abarriuso/bay2rack/README.md

# Bay2Rack — old PC case → 6" homelab rack

*[Leer en español](README.es.md)* · 

Towers used to come with 5.25" bays for CD drives. New cases don't, but ATX hasn't changed: that old case still
takes a modern motherboard. **Bay2Rack** is a parametric OpenSCAD adapter that screws into those bays and turns them
into a **6" mini rack**, so an old tower becomes the heart of a cheap homelab: a router with VLANs, switches,
KVM over IP, Raspberry Pi blades and a patch panel, right in the front of the case.

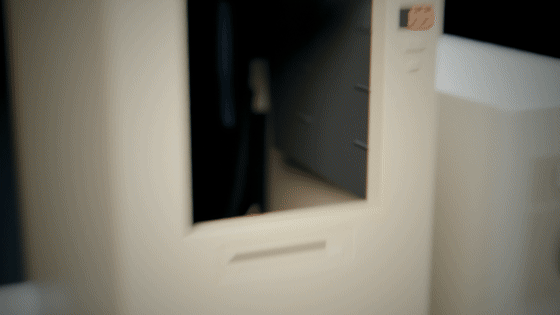
[picture p1: docs/video/assemble.gif]
A beige 90s sleeper unfolds: a modern server inside, its 5.25" bays become a rack


> **[Open the web generator](https://bay2rack.pages.dev/)** ([mirror](https://abarriuso.github.io/bay2rack/) if that
> address does not load): say what you want in the bays (a fan or buttons, sockets, or a rack for devices), choose
> what goes in every rack unit and every patch panel port, see it mounted in a real PC case (or a 90s sleeper), and
> download a **kit (.zip)** with every STL, the bill of materials and the print settings. It all runs in your browser.
>
> **Just want to print?** Pre-built variants are in [`stl/`](stl/README.md), with the screws and inserts they need.
> Print the [test pieces](stl/README.md#tests) first and [tune the print fits](#printing).
>
> **Building one?** The [build guide](docs/BUILD.md) covers what to buy, the print order, the inserts, the
> assembly and the cables and power.

> **Work in progress.** Found a defect, a part that doesn't fit your case or a print problem? [Open an issue](https://github.com/abarriuso/bay2rack/issues)
> with photos and your case model. Measurements of other cases and rack gear, new modules and fixes are welcome as
> pull requests. Cases reported so far: [compatibility list](docs/CASES.md) · changes: [CHANGELOG](CHANGELOG.md).

Evolution of the original
[6" mini rack switch + patch panel in a 5.25" bay](https://www.reddit.com/r/minilab/comments/1vr8vc1/6_mini_rack_switch_patch_panel_in_525_bay/).

---

## What you can build

| | |
|---|---|
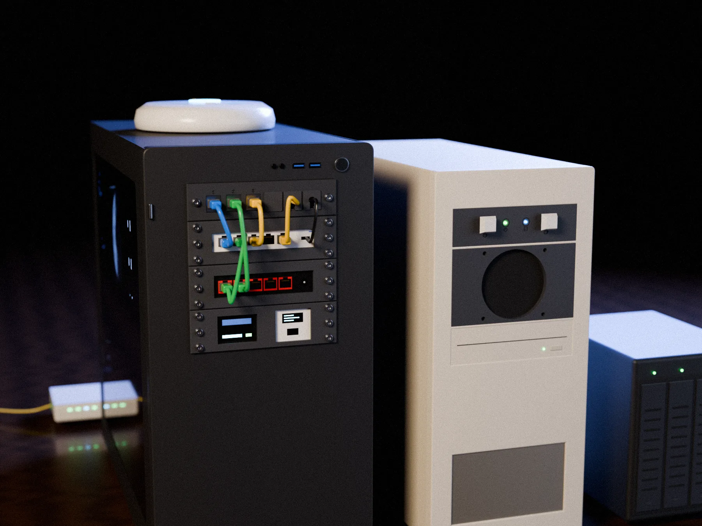
[picture p2: docs/gallery/router.webp]
Router with VLANs
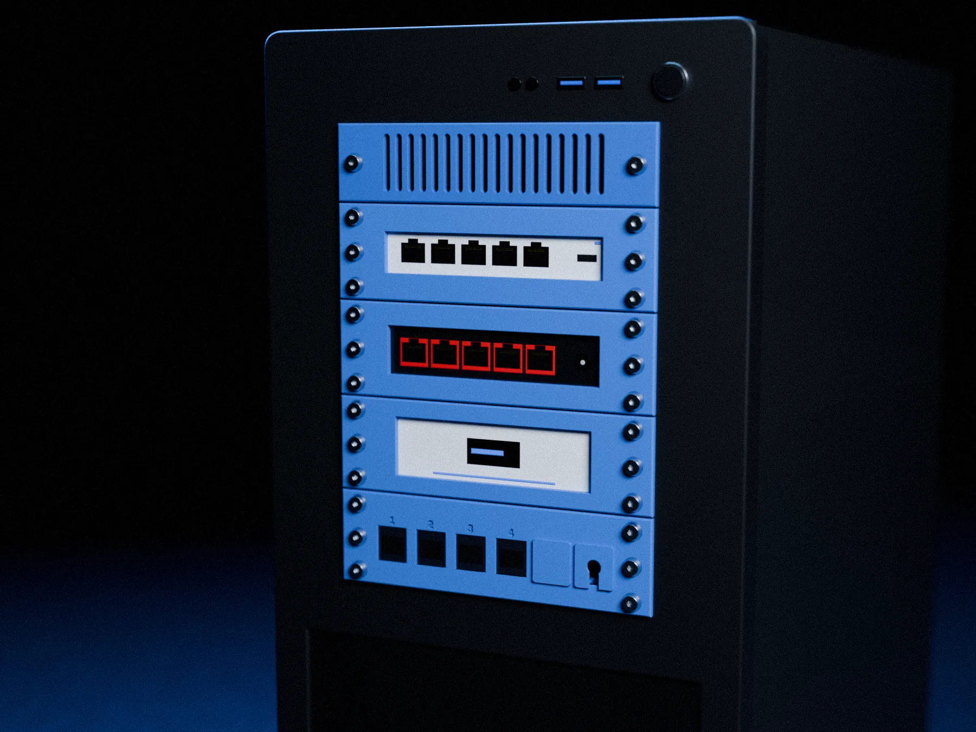
[picture p3: docs/gallery/network.webp]
Network rack
|  **Router with VLANs**: the PC runs OPNsense / pfSense with a 4-port network card; a managed UniFi switch carries the VLANs, a second switch the servers, JetKVM + NanoKVM, patch panel |  **Network rack**: 5 bays, two switches, a UniFi Express and a full patch panel |
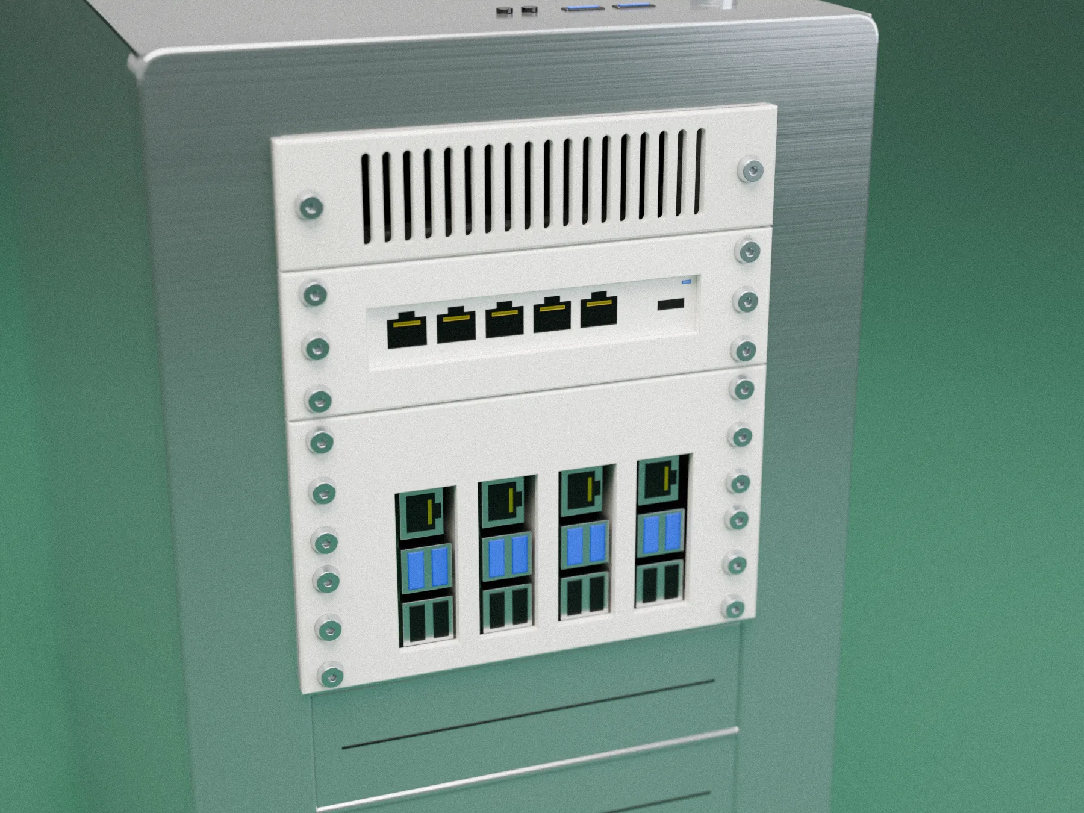
[picture p4: docs/gallery/pi.webp]
Raspberry Pi cluster
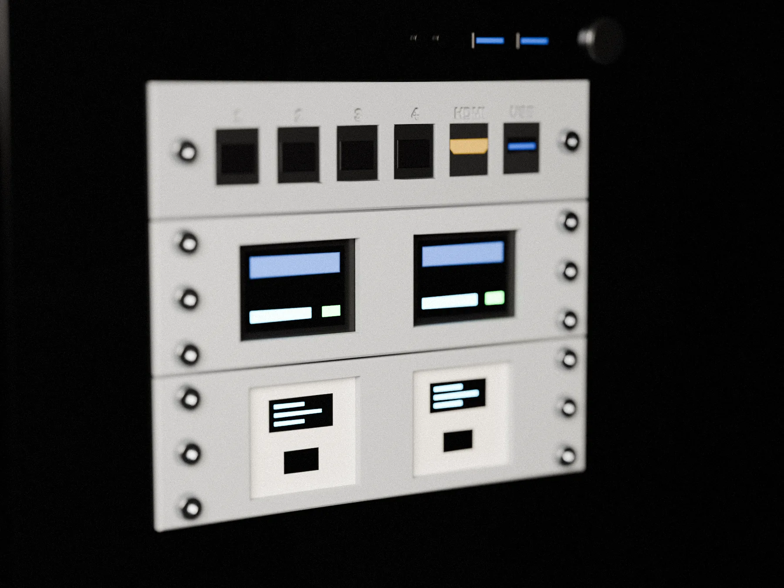
[picture p5: docs/gallery/kvm.webp]
KVM over IP
|  **Raspberry Pi cluster**: a UniFi switch and four Raspberry Pi 5 standing as 2U blades |  **KVM over IP**: two trays, two JetKVM and two NanoKVM, HDMI and USB keystones |
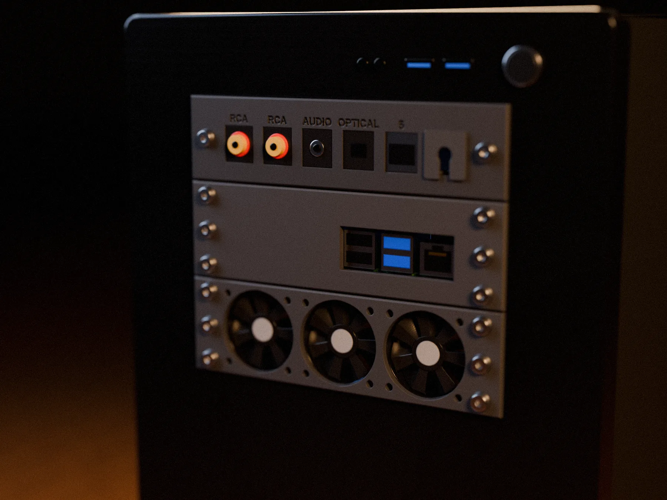
[picture p6: docs/gallery/audio.webp]
Audio
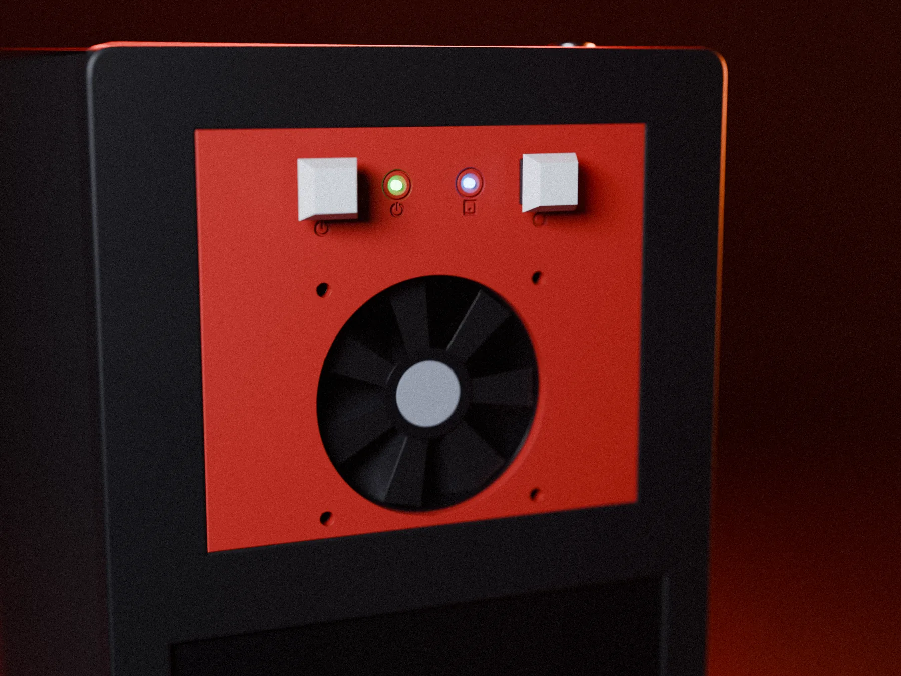
[picture p7: docs/gallery/client.webp]
Proxmox / TrueNAS box
|  **Audio**: a Raspberry Pi 4 streamer, three 40 mm fans, RCA, 3.5 mm jack and Toslink keystones |  **Proxmox / TrueNAS box**: no rack, just a front panel with an 80 mm fan and a power / reset button panel |
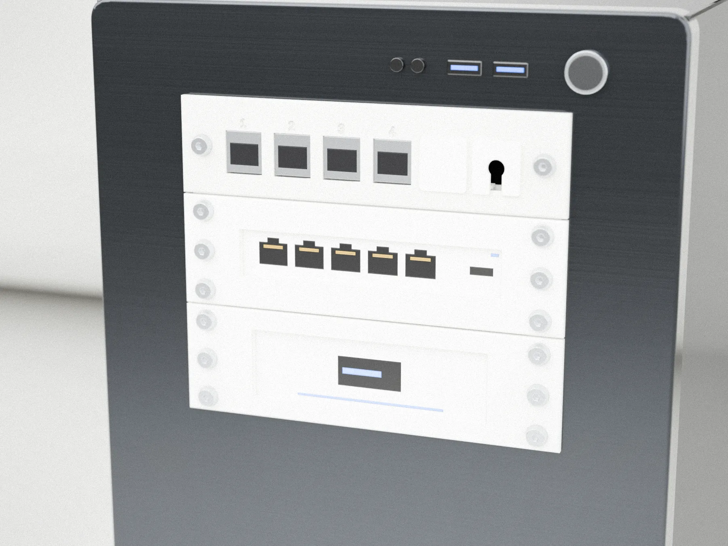
[picture p8: docs/gallery/unifi.webp]
UniFi
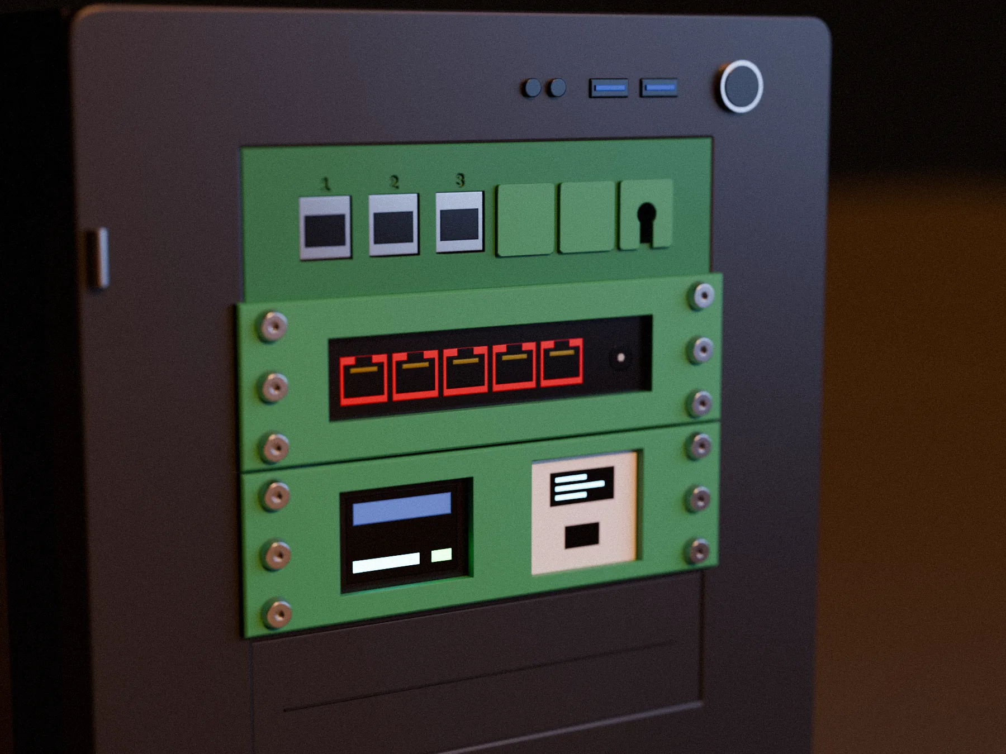
[picture p9: docs/gallery/bezel.webp]
CD-drive front
|  **UniFi**: Flex Mini switch and UniFi Express |  **CD-drive front**: an exact 5.25" bezel, flush with the case front |

## A homelab from old PCs

The router keeps its rack in the bays: the switches, the KVMs over IP and the patch panel. The network cables of the
other machines (a Proxmox node, a TrueNAS box and an access point) come in through **printed brackets in two PCI
slots** at the back and end in the keystones behind the patch panel; short patch cords on the front connect them to
the switches. Cable colours are VLANs: clients, servers, the trunk to the access point and the WAN from the
router's network card to the fibre box.

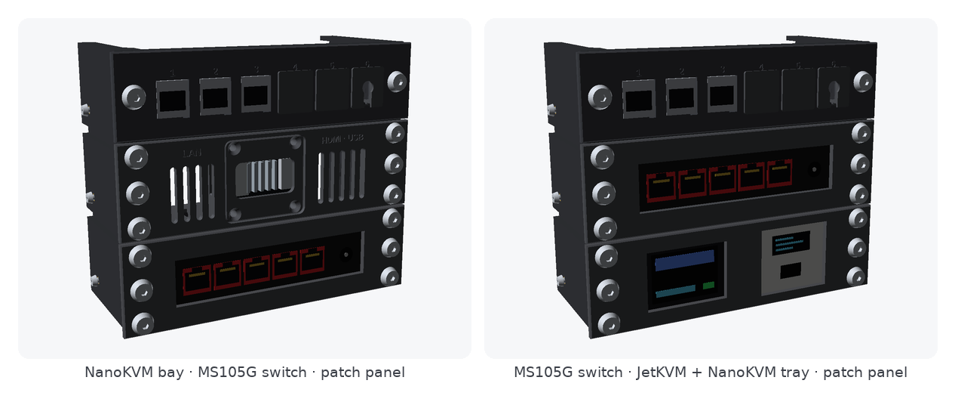
[picture p10: docs/img/homelab.png]
The rack with the NanoKVM bay, the switch and the patch panel


## The height problem

A 5.25" bay is 41.53 mm tall and stacked bays repeat every ~43.18 mm. A rack unit is 44.45 mm.
So **N bays never hold N U inside the stack**. The deficit grows by 1.27 mm per bay:

| Bays | Stack height | Flush (inside the stack) | Spare zone | Overhang (N U) | Panels stick out |
|-----:|---:|---:|---:|---:|---:|
| 1 | 41.1 mm | 0U | 41.1 mm | 1U | +3.3 mm |
| 2 | 84.3 mm | 1U | 39.9 mm | 2U | +4.6 mm |
| 3 | 127.5 mm | 2U | 38.6 mm | 3U | +5.9 mm |
| 4 | 170.7 mm | 3U | 37.3 mm | 4U | +7.1 mm |
| 5 | 213.9 mm | 4U | 36.1 mm | 5U | +8.4 mm |
| 6 | 257.0 mm | 5U | 34.8 mm | 6U | +9.7 mm |

The design handles this with **one parametric model** instead of one model per bay count.

## Variants

Two independent choices give four families. The pre-built files cover 1–3 bays (1–4 for `plate-flush`); the model goes up to 6:

| | **Flush**: N−1 U + spare zone, nothing sticks out | **Overhang**: N bays = N U |
|---|---|---|
| **Plate front**: flat frame behind the rack panels | `plate-flush`: the spare zone takes a **swappable filler** (6-port patch, vent, blank) | `plate-overhang`: the frame is a few mm taller than the stack |
| **Bezel front**: the exact outline of stacked 5.25" drive bezels | `bezel-flush`: flush with the case front like an original drive, patch panel cut into the bezel | `bezel-overhang`: the bezel stays flush, only the rack panels overlap the case front |

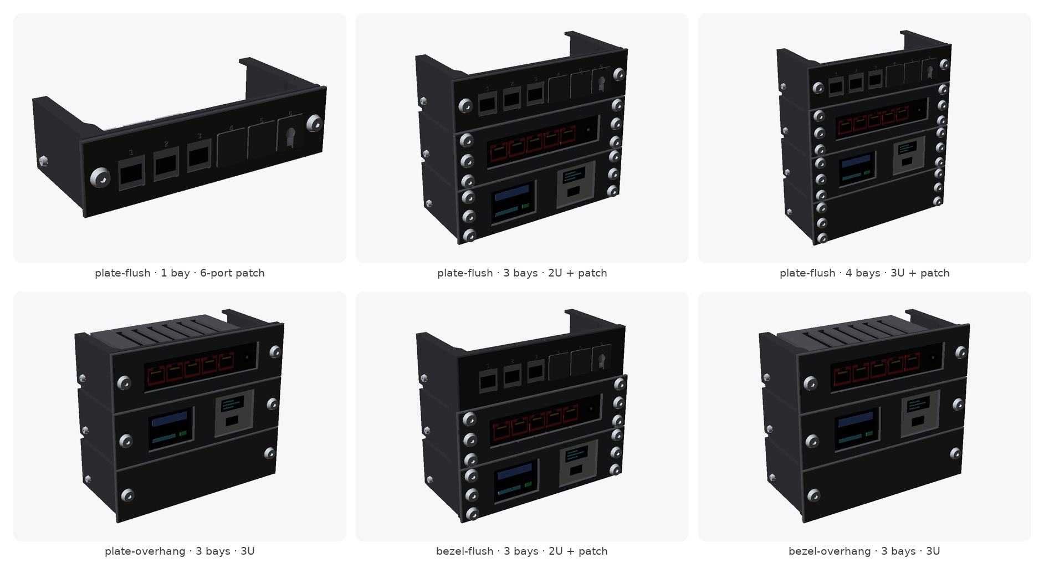
[picture p11: docs/img/variants.png]
The four families


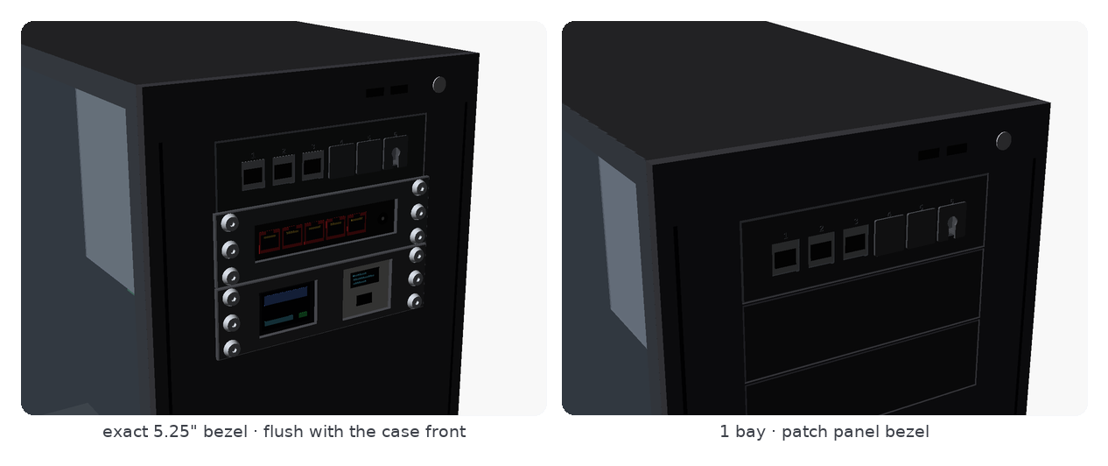
[picture p12: docs/img/mounted.png]
Mounted in a PC tower


Use the plate front when your case front is flat at the drive bays. If the case has a plastic front that
stands out from the metal, use the bezel front and set `bezel_depth` to how far that front stands out.

Other knobs: `units_override`, `overhang_align` (center/top/bottom), `spare_pos` (top/bottom/split),
and the spare-zone fill (`keystone`, `buttons`, `vent`, `cable`, `label`, `fan40`, `fan60`, `fan80`, `fan92`, `fan120`, `blank`).
The fill can be `separate` (a screw-on panel in the same plane as the rack accessories) or `integral` (cut into the frame).

## Rack modules

`rack_modules` lists what goes in every rack unit, top first. Every module is a separate print (1U; the blades and the 60 / 80 mm fans 2U,
the 92 / 120 mm fans 3U) that screws to the rack holes:

| Module | |
|---|---|
| `ms105g` | 5-port switch, **Mercusys MS105G** size (105 × 24.9 × 70 mm, W × H × D; set your switch's size): it slides into a tunnel from the back, the front window leaves the 5 ports and the power jack free, a zip tie behind it holds it |
| `uswflex`, `ux` | **UniFi USW-Flex-Mini** (managed, VLANs) and **UniFi Express** in the same kind of tunnel |
| `kvm:jet+nano` | **KVM over IP tray**: 1 to 3 boxes of your choice side by side (`jet` JetKVM, `nano` NanoKVM, `custom`), e.g. `kvm:nano+nano`; it warns when they don't fit |
| `pi:pi5` | **Raspberry Pi tray**: Pi 5 / 4 / 3 or Zero flat on M2.5 standoffs, USB and Ethernet through the front; two boards side by side with PoE HATs |
| `piblade:pi5+pi5+pi5+pi5` | **2U Raspberry Pi blades**: up to four boards on edge, each on its own fin, standoffs that print without supports |
| `nkvm:side` / `nkvm:ks` | **NanoKVM Lite bay** with a lid on M3 heat-set inserts, the heatsink in the open. `side`, **outside the case**: standing in a little mountain, its ports open at both sides so you plug in from outside; the cables run outside or into the case through slots at the ends; three pieces (plate, mountain, lid), `nkvm_split = false` prints the plate and the mountain in one. `ks`, **inside the case**: the Ethernet port comes out at keystone 1 (`nkvm_keystones = 2` adds a second one), the NanoKVM flat right behind it with a straight 10 cm patch cable (`nkvm_patch`); two pieces |
| `dev1`, `dev2` | A made-to-measure tray for any device: set its width, height and depth |
| `fan40`, `fan60`, `fan80`, `fan92`, `fan120` | **Fan panels**: up to three 40 mm fans in 1U, two 60 mm or one 80 mm in 2U, one 92 mm or 120 mm in 3U, behind round openings or a hex grille (`fan_guard`); `fan_count` caps how many go side by side |
| `patch` | 1U patch panel with the ports you choose: a bare `patch` takes `ks_ports_list` / `ks_names`, `patch:rj45m=NAS+hdmi+cover` has its own (port type, `=` its name, `_` for a space) |
| `buttons` | 1U button panel (see below) |
| `vent`, `blank`, `cable`, `label` | Vented (slots, louvres, honeycomb or holes), blank, cable pass-through and label panels (`label` says `label_text`, `label:MY_LAB` its own text) |

A module can take more than one unit (the blades and the bigger fans): the rack is filled from the top and a module that no
longer fits becomes a blank.

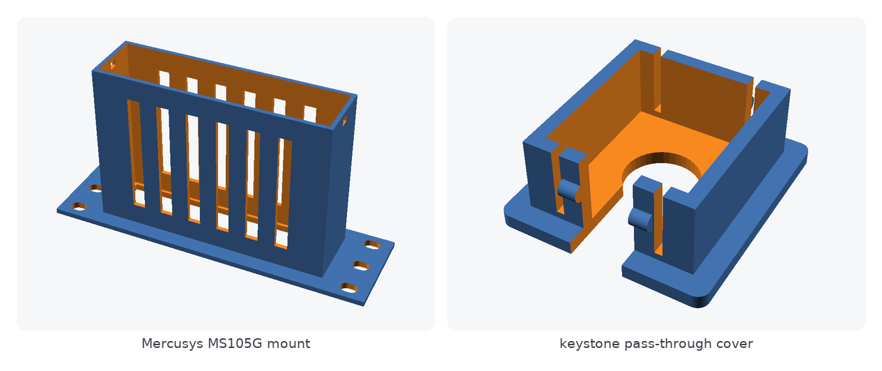
[picture p13: docs/img/modules.png]
Switch mount and keystone pass-through cover


## Keystones

The patch panel takes up to 6 ports in a 1U row and more rows when it is taller (12 in a 2U panel), with engraved
numbers or your own names (`ks_names`).
`ks_ports_list` sets **every port**: `rj45m` (metal / shielded RJ45), `rj45`, `hdmi`, `usb`, `rca`, `jack` (3.5 mm),
`toslink` (standard keystones),
`cover` (a plain printed cover for an unused port), `pass` (a split pass-through cover that clips around a cable, e.g.
the switch power cable) or `none`. Both covers are pushed in from the front and click behind the opening.

- **Metal holder cell** (default, `ks_style = metal`), replicated from the original bay adapter: a 15 × 16.5 mm front
  opening, a latch ramp, a 24.3 mm cavity and rear lips that catch the jack, which goes in from the back. It is 9.5 mm
  deep, with 2 mm walls and a 20 mm pitch; every dimension is a parameter (`ksm_*`).
- **Standard cut-out**: 14.9 × 16.4 mm in a 2 mm plate for plastic snap-in keystones (HDMI, USB and plastic RJ45 use it).

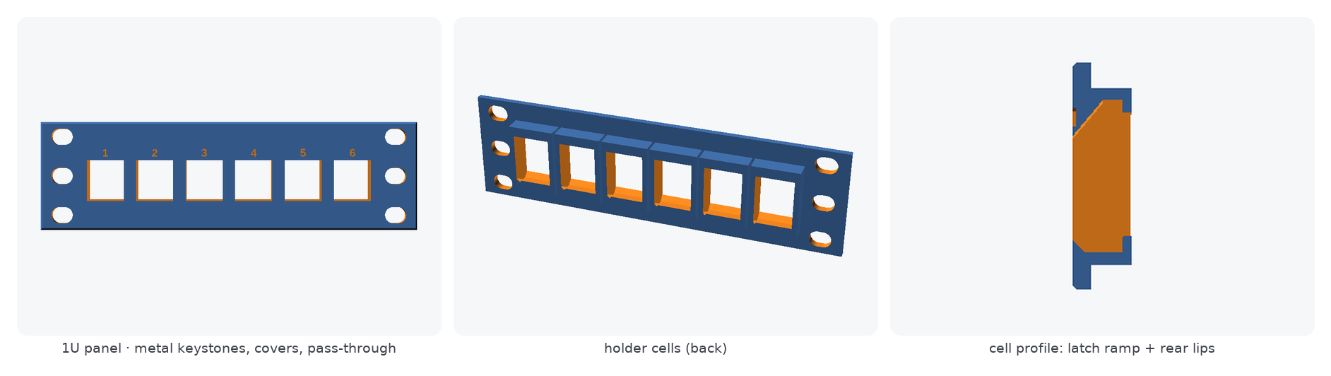
[picture p14: docs/img/keystone.png]
Metal keystone holder


## Button panel

A fill or a 1U module with **power and reset buttons** plus **power and disk-activity LEDs** (3 or 5 mm), wired to
the motherboard's front-panel header. Three kinds of button (`btn_type`):

- `mx`: normal keyboard switches (Cherry MX compatible: 14 mm cut-out in a 1.5 mm plate, any 1u keycap).
- `metal`: the metal push buttons sold for PC cases, 12–22 mm (`btn_metal_d`), with their LED ring.
- `retro`: printed caps on 12 × 12 mm tactile switches held by a printed carrier, a big POWER, RESET and an
  optional TURBO (`btn_turbo`) like the beige 90s PCs, with named LEDs and pinstripes.

Three LED designs, all printable front face down:

- `ring`: a countersunk hole with an engraved ring; the LED dome sticks out by `led_protrude`.
- `halo`: a thin ring of light around each key.
- `glow`: invisible when off; the LED shines through a 0.6 mm skin and the engraved icon lights up (print it in white or natural).

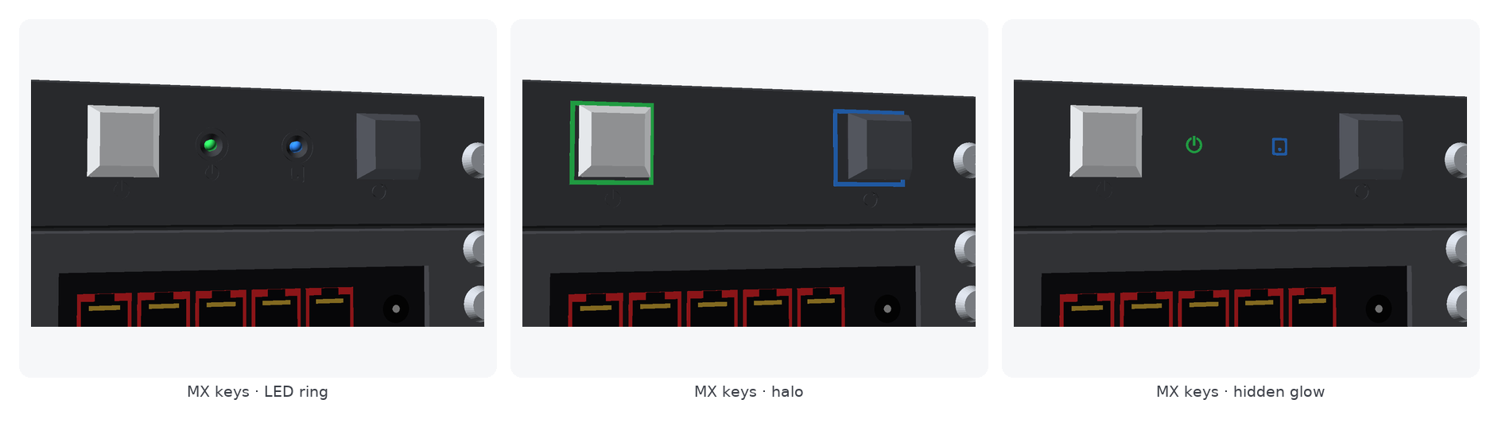
[picture p15: docs/img/buttons.png]
Button panel: ring, halo and hidden glow


## It goes in like a drive

| Adapter v2, from behind | From the front |
|---|---|
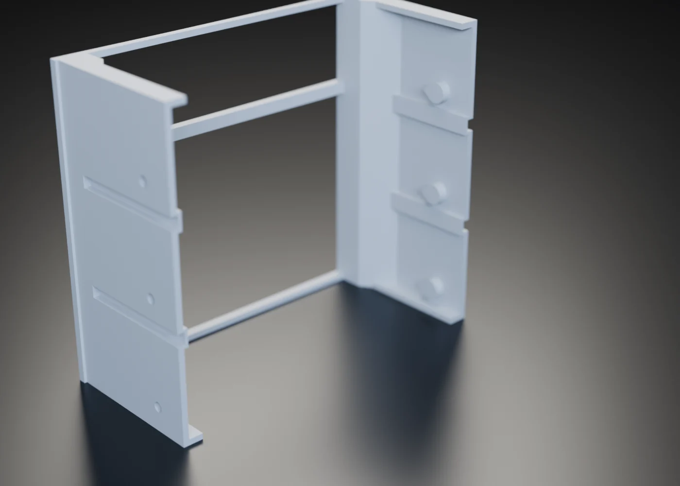
[picture p16: docs/img/adapter-v2-back.webp]
Adapter v2 from behind: tab grooves outside, ribs, lips and bay-screw inserts inside
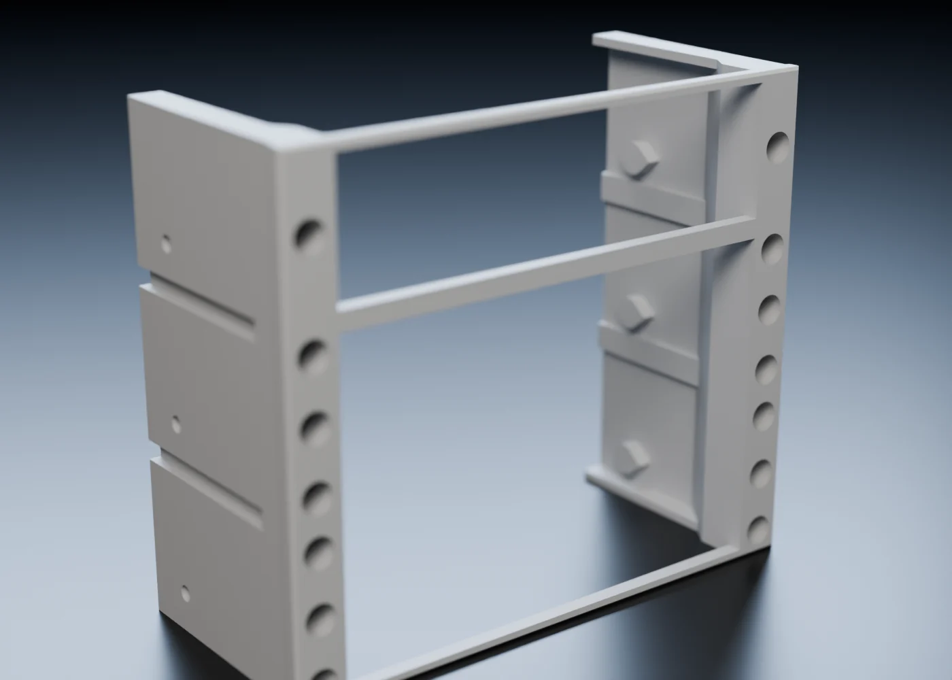
[picture p17: docs/img/adapter-v2-front.webp]
Adapter v2 from the front: frame and rack posts
|  |  |

- **Grooves for the metal tabs between the bays.** Many cages have lanced ledges in the gap between two bays that
  the drives rest on. The adapter has a groove for them along the whole sleeve (with a rib inside so the wall keeps
  its strength), so you don't have to bend them flat.
- **Stiff side walls**: an inner lip along their top and bottom edges and a fillet into each rack post, all outside
  the rack opening.
- Bay screws, heat-set inserts or nuts; the fan openings (40 to 120 mm) are round holes or a hex grille
  (`fan_guard`).

## Rack standard

There is no official 6" standard, so this project uses **the 10" mini rack rules on a 6" width**:

- 152.4 mm (6") panels
- **134.925 mm hole spacing**: the same 8.74 mm edge-to-hole inset as the 10" standard (254 mm panel, 236.525 mm spacing)
- EIA-310 vertical hole pattern (6.35 / 22.225 / 38.1 mm in each U), 1U = 44.45 mm
- M6, 10-32 or 12-24 screws, or M5 (the default: more plastic to the bay side, and it still goes through M6 holes)

If your gear differs, set `rack_std = custom`.

## Hardware

| | Options |
|---|---|
| Rack screw | M3, M4, M5, M6, 10-32, 12-24 |
| Head | button (ISO 7380), socket (ISO 4762), countersunk (ISO 10642, adds countersinks to panels), pan (ISO 7045) |
| Rack fixing | heat-set insert, self-tapping, hex nut trap, square nut side slot, sliding square-nut channel (screws at any height). Nuts need M5 or smaller (hex nut: M4): an M6 nut leaves no plastic between the post and the side of the bay, and the model warns |
| Bay screw | M3 or 6-32, with heat-set insert, self-tapping, hex nut or clearance + loose nut |
| Overrides | `rack_insert_d/l`, `bay_insert_d/l` for your inserts; `rack_screw_len`, `bay_screw_len` (0 = auto) |

The model **chooses the right standard screw length**, metric or imperial. It uses the accessory
ear thickness, the case sheet thickness and the fixing type, and warns when nothing fits.
Every render prints a bill of materials:

```
BOM | rack accessories: 12 x M5 x 10 button head  +  12 x M5 heat-set insert (hole 6.4 x 9.5 mm)
BOM | filler panels: 2 x M5 x 10 button head  +  2 x M5 heat-set insert (hole 6.4 x 9.5 mm)
BOM | drive bay: 6 x M3 x 5 pan head  +  6 x M3 heat-set insert (hole 4.2 x 5.7 mm)
```

The preview draws screws, inserts and nuts in place (`show_hardware`). `explode` pulls the parts apart,
and `section` cuts the model open so you can see each fixing inside the plastic.

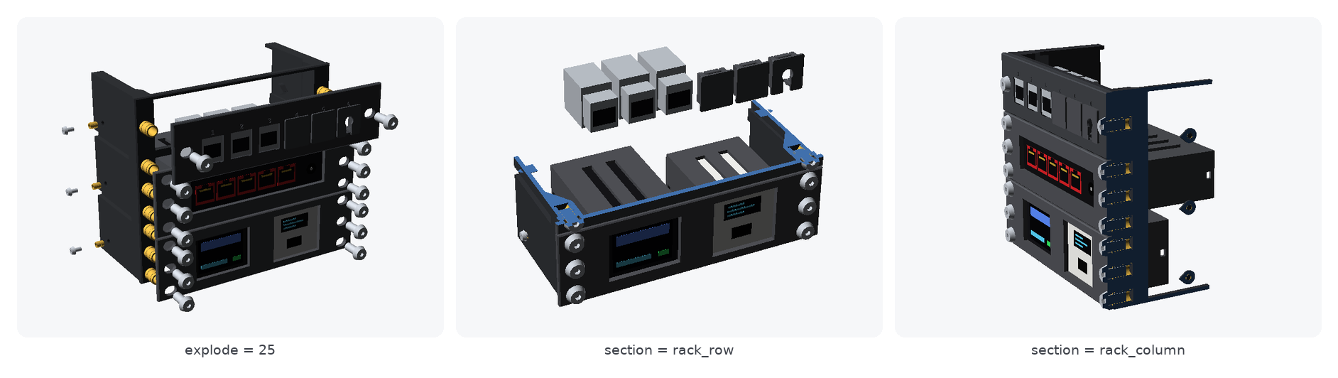
[picture p18: docs/img/hardware.png]
Hardware preview


## Bay standard

The defaults follow SFF-8551 / EIA-741 (5.25" devices): width 146.05 mm, height 41.53 mm,
bezel 148 × 42.3 mm, M3 side holes 10 mm above each bay's bottom and 47.4 mm from the front.
A rear hole at 126.65 mm and a second row at 21.84 mm are optional. **Cases vary, so verify these
numbers** with the `test_bay` piece. Use `bay_hole_offset` / `bay_hole_slot` to adjust, or set `bay_std = custom`.

## Printing

> [!IMPORTANT]
> **Print the test pieces first** (they come in every kit and in [`stl/tests`](stl/README.md#tests)). Every printer
> and filament prints a little tight or a little loose, so check each fit and move its tolerance before printing
> the big parts:
>
> | Test piece | What it checks | If it is tight | If it is loose / off |
> |---|---|---|---|
> | `test_keystone` | the keystone jack clips in | raise `ks_fit` (+0.1 to +0.2) | lower `ks_fit` (negative) |
> | `test_bay` | the sleeve slides into the bay, the side holes line up | raise `sleeve_clearance` | holes off: `bay_hole_y1`, `bay_hole_z1`, `bay_hole_offset` |
> | `test_rack` | rack hole spacing and the rack inserts; with its inserts in, it must still slide into a bay | holes don't line up: `rack_hole_slot` | insert spins: lower `rack_insert_d`; goes in crooked: raise it |
> | `test_button` | the MX key, metal push button or printed cap fits | MX: raise `mx_cut` | MX: lower `mx_cut` |
>
> In a kit they are `tests/test_*.stl`; in [`stl/tests`](stl/README.md#tests) they are `bay-plate` / `bay-bezel`,
> `rack-M5-heatset`, `keystone-metal` / `keystone-standard` and `button-mx` / `button-metal-16` / `button-retro`.
> The rest follow the same idea: `cover_clear` for the keystone covers, `mount_clear` for the devices in the rack
> modules, `nkvm_insert_d` and `bay_insert_d` for the small heat-set inserts. In the web generator they are in the
> **Adjust after the test prints** step.

- The STL files are already oriented **front face down**. Walls and posts rise vertically, and window
  roofs and screw bosses are 45° teardrops, so **no supports** are needed.
- PETG or ABS/ASA is recommended inside a warm case; PLA works for cool cases.
- 3–4 perimeters, 20–30 % infill.
- 3 bays print at 148 × 128 mm on the bed, about 66–70 mm tall.
- Inserts, assembly, cables and power: see the [build guide](docs/BUILD.md).

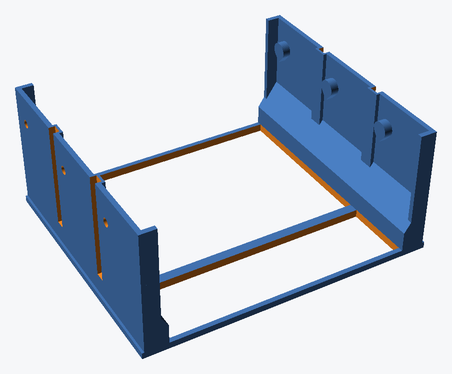
[picture p19: docs/img/print.png]
Print orientation


## Customizing

- **Web generator:** [bay2rack.pages.dev](https://bay2rack.pages.dev/) (mirror on
  [GitHub Pages](https://abarriuso.github.io/bay2rack/), built from the same `main`) runs OpenSCAD compiled to
  WebAssembly in the browser: a simple step-by-step mode with hover help, an "Every parameter" form for the rest,
  shareable links, the bill of materials, single-part STL / coloured 3MF downloads and a kit .zip with every STL.
  The source is in `web/` (Vite + pnpm); `corepack pnpm --dir web dev` runs it locally, and `pnpm --dir web test:e2e`
  tests the built site in a browser (Playwright). It installs as an app and works offline after the first visit.

- **OpenSCAD Customizer:** open `src/bay2rack.scad` and use *Window → Customizer*. Every variant is a preset
  in the dropdown. Press F5 to preview (the adapter is shown mounted in a PC tower, `case_view`) and F6 to render.
- **Command line:**
  ```bash
  openscad -o adapter.stl -D 'part="adapter"' -D bays=3 -D 'front_style="bezel"' src/bay2rack.scad
  ```
- **Rebuild everything:** `python scripts/build.py` regenerates the presets, every STL and `stl/README.md`.
  `python scripts/render_docs.py` regenerates the images.

Every render prints a summary line, the BOM and a `WARNING`/`NOTE` whenever the screws, inserts or fills don't fit.
`python scripts/test_models.py` renders the edge cases (1–6 bays, every front, fill, screw, fixing and module) and
every ready-made build of the configurator, and checks their warnings and bill of materials; it runs on every push.

### The film

Blender 5.2, Cycles (HIP), 1600×900, 60 fps (30 fps plus the in-between frames, `--between`), 17 s.
`scripts/blender/hero.py` builds the scene from GLB exports of the web viewer; `scripts/blender/encode.py` grades it
and writes MP4 (H.264), WebM (VP9) and the GIF.

| | | |
|---|---|---|
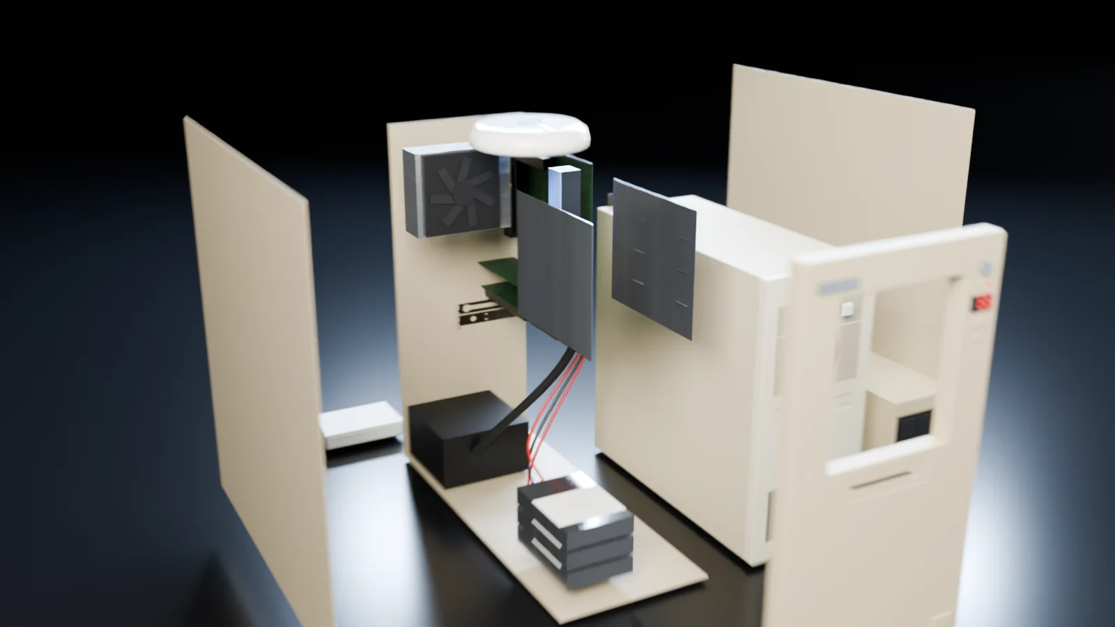
[picture p20: docs/img/film/unfold.webp]
The sleeper unfolds
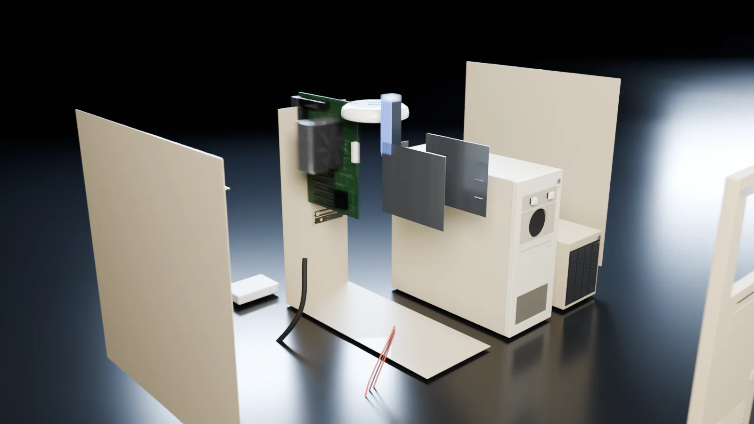
[picture p21: docs/img/film/server.webp]
A modern server inside
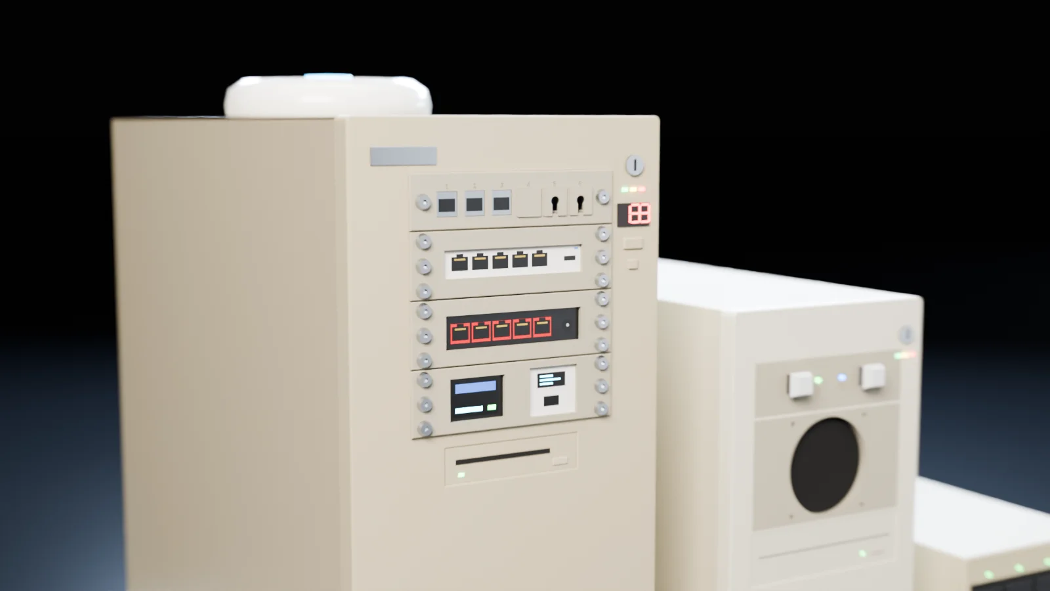
[picture p22: docs/img/film/front.webp]
The rack front
|  |  |  |
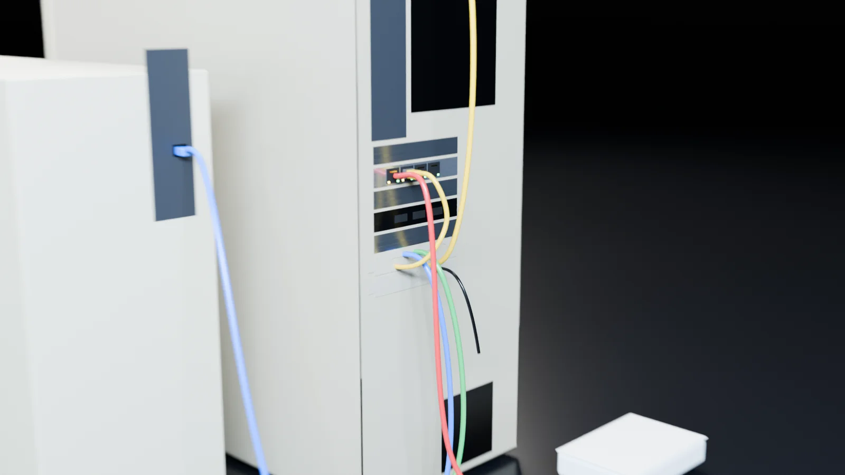
[picture p23: docs/img/film/cables.webp]
Cables through the PCI slots
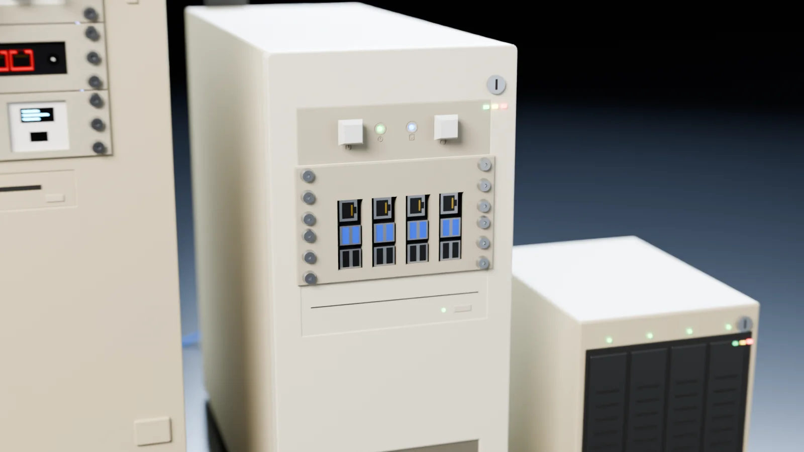
[picture p24: docs/img/film/pi-cluster.webp]
Raspberry Pi blades in the Proxmox node
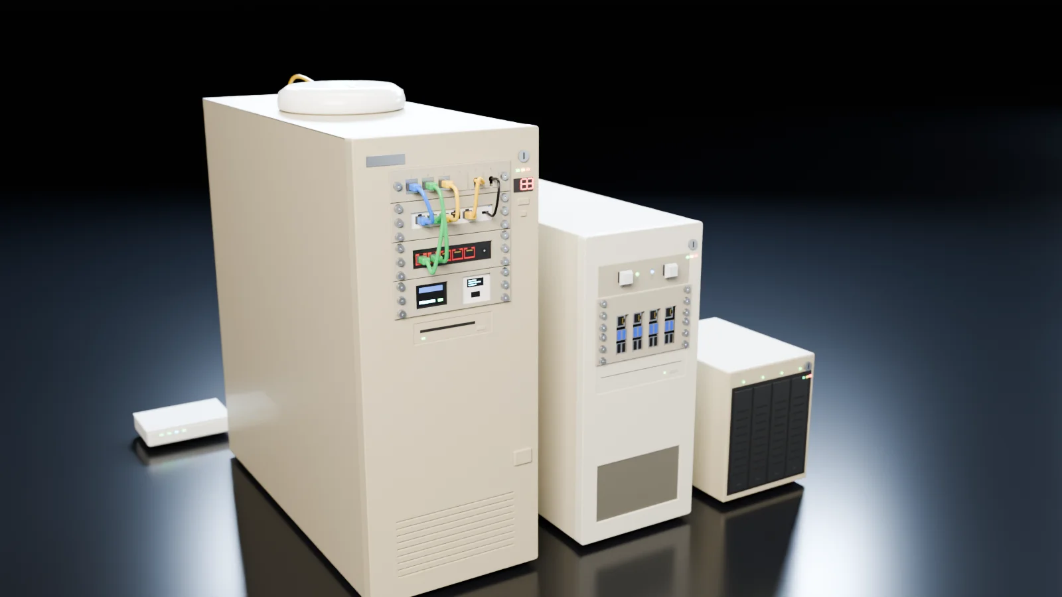
[picture p25: docs/img/film/hero.webp]
The homelab
|  |  |  |

## Repository layout

```
src/bay2rack.scad        all parameters (open this one)
src/bay2rack.json        Customizer presets (generated)
src/lib/
  standards.scad         screw / insert / nut tables, standard lengths
  config.scad            derived dimensions, checks, bill of materials
  util.scad              geometry helpers
  fills.scad             keystones (metal / standard), vents, cable, label, buttons, fans
  adapter.scad           rack fixings, bay sleeve, front frame
  panels.scad            fillers, rack panels, test pieces
  preview.scad           hardware models, sections, PC tower (preview only)
scripts/build.py         variant table -> presets + stl/ + stl/README.md
scripts/render_docs.py   README images
scripts/test_models.py   model tests (CI)
scripts/check_assemblies.py  every example and bays x fit x front assembly, no warnings (CI)
scripts/makerworld.py    MakerWorld upload kit (scripts/makerworld/: the descriptions)
scripts/blender/         the site's scroll film: scroll.py (the rack comes apart, a dark and a light version),
                         scroll_encode.py (its frames for the page, docs/scroll/); the README film: hero.py
                         (scene, materials, animation), encode.py (grade + MP4 / WebM / GIF);
                         product.py (the adapter shots in docs/img)
web/                     browser viewer + generator (Cloudflare Pages, Vite + pnpm)
stl/<family>/<variant>/  ready-to-print STLs, see stl/README.md
docs/BUILD.md            build guide: what to buy, print order, inserts, assembly, cables and power
docs/CASES.md            compatibility list and a case checklist
docs/img/, docs/gallery/ README and site images
```

## License

[CC BY-NC-SA 4.0](LICENSE): you may share and remix it with attribution, under the same
license, and **not for commercial use** without permission. For commercial licensing, contact the author.
