abarriuso/bay2rack/docs/gallery/audio-640.webp

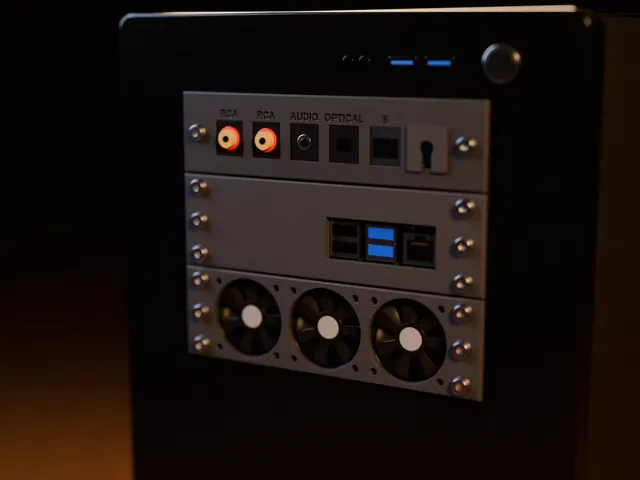
docs/gallery/audio-640.webp
