abarriuso/bay2rack/docs/gallery/audio-og.jpg

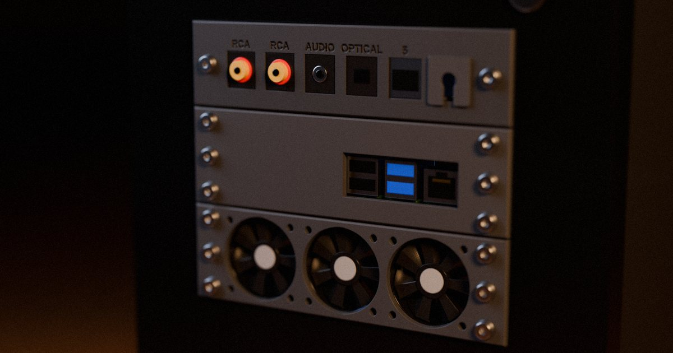
docs/gallery/audio-og.jpg
