abarriuso/bay2rack/docs/gallery/bezel-og.jpg

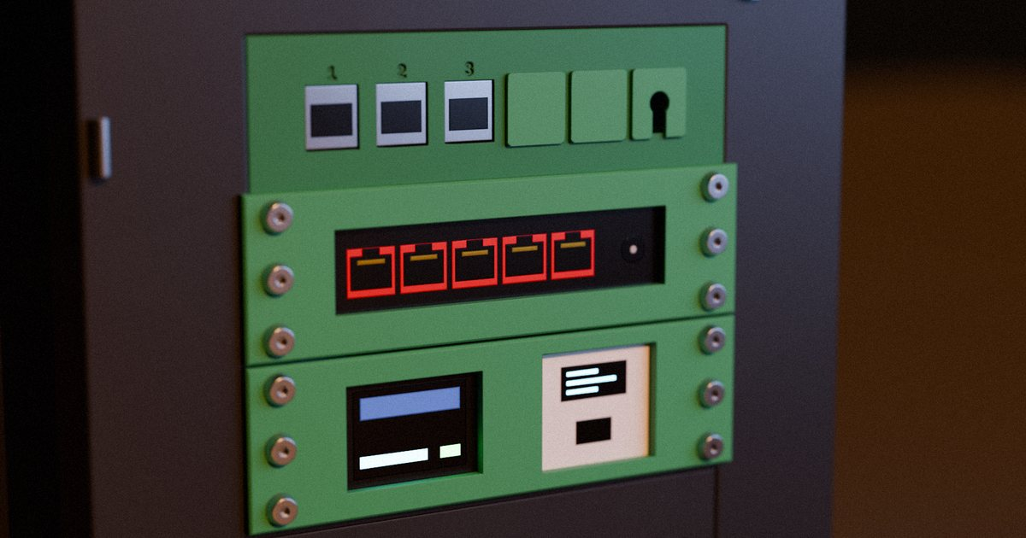
docs/gallery/bezel-og.jpg
