abarriuso/bay2rack/docs/gallery/client-og.jpg

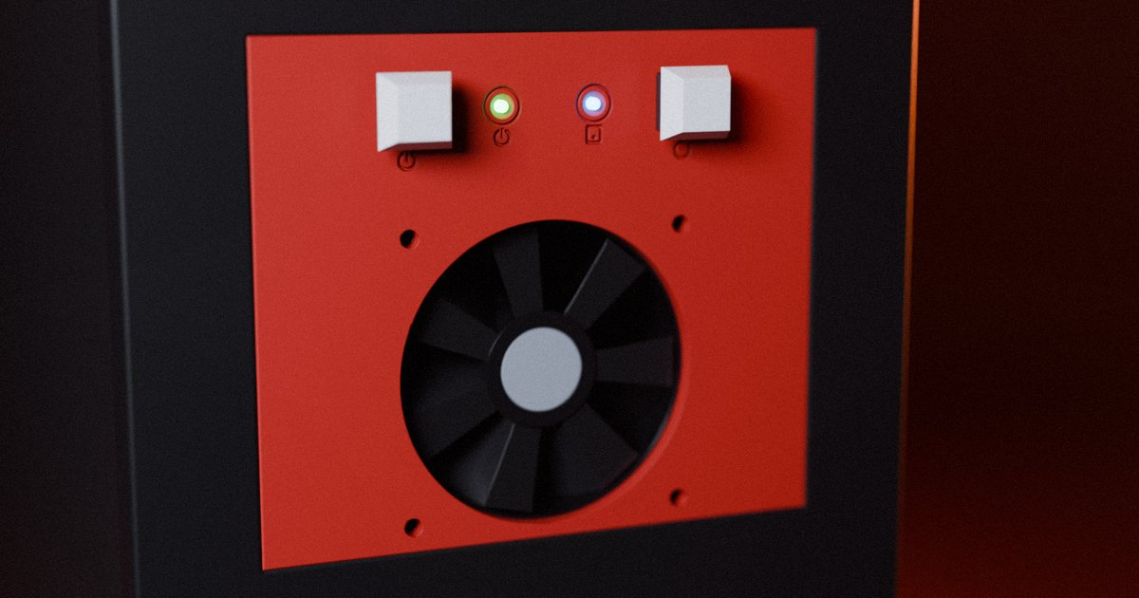
docs/gallery/client-og.jpg
