abarriuso/bay2rack/docs/gallery/kvm-og.jpg

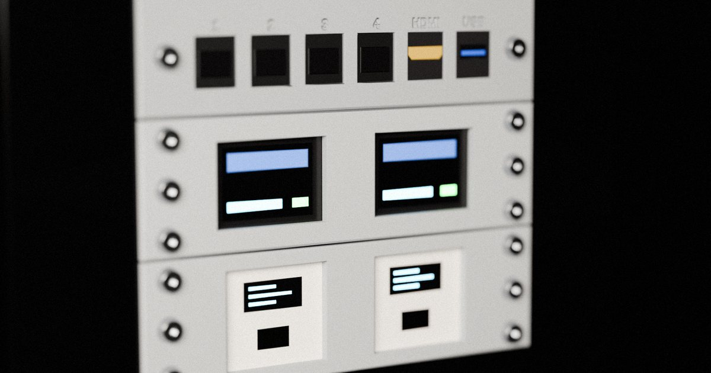
docs/gallery/kvm-og.jpg
