abarriuso/bay2rack/docs/gallery/network-og.jpg

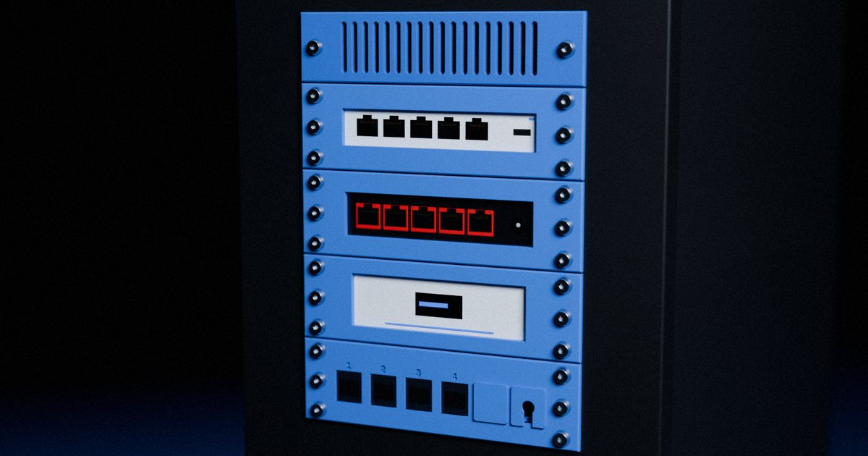
docs/gallery/network-og.jpg
