abarriuso/bay2rack/docs/gallery/pi-og.jpg

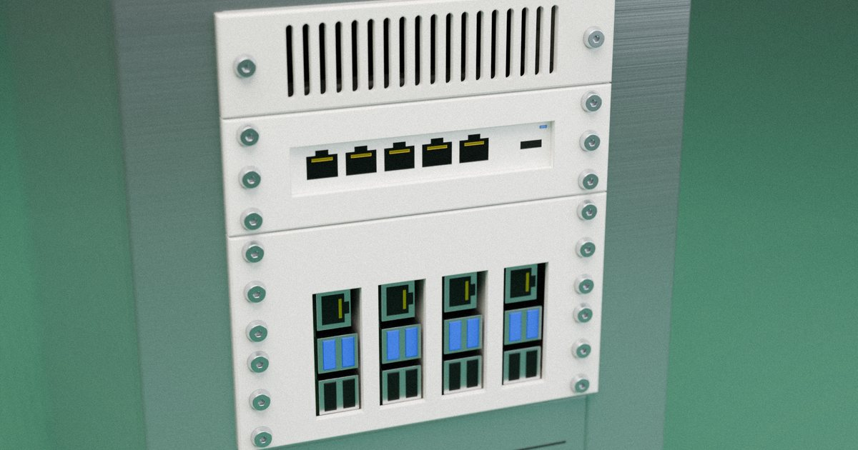
docs/gallery/pi-og.jpg
