abarriuso/bay2rack/docs/gallery/router-og.jpg

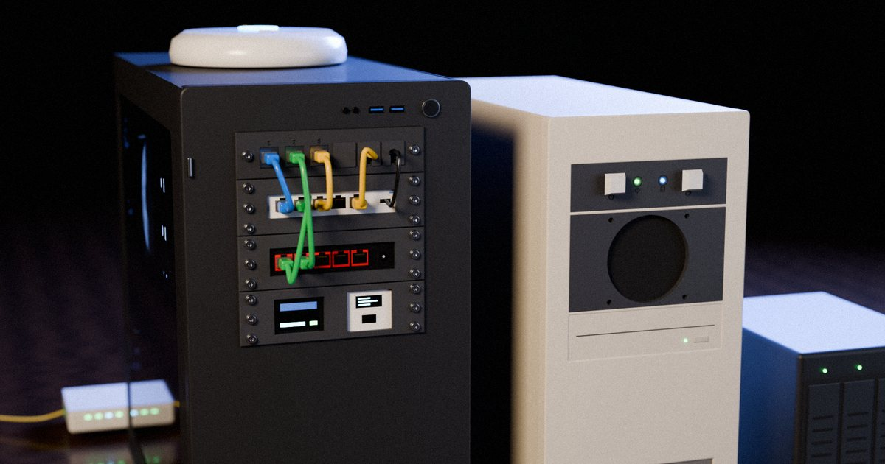
docs/gallery/router-og.jpg
