abarriuso/bay2rack/docs/gallery/unifi-og.jpg

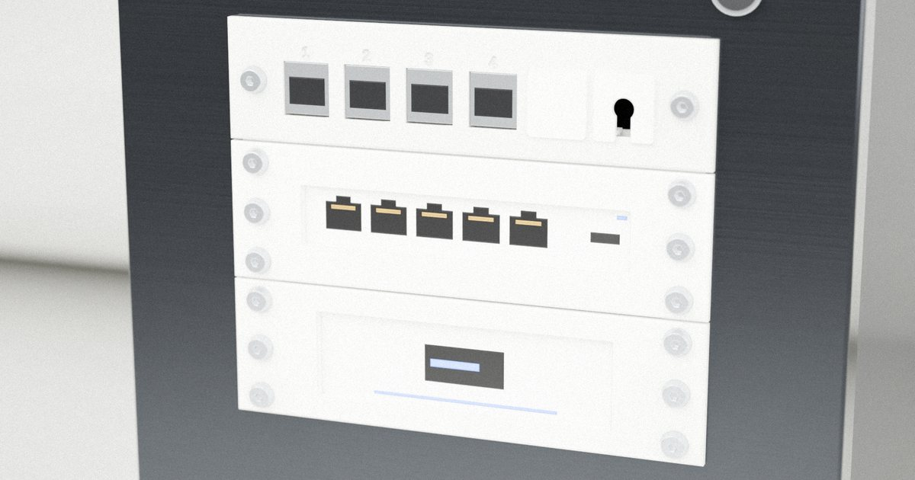
docs/gallery/unifi-og.jpg
