abarriuso/bay2rack/docs/img/og.jpg

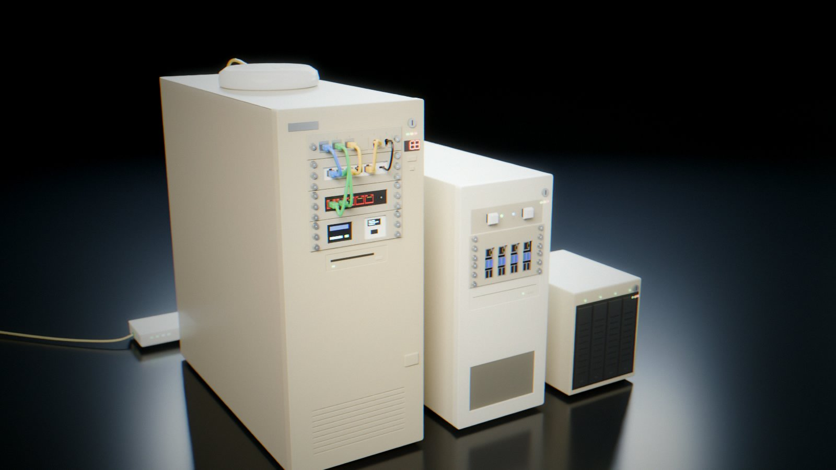
docs/img/og.jpg
