abarriuso/bay2rack/docs/scroll/dark/plate-1600.webp

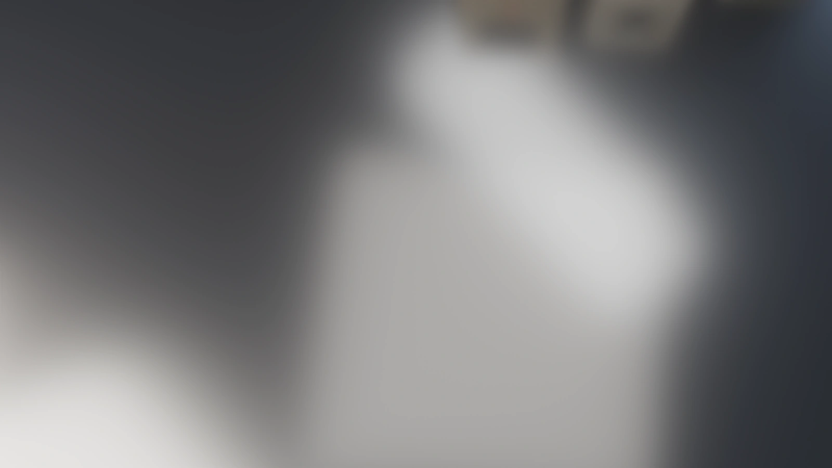
docs/scroll/dark/plate-1600.webp
