abarriuso/bay2rack/docs/scroll/light/plate-1600.webp

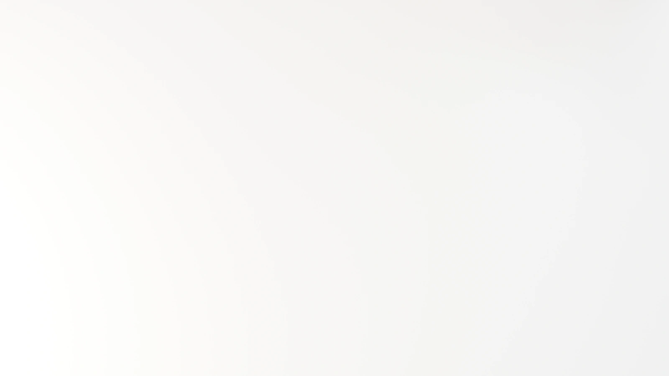
docs/scroll/light/plate-1600.webp
