abarriuso/bay2rack/docs/scroll/first.3mf

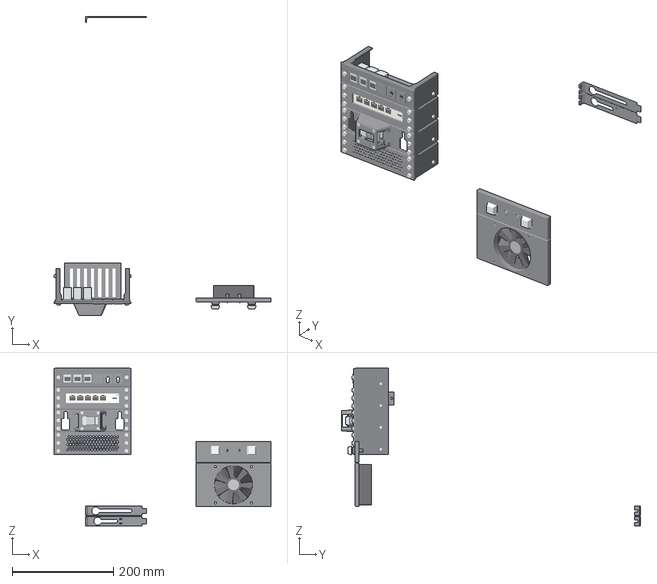
[picture p38: CAD file, 2026-11-13]
docs/scroll/first.3mf
428.6 x 591.2 x 311.7 mm
