abarriuso/bay2rack/stl/bezel-flush/1bay-patch6/adapter.stl

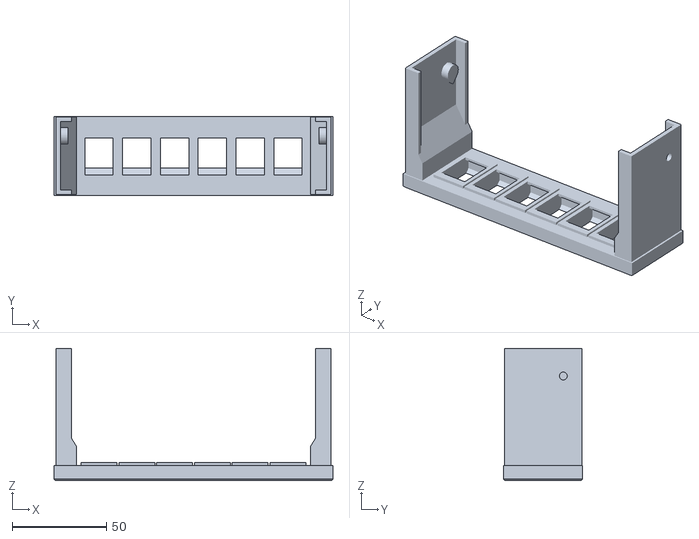
[picture p39: CAD file, 2026-10-22]
stl/bezel-flush/1bay-patch6/adapter.stl
147.7 x 42.0 x 70.0
