abarriuso/bay2rack/stl/bezel-flush/2bay-1U-patch6/adapter.stl

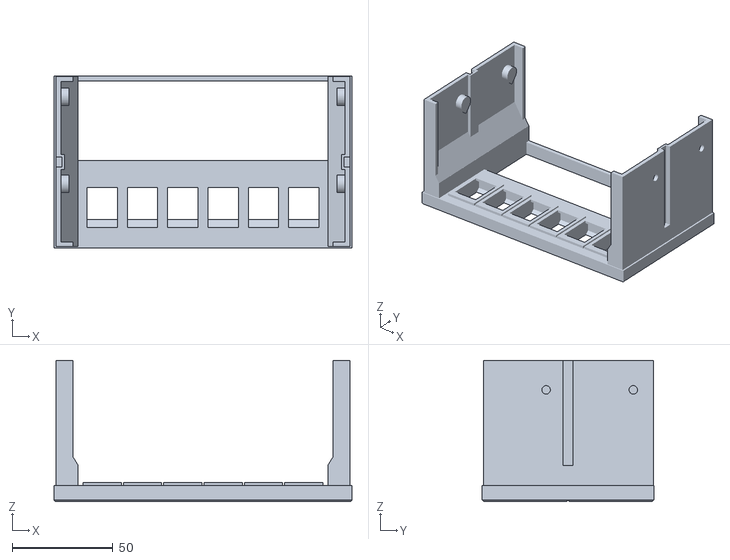
[picture p40: CAD file, 2026-10-22]
stl/bezel-flush/2bay-1U-patch6/adapter.stl
147.7 x 85.2 x 70.0
