abarriuso/bay2rack/stl/bezel-flush/3bay-2U-patch6/adapter.stl

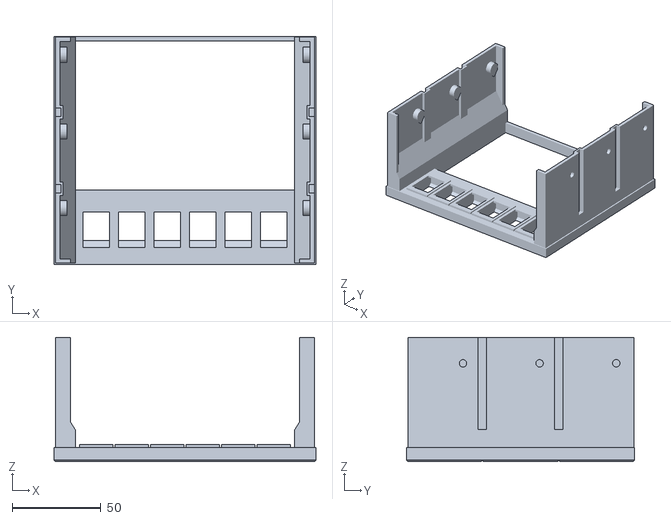
[picture p41: CAD file, 2026-10-22]
stl/bezel-flush/3bay-2U-patch6/adapter.stl
147.7 x 128.4 x 70.0
