abarriuso/bay2rack/stl/bezel-overhang/1bay-1U/adapter.stl

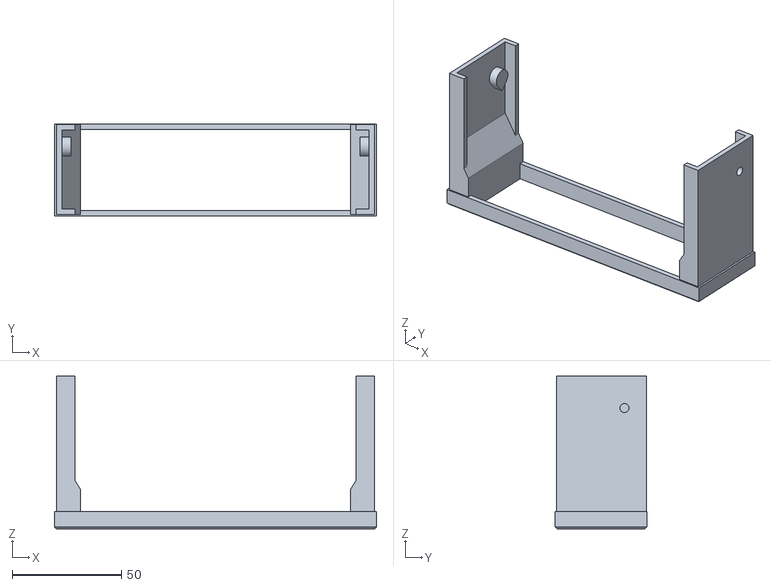
[picture p42: CAD file, 2026-10-22]
stl/bezel-overhang/1bay-1U/adapter.stl
147.7 x 42.0 x 70.0
