abarriuso/bay2rack/stl/bezel-overhang/2bay-2U/adapter.stl

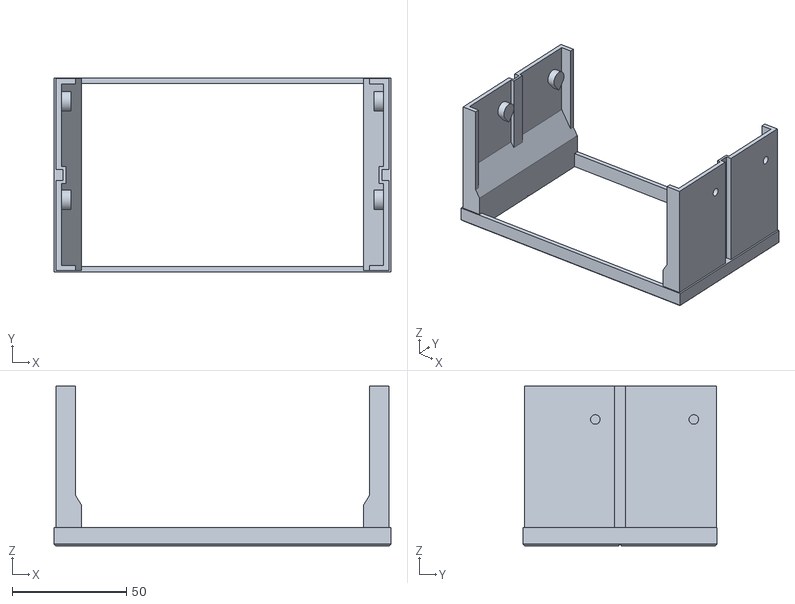
[picture p43: CAD file, 2026-10-22]
stl/bezel-overhang/2bay-2U/adapter.stl
147.7 x 85.2 x 70.0
