abarriuso/bay2rack/stl/bezel-overhang/3bay-3U/adapter.stl

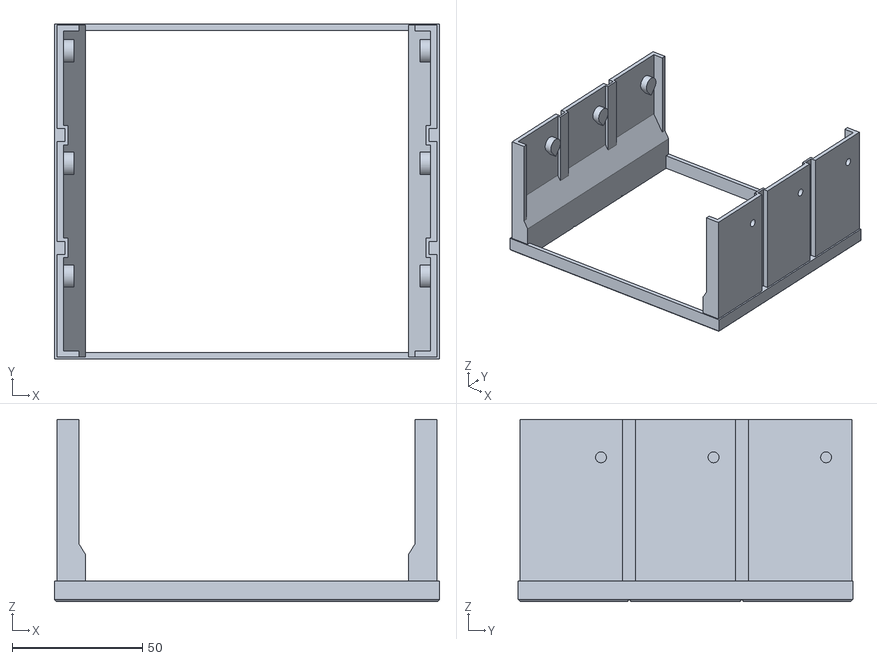
[picture p44: CAD file, 2026-10-22]
stl/bezel-overhang/3bay-3U/adapter.stl
147.7 x 128.4 x 70.0
