abarriuso/bay2rack/stl/bezels/1bay-vent/adapter.stl

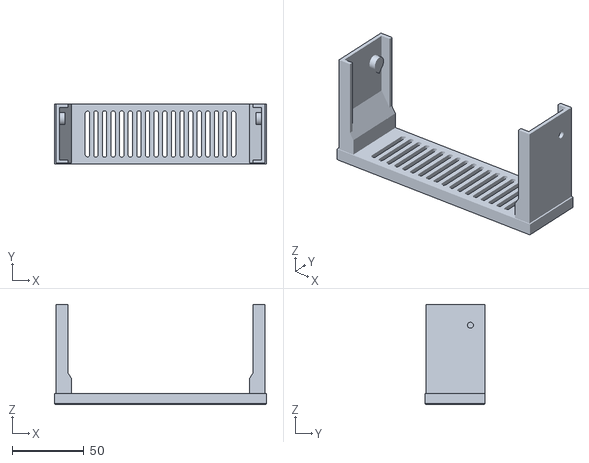
[picture p46: CAD file, 2026-10-22]
stl/bezels/1bay-vent/adapter.stl
147.7 x 42.0 x 70.0
