abarriuso/bay2rack/stl/bezels/2bay-fan80/adapter.stl

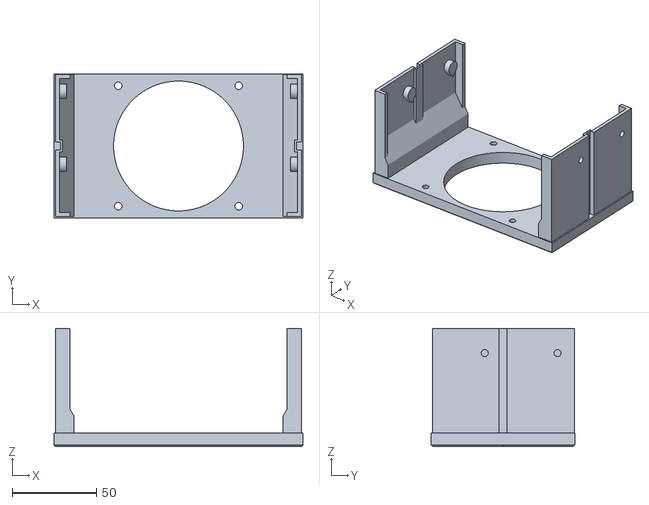
[picture p47: CAD file, 2026-10-22]
stl/bezels/2bay-fan80/adapter.stl
147.7 x 85.2 x 70.0
