abarriuso/bay2rack/stl/bezels/3bay-buttons-fan80/adapter.stl

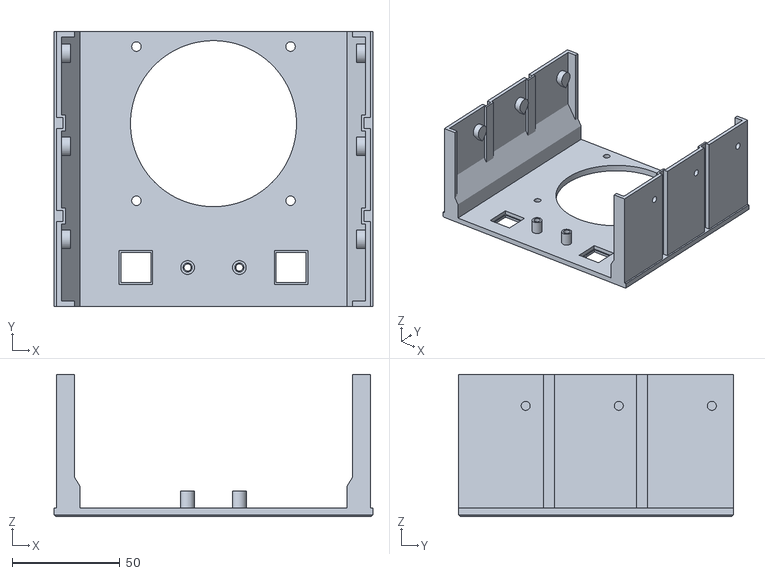
[picture p48: CAD file, 2026-10-22]
stl/bezels/3bay-buttons-fan80/adapter.stl
148.0 x 127.5 x 66.0
