abarriuso/bay2rack/stl/bezels/3bay-fan120/adapter.stl

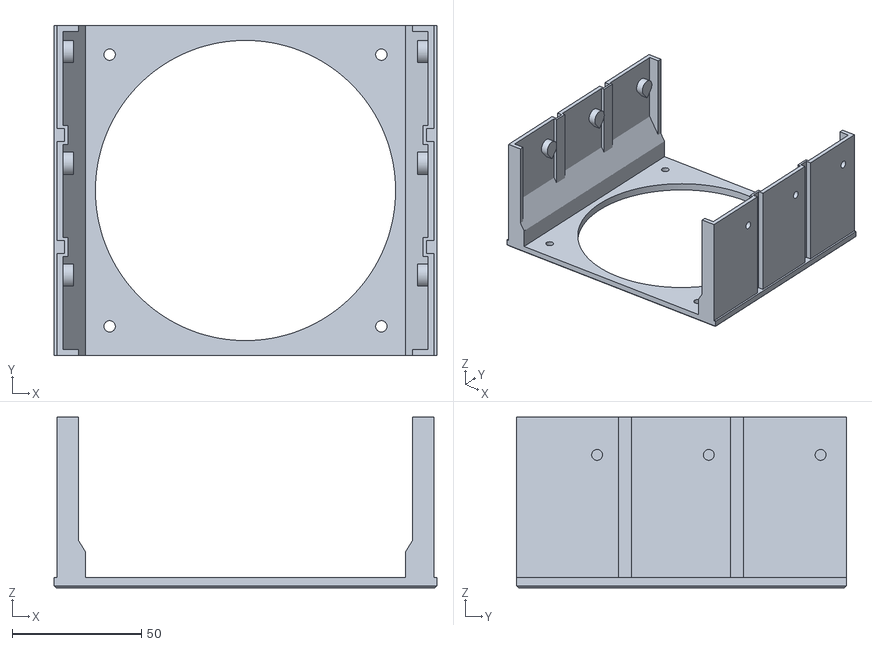
[picture p49: CAD file, 2026-11-11]
stl/bezels/3bay-fan120/adapter.stl
148.0 x 127.5 x 66.0
