abarriuso/bay2rack/stl/covers/keystone-blank.stl

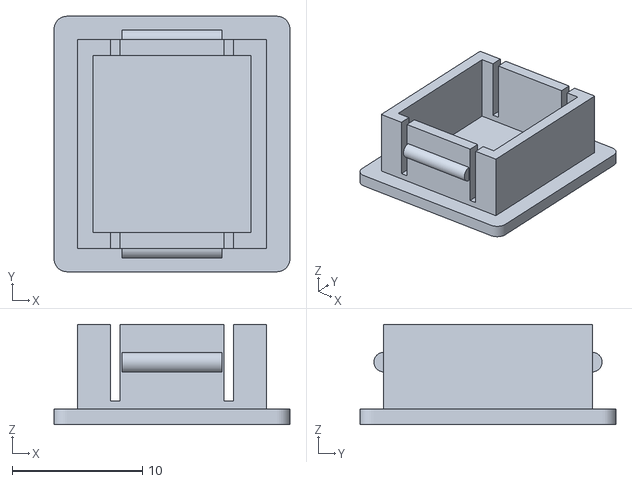
[picture p50: CAD file, 2026-10-13]
stl/covers/keystone-blank.stl
18.1 x 19.6 x 7.70
