abarriuso/bay2rack/stl/modules/fan80.stl

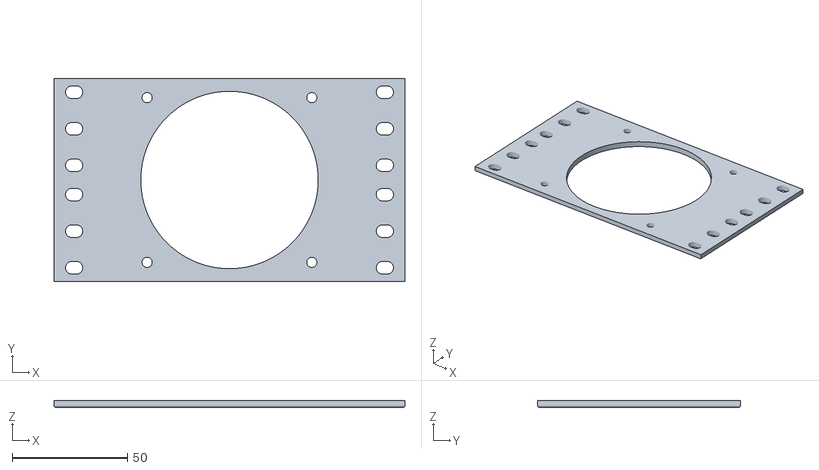
[picture p51: CAD file, 2026-11-11]
stl/modules/fan80.stl
152.4 x 88.1 x 3.00
