abarriuso/bay2rack/stl/panels/1U-vent.stl

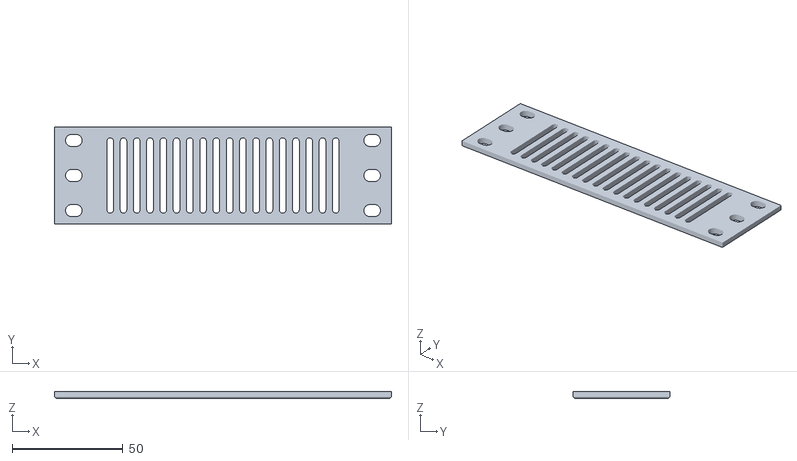
[picture p52: CAD file, 2026-10-22]
stl/panels/1U-vent.stl
152.4 x 43.7 x 3.00
