abarriuso/bay2rack/stl/plate-flush/1bay-0U/adapter.stl

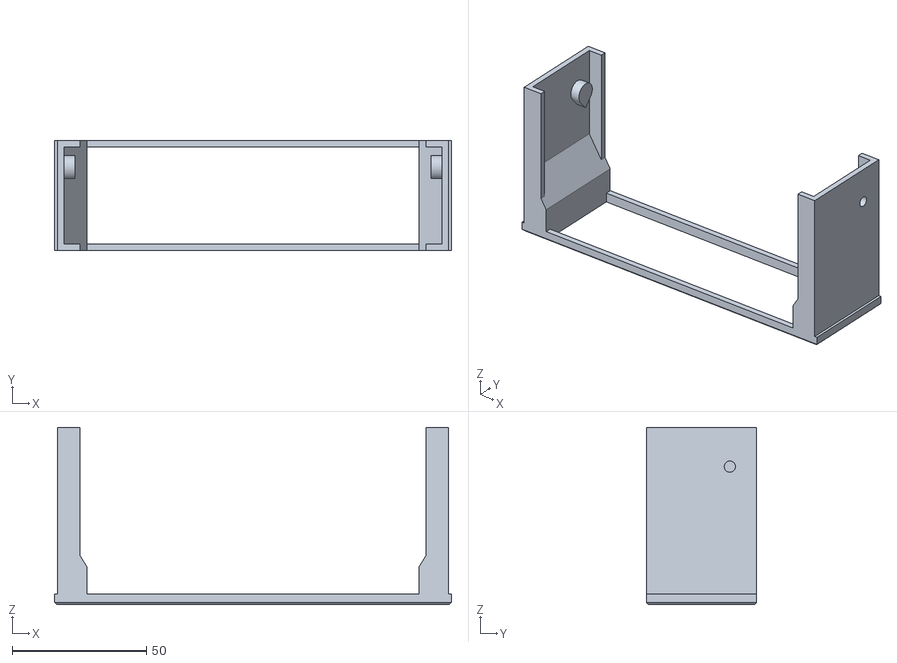
[picture p53: CAD file, 2026-10-22]
stl/plate-flush/1bay-0U/adapter.stl
148.0 x 41.1 x 66.0
