abarriuso/bay2rack/stl/plate-flush/2bay-1U/filler-blank.stl

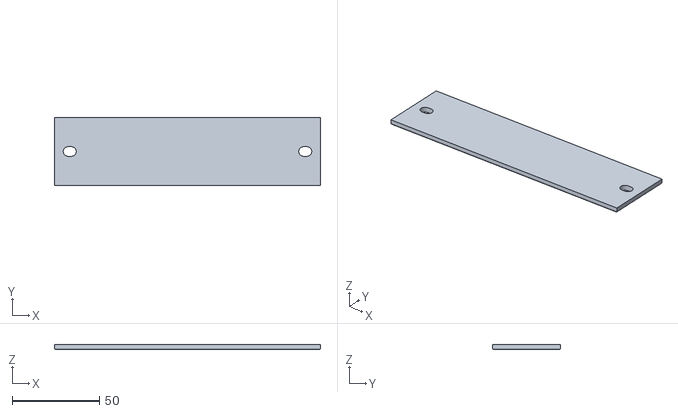
[picture p54: CAD file, 2026-10-22]
stl/plate-flush/2bay-1U/filler-blank.stl
152.4 x 39.1 x 3.00
