abarriuso/bay2rack/stl/plate-flush/3bay-2U/adapter.stl

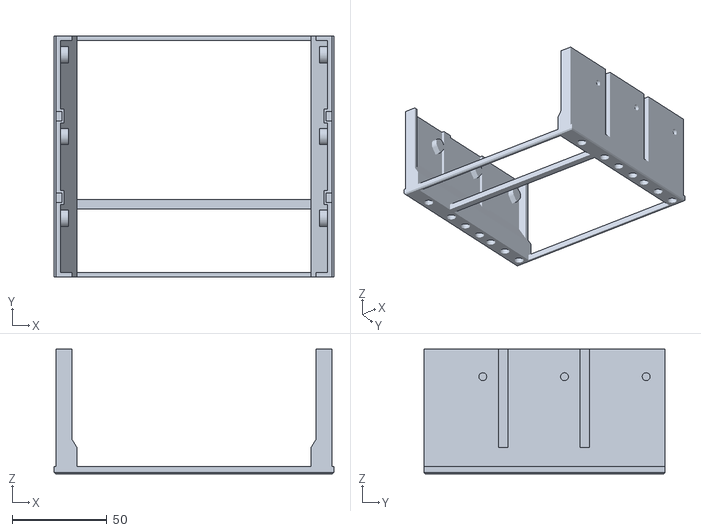
[picture p55: CAD file, 2026-10-22]
stl/plate-flush/3bay-2U/adapter.stl
148.0 x 127.5 x 66.0
