abarriuso/bay2rack/stl/plate-flush/4bay-3U/filler-vent.stl

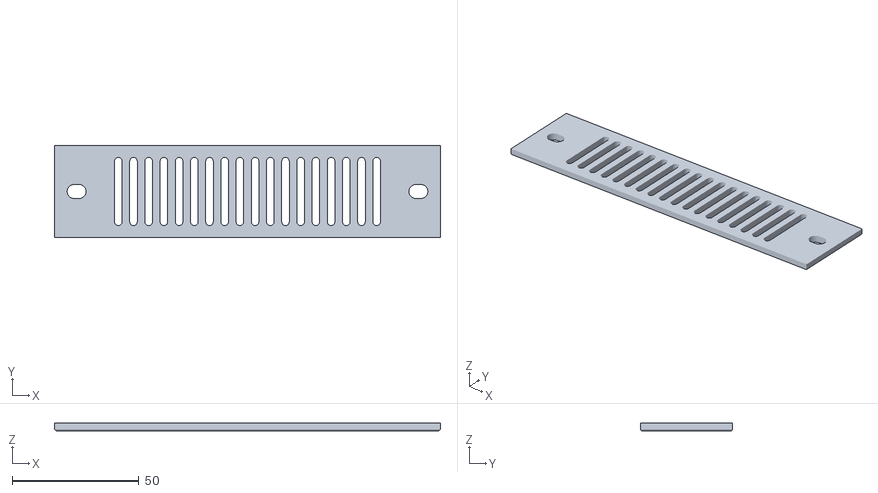
[picture p56: CAD file, 2026-10-22]
stl/plate-flush/4bay-3U/filler-vent.stl
152.4 x 36.5 x 3.00
