abarriuso/bay2rack/stl/plate-overhang/1bay-1U/adapter.stl

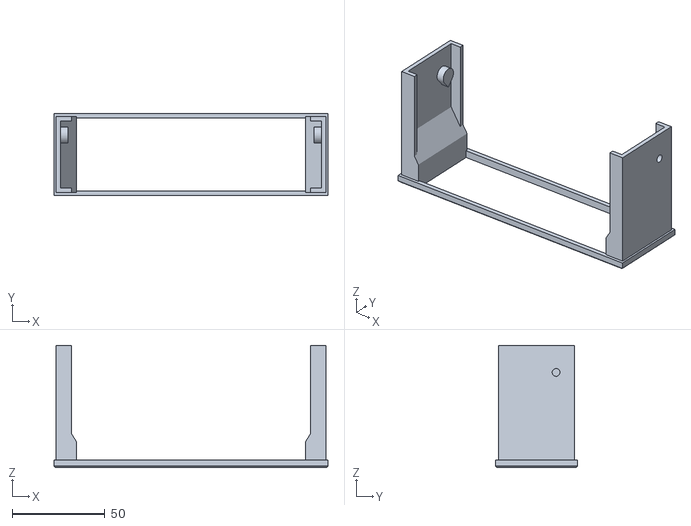
[picture p57: CAD file, 2026-10-22]
stl/plate-overhang/1bay-1U/adapter.stl
148.0 x 44.5 x 66.0
