abarriuso/bay2rack/stl/plate-overhang/2bay-2U/adapter.stl

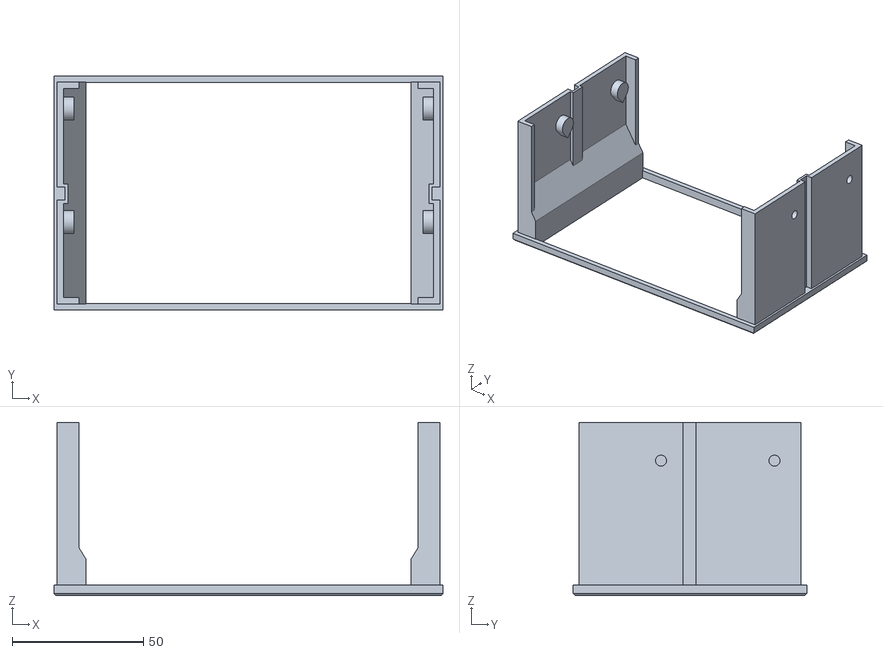
[picture p58: CAD file, 2026-10-22]
stl/plate-overhang/2bay-2U/adapter.stl
148.0 x 88.9 x 66.0
