abarriuso/bay2rack/stl/plate-overhang/3bay-3U/adapter.stl

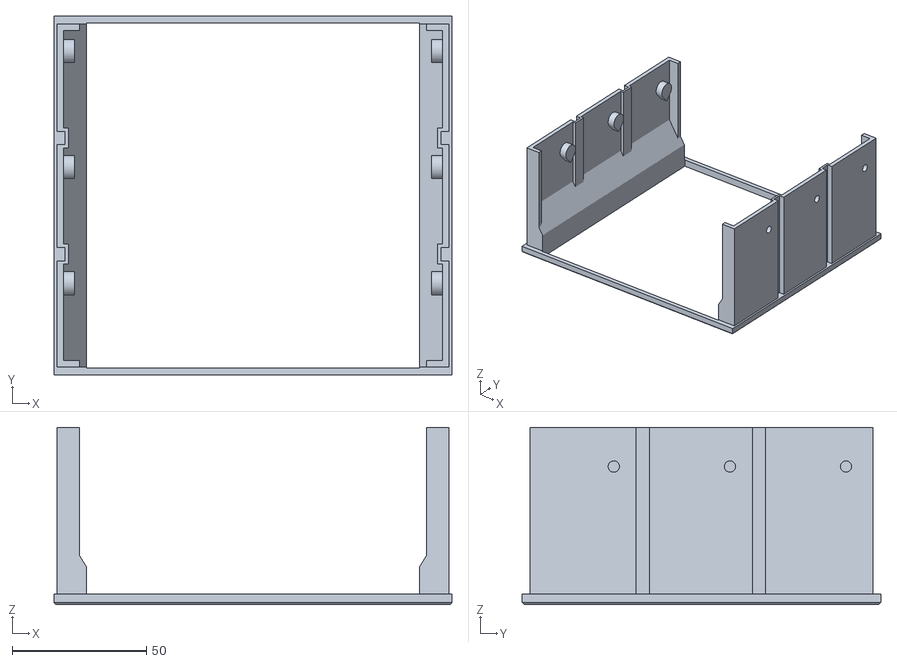
[picture p59: CAD file, 2026-10-22]
stl/plate-overhang/3bay-3U/adapter.stl
148.0 x 133.4 x 66.0
