abarriuso/bay2rack/stl/rear/pci-lan.stl

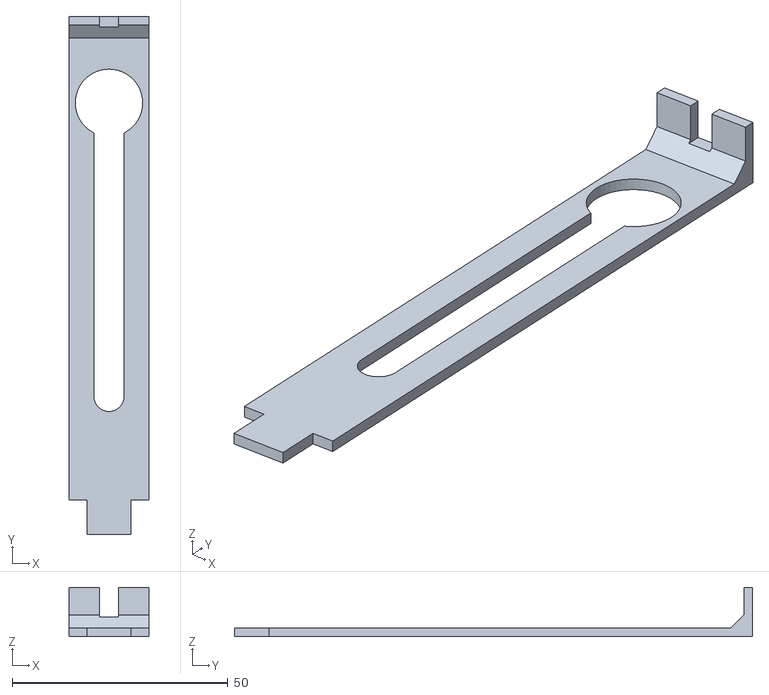
[picture p60: CAD file, 2026-10-21]
stl/rear/pci-lan.stl
18.4 x 120.0 x 11.4
