abarriuso/bay2rack/stl/tests/button-retro.stl

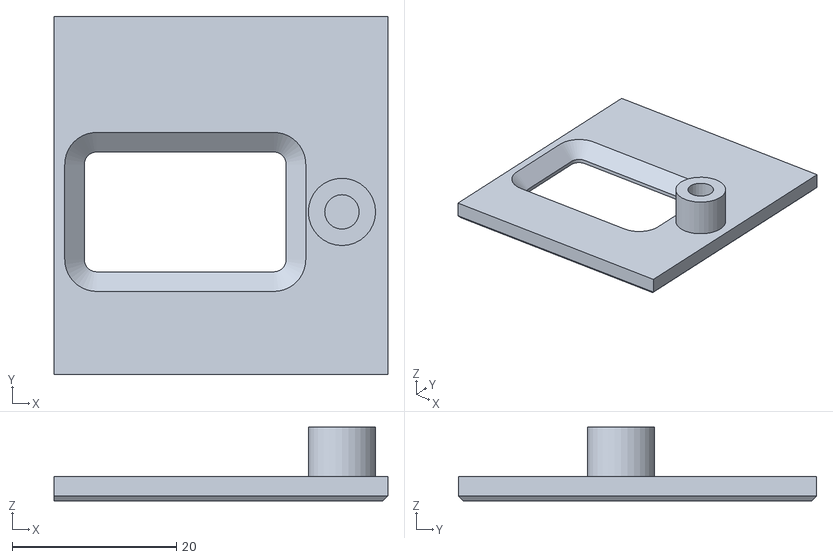
[picture p61: CAD file, 2026-10-22]
stl/tests/button-retro.stl
40.7 x 43.7 x 9.00
