abarriuso/bay2rack/stl/covers/keystone-pass.stl

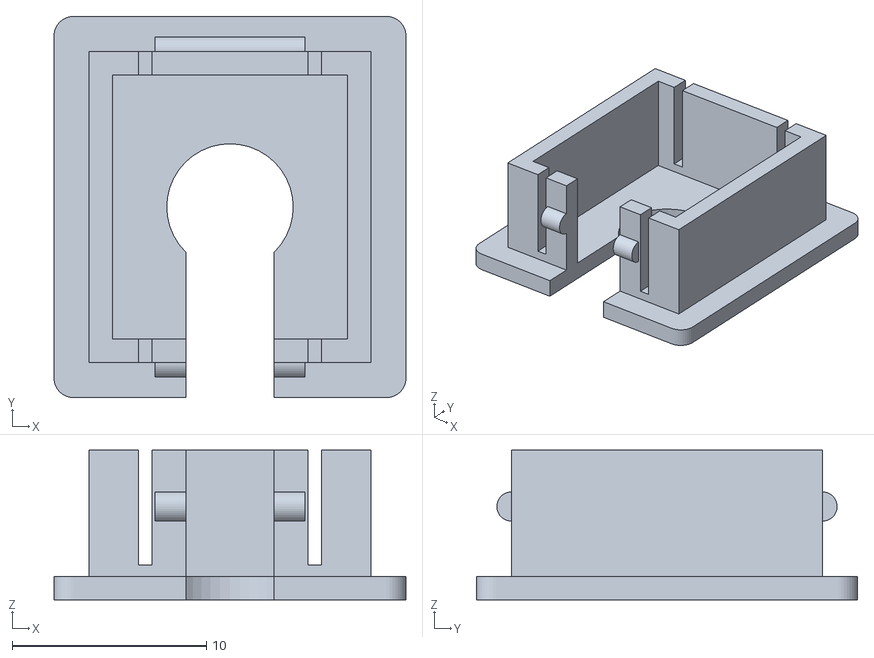
[picture p62: CAD file, 2026-10-13]
stl/covers/keystone-pass.stl
18.1 x 19.6 x 7.70
