abarriuso/bay2rack/stl/modules/fan120.stl

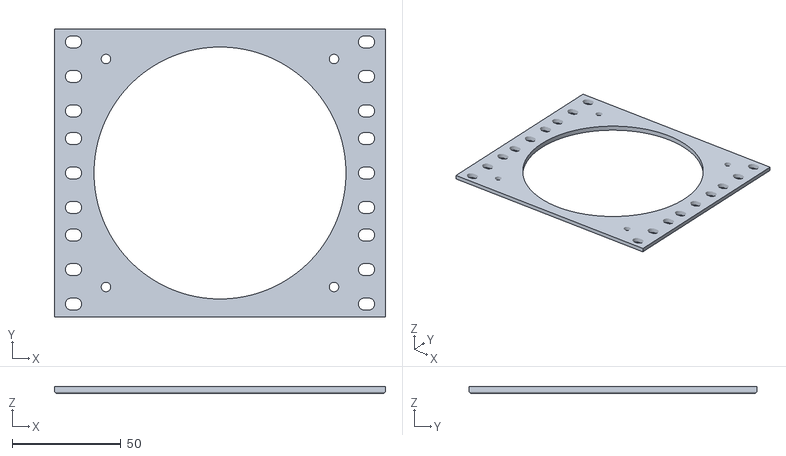
[picture p63: CAD file, 2026-11-11]
stl/modules/fan120.stl
152.4 x 132.6 x 3.00
