abarriuso/bay2rack/stl/panels/1U-patch6.stl

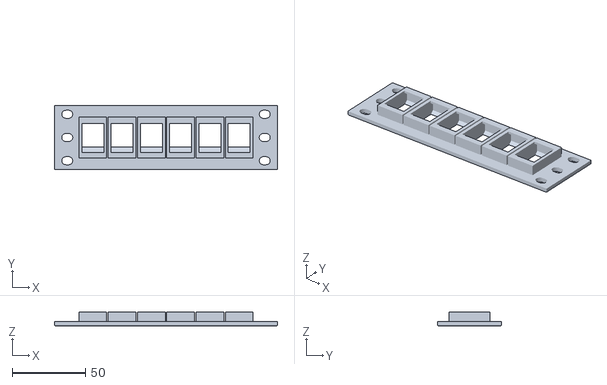
[picture p64: CAD file, 2026-10-22]
stl/panels/1U-patch6.stl
152.4 x 43.7 x 9.50
