abarriuso/bay2rack/stl/plate-flush/1bay-0U/filler-keystone6.stl

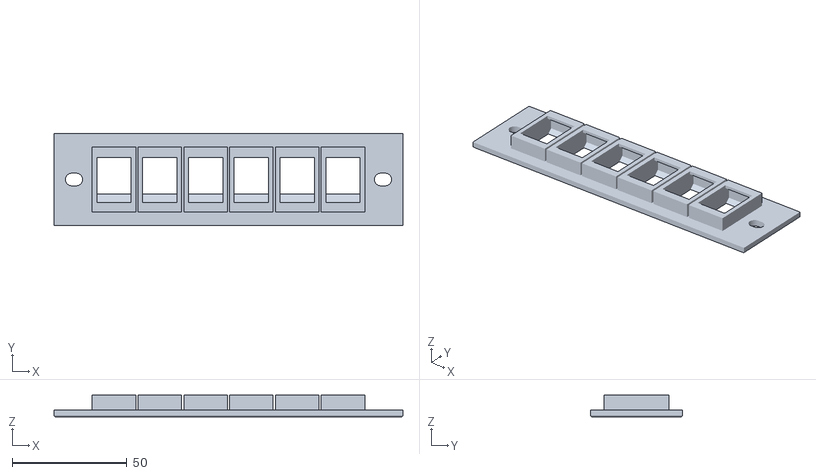
[picture p65: CAD file, 2026-10-22]
stl/plate-flush/1bay-0U/filler-keystone6.stl
152.4 x 40.3 x 9.50
