abarriuso/bay2rack/stl/plate-flush/2bay-1U/adapter.stl

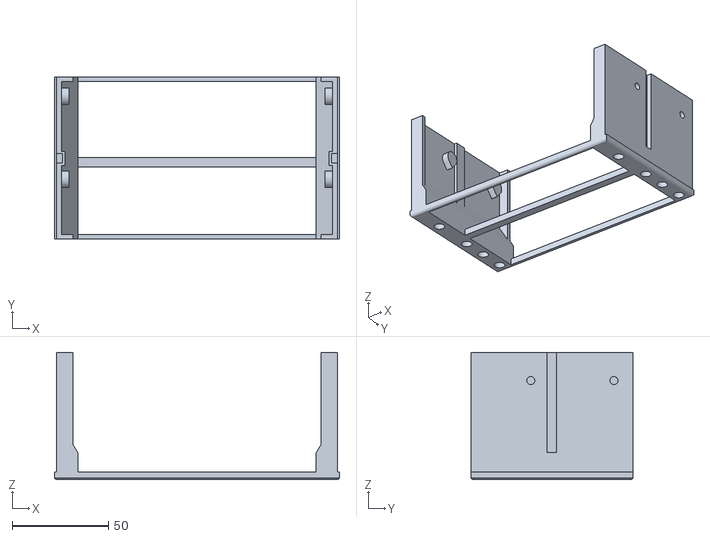
[picture p66: CAD file, 2026-10-22]
stl/plate-flush/2bay-1U/adapter.stl
148.0 x 84.3 x 66.0
