abarriuso/bay2rack/stl/plate-flush/3bay-2U/filler-keystone6.stl

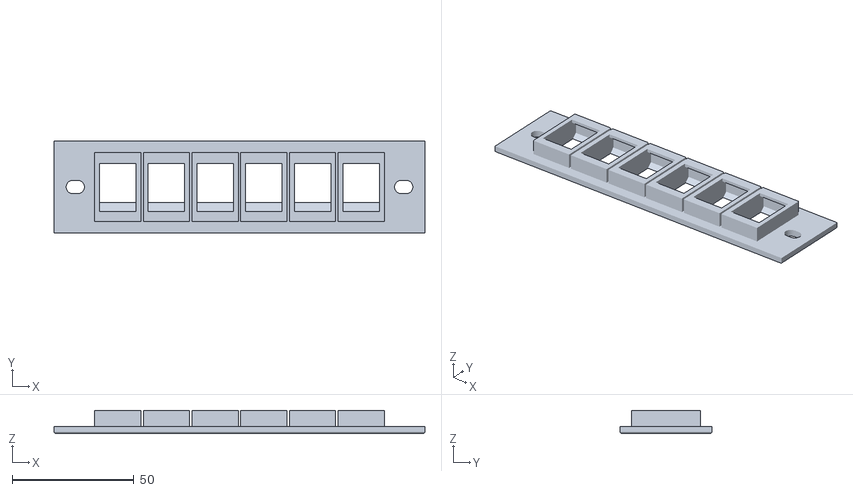
[picture p67: CAD file, 2026-10-22]
stl/plate-flush/3bay-2U/filler-keystone6.stl
152.4 x 37.8 x 9.50
