abarriuso/bay2rack/stl/plate-flush/4bay-3U/filler-keystone6.stl

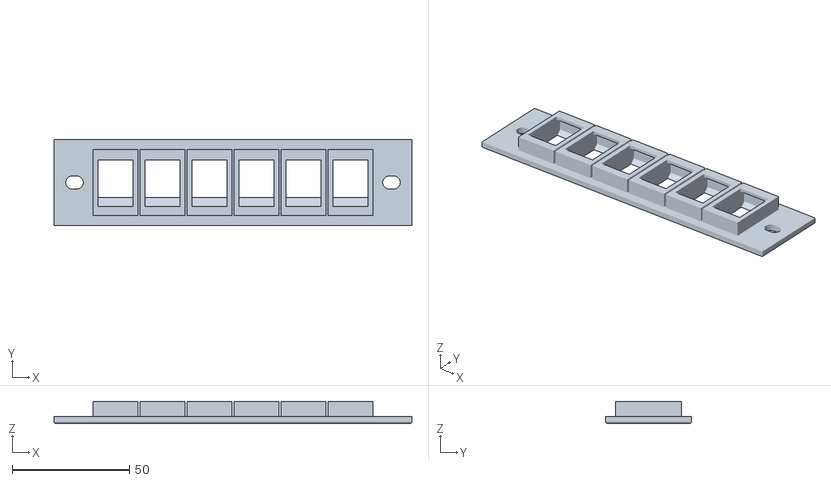
[picture p68: CAD file, 2026-10-22]
stl/plate-flush/4bay-3U/filler-keystone6.stl
152.4 x 36.5 x 9.50
