abarriuso/bay2rack/stl/rear/pci-power.stl

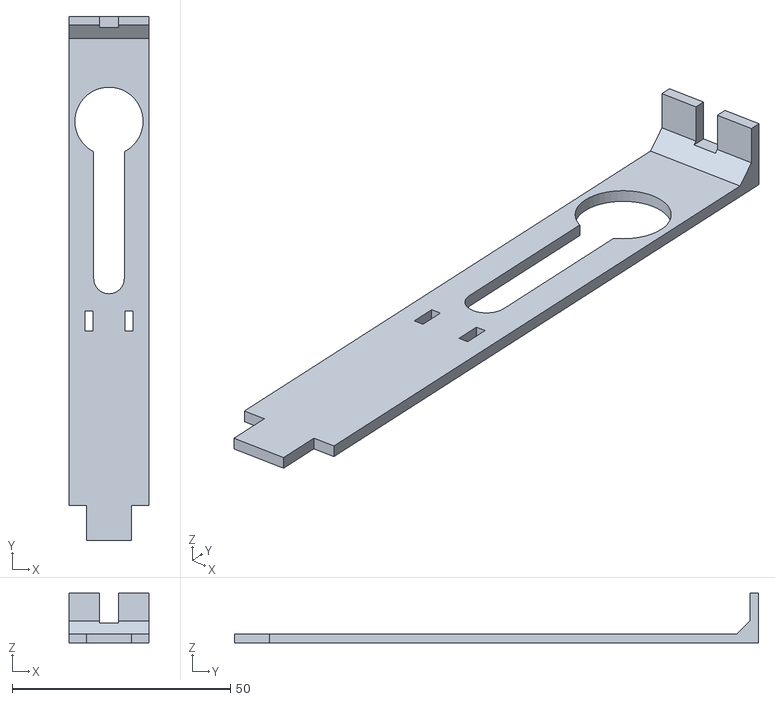
[picture p69: CAD file, 2026-10-21]
stl/rear/pci-power.stl
18.4 x 120.0 x 11.4
