abarriuso/bay2rack/stl/tests/bay-bezel.stl

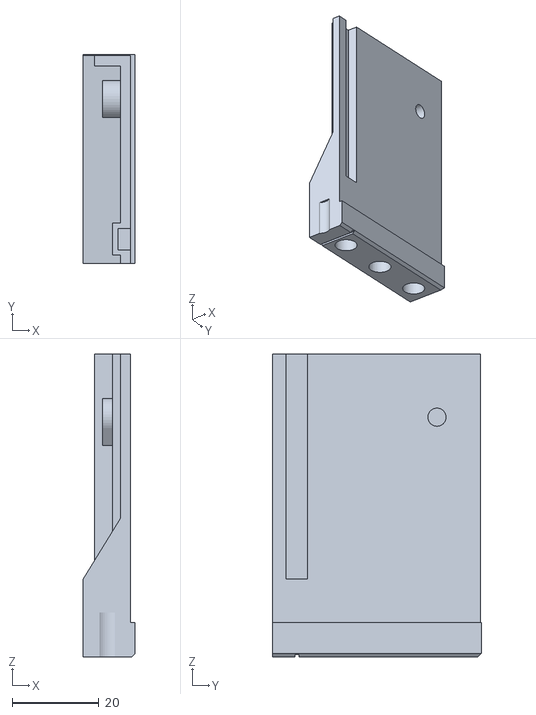
[picture p70: CAD file, 2026-10-22]
stl/tests/bay-bezel.stl
12.0 x 48.2 x 70.0
