abarriuso/bay2rack/stl/panels/1U-blank.stl

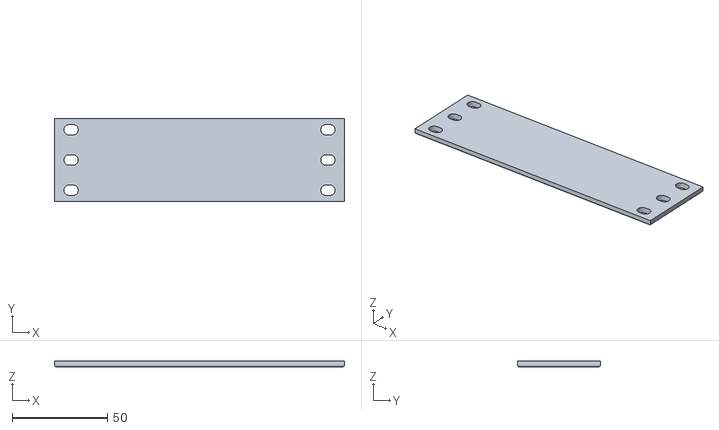
[picture p72: CAD file, 2026-10-22]
stl/panels/1U-blank.stl
152.4 x 43.7 x 3.00
