abarriuso/bay2rack/stl/plate-flush/1bay-0U/filler-blank.stl

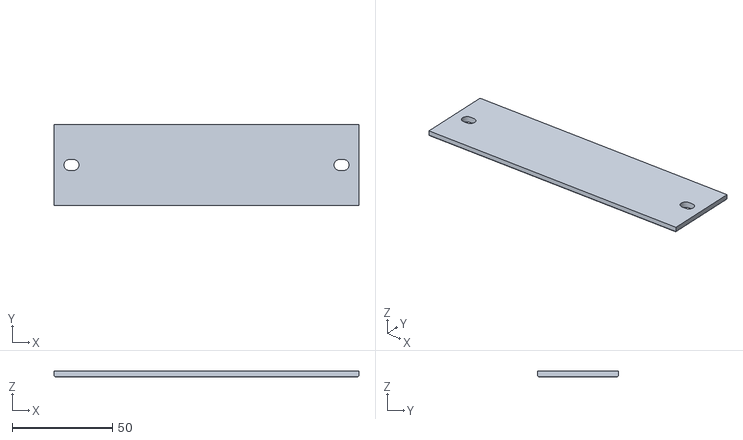
[picture p73: CAD file, 2026-10-22]
stl/plate-flush/1bay-0U/filler-blank.stl
152.4 x 40.3 x 3.00
