abarriuso/bay2rack/stl/plate-flush/3bay-2U/filler-blank.stl

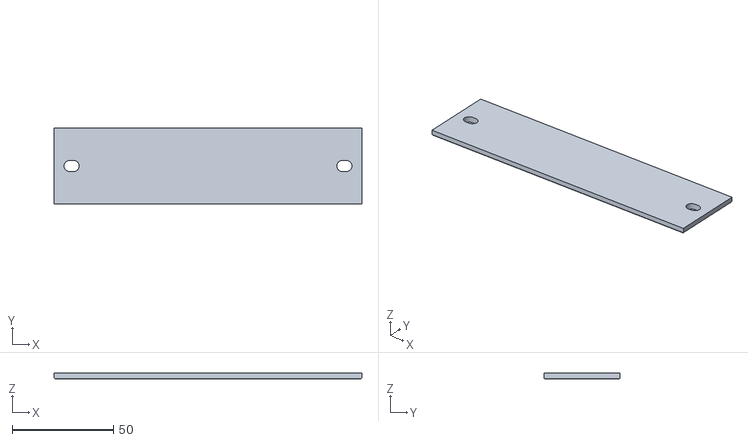
[picture p74: CAD file, 2026-10-22]
stl/plate-flush/3bay-2U/filler-blank.stl
152.4 x 37.8 x 3.00
