abarriuso/bay2rack/stl/tests/keystone-standard.stl

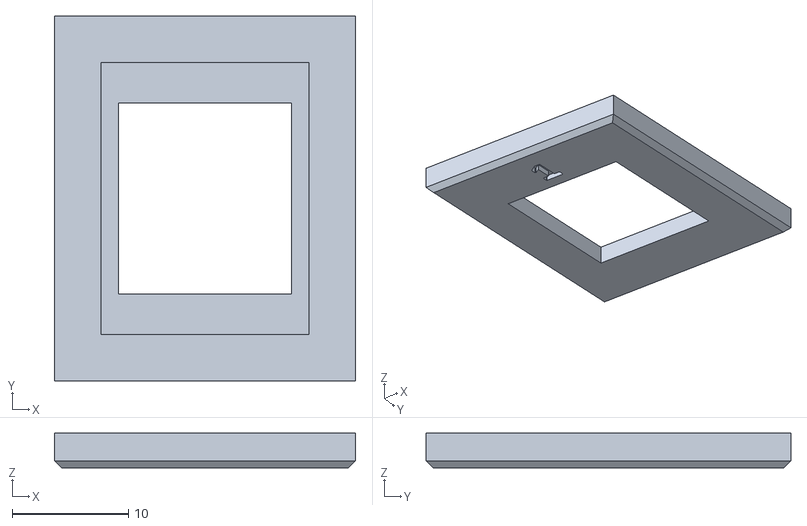
[picture p75: CAD file, 2026-10-22]
stl/tests/keystone-standard.stl
25.9 x 31.4 x 3.00
