abarriuso/bay2rack/stl/modules/fan92.stl

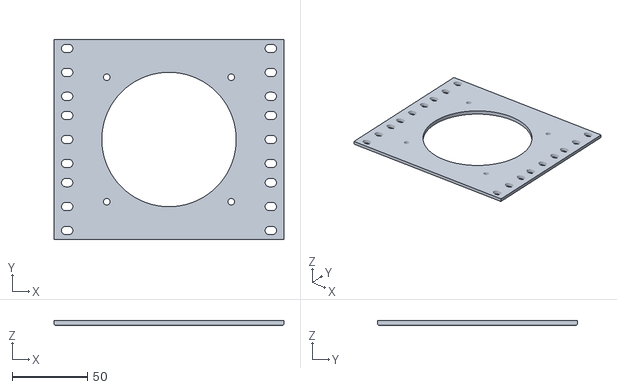
[picture p76: CAD file, 2026-11-11]
stl/modules/fan92.stl
152.4 x 132.6 x 3.00
