abarriuso/bay2rack/stl/panels/1U-fan40.stl

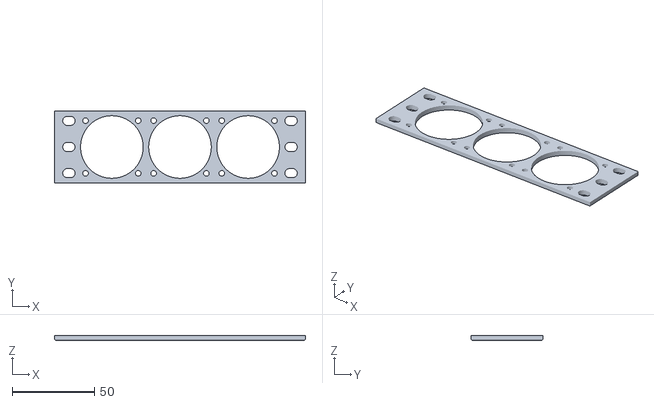
[picture p77: CAD file, 2026-10-22]
stl/panels/1U-fan40.stl
152.4 x 43.7 x 3.00
