abarriuso/bay2rack/stl/plate-flush/1bay-0U/filler-vent.stl

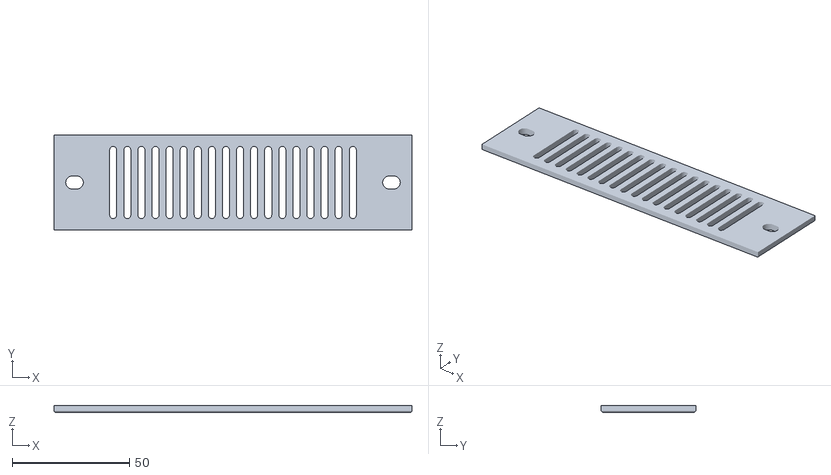
[picture p78: CAD file, 2026-10-22]
stl/plate-flush/1bay-0U/filler-vent.stl
152.4 x 40.3 x 3.00
