abarriuso/bay2rack/stl/plate-flush/2bay-1U/filler-keystone6.stl

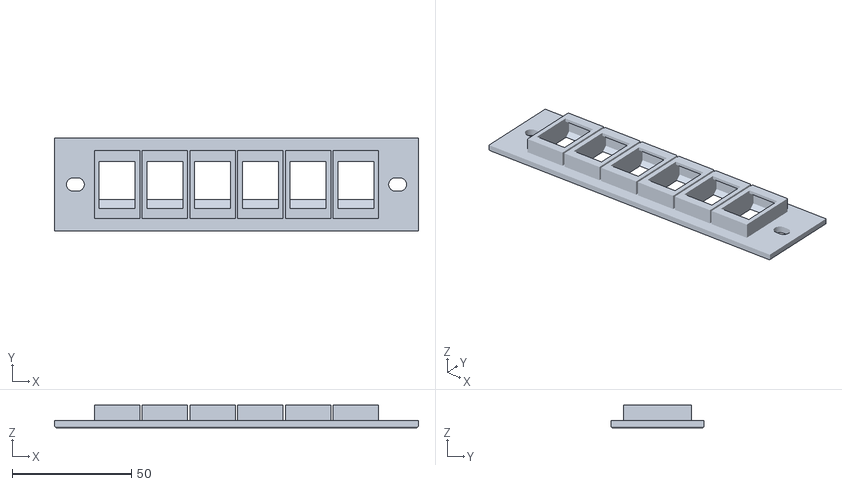
[picture p79: CAD file, 2026-10-22]
stl/plate-flush/2bay-1U/filler-keystone6.stl
152.4 x 39.1 x 9.50
