abarriuso/bay2rack/stl/plate-flush/4bay-3U/adapter.stl

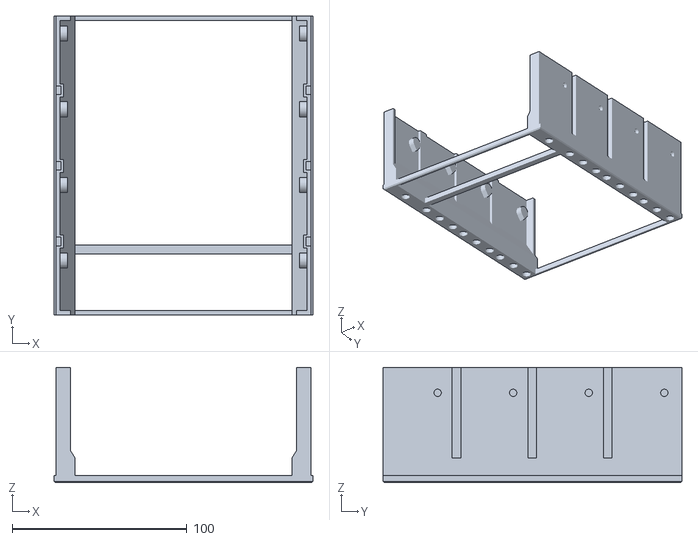
[picture p80: CAD file, 2026-10-22]
stl/plate-flush/4bay-3U/adapter.stl
148.0 x 170.7 x 66.0
