abarriuso/bay2rack/stl/tests/rack-M5-heatset.stl

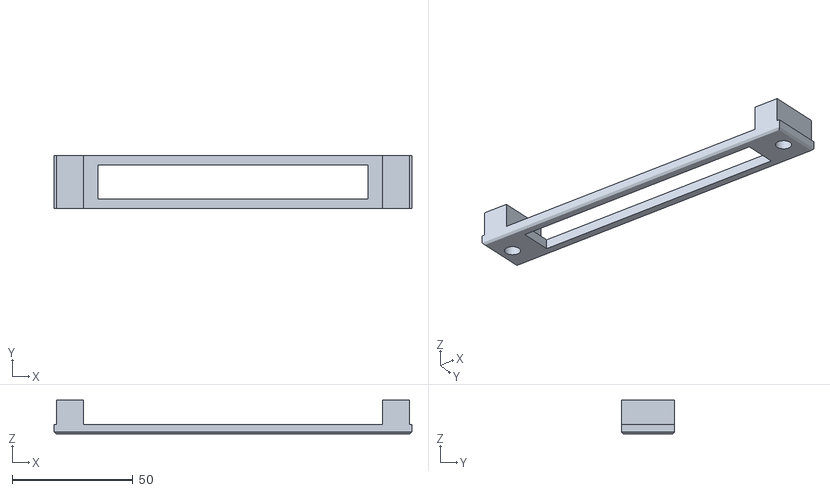
[picture p81: CAD file, 2026-10-22]
stl/tests/rack-M5-heatset.stl
148.0 x 22.0 x 14.0
