abarriuso/bay2rack/stl/modules/uswflex.stl

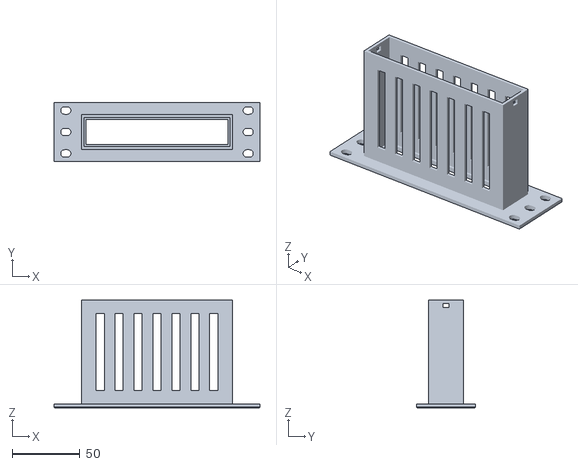
[picture p82: CAD file, 2026-10-22]
stl/modules/uswflex.stl
152.4 x 43.7 x 79.8
