abarriuso/bay2rack/stl/panels/2U-patch12.stl

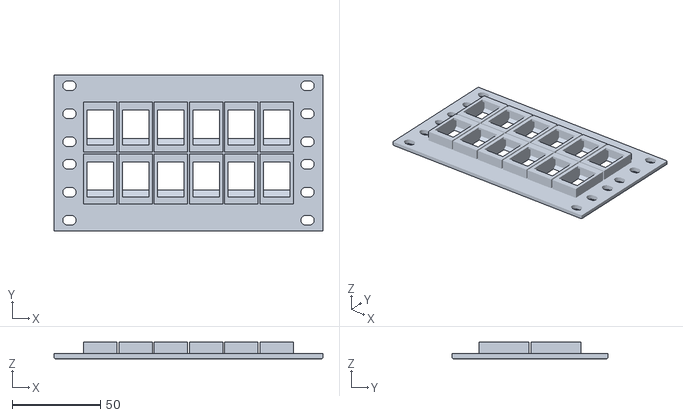
[picture p83: CAD file, 2026-10-22]
stl/panels/2U-patch12.stl
152.4 x 88.1 x 9.50
