abarriuso/bay2rack/stl/tests/bay-plate.stl

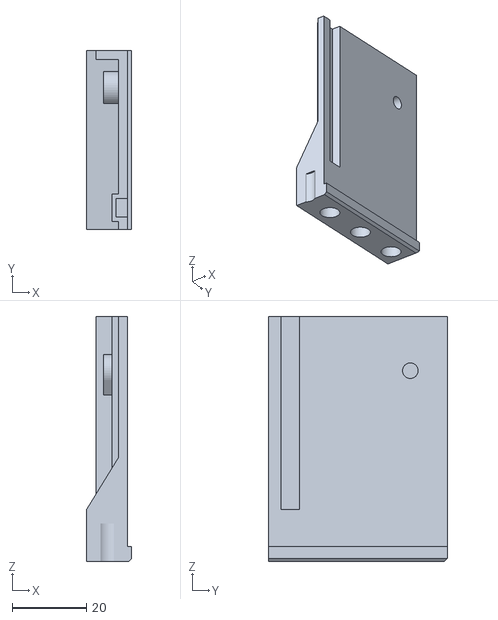
[picture p84: CAD file, 2026-10-22]
stl/tests/bay-plate.stl
12.1 x 48.2 x 66.0
