abarriuso/bay2rack/stl/modules/piblade-x4.stl

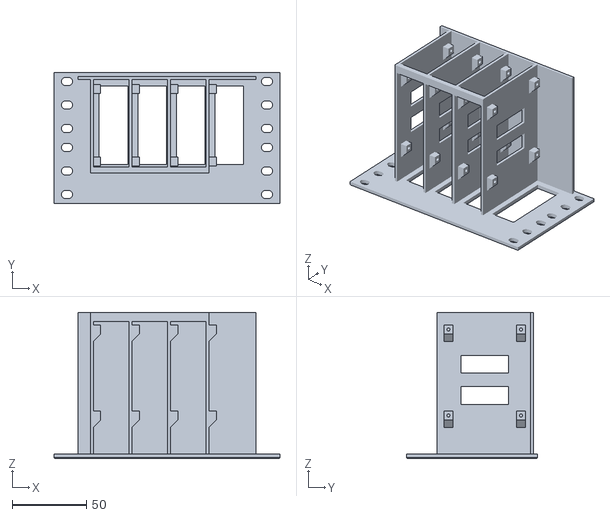
[picture p85: CAD file, 2026-10-22]
stl/modules/piblade-x4.stl
152.4 x 88.1 x 98.6
