abarriuso/bay2rack/stl/tests/button-metal-16.stl

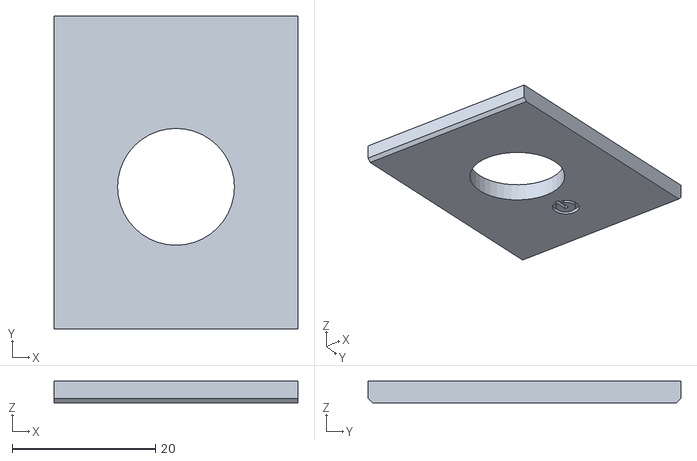
[picture p86: CAD file, 2026-10-17]
stl/tests/button-metal-16.stl
34.0 x 43.7 x 3.00
