abarriuso/bay2rack/stl/modules/kvm-jet-nano.stl

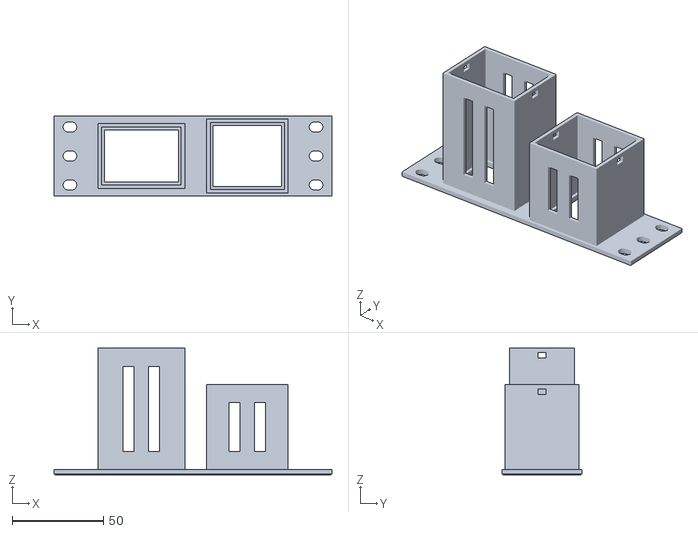
[picture p87: CAD file, 2026-10-22]
stl/modules/kvm-jet-nano.stl
152.4 x 43.7 x 69.6
