abarriuso/bay2rack/stl/modules/buttons.stl

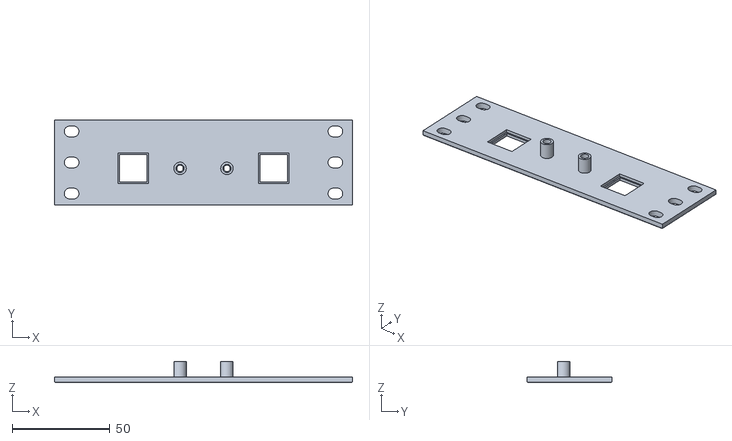
[picture p88: CAD file, 2026-10-22]
stl/modules/buttons.stl
152.4 x 43.7 x 11.0
