abarriuso/bay2rack/stl/tests/keystone-metal.stl

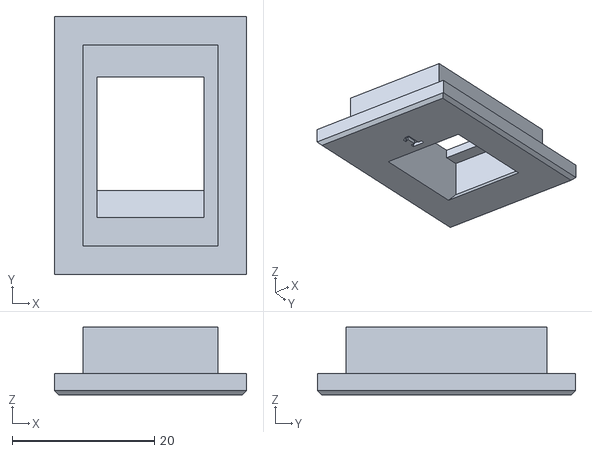
[picture p89: CAD file, 2026-10-17]
stl/tests/keystone-metal.stl
27.0 x 36.3 x 9.50
