abarriuso/bay2rack/stl/modules/pi-zero.stl

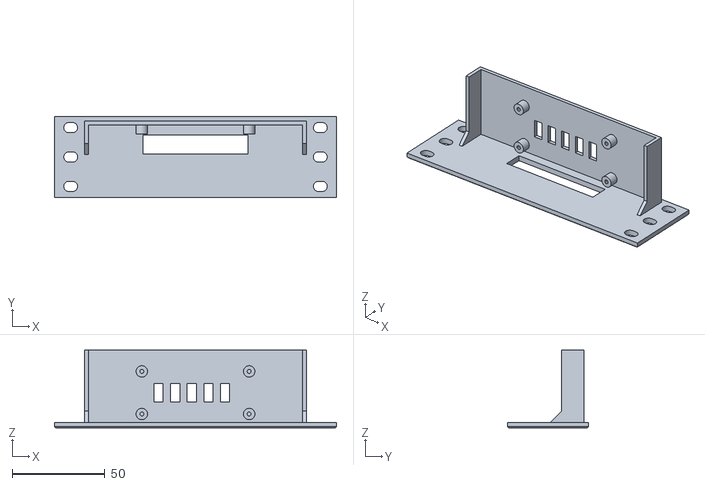
[picture p90: CAD file, 2026-10-22]
stl/modules/pi-zero.stl
152.4 x 43.7 x 42.0
