abarriuso/bay2rack/stl/modules/pi5.stl

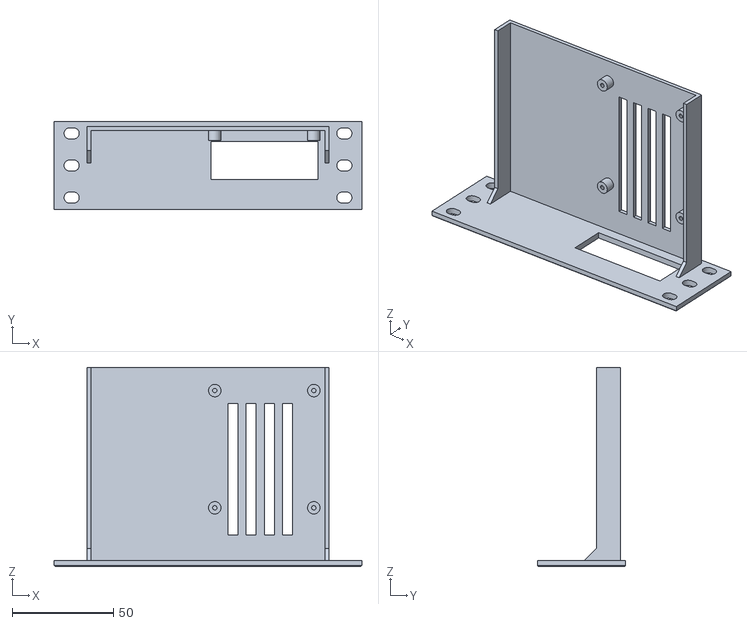
[picture p91: CAD file, 2026-10-22]
stl/modules/pi5.stl
152.4 x 43.7 x 98.6
