abarriuso/bay2rack/stl/modules/kvm-jet-jet.stl

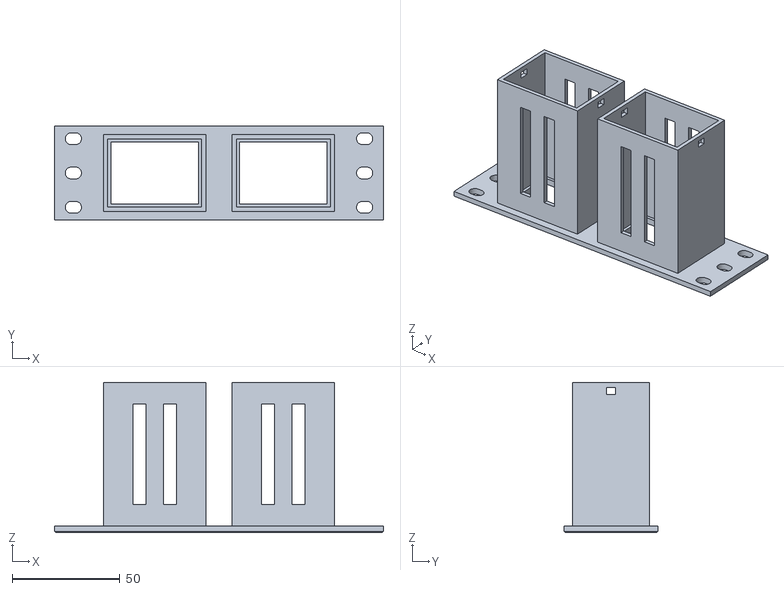
[picture p92: CAD file, 2026-10-22]
stl/modules/kvm-jet-jet.stl
152.4 x 43.7 x 69.6
