abarriuso/bay2rack/stl/modules/pi-x2.stl

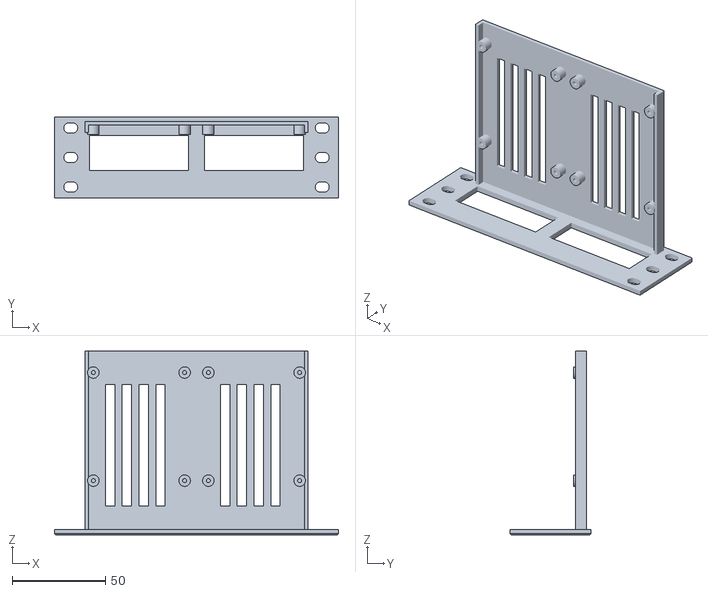
[picture p93: CAD file, 2026-10-22]
stl/modules/pi-x2.stl
152.4 x 43.7 x 98.6
