abarriuso/bay2rack/stl/modules/kvm-nano-nano.stl

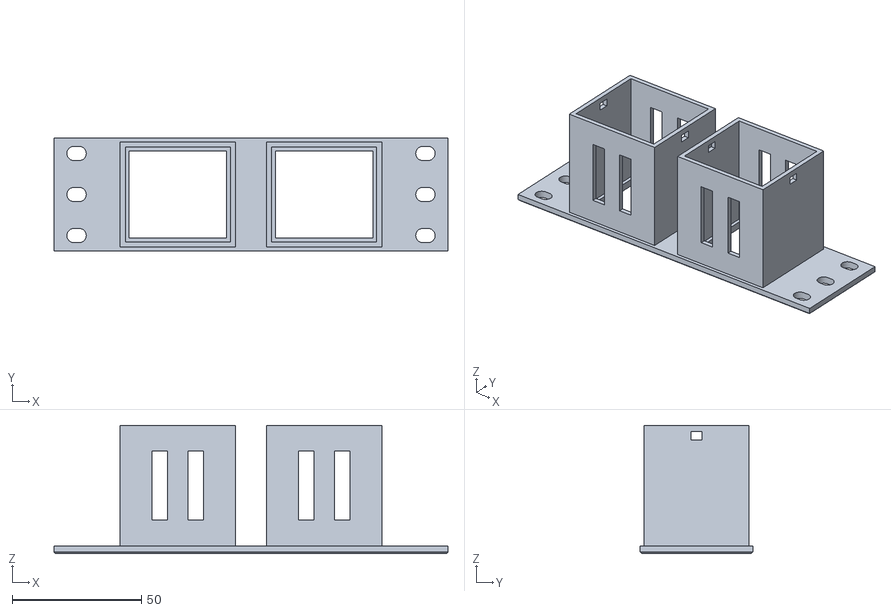
[picture p94: CAD file, 2026-10-22]
stl/modules/kvm-nano-nano.stl
152.4 x 43.7 x 49.6
