abarriuso/bay2rack/stl/modules/ms105g.stl

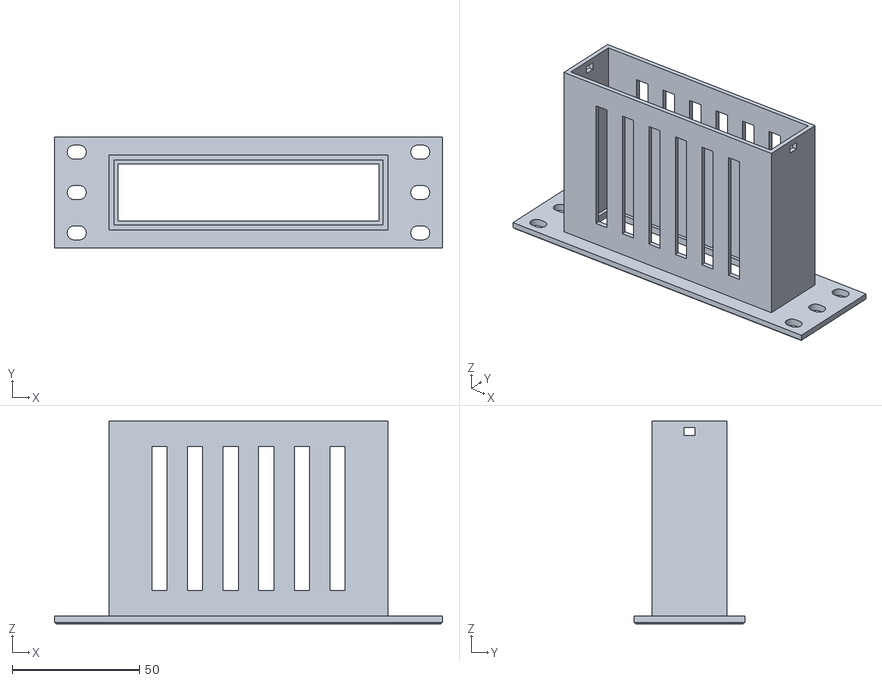
[picture p95: CAD file, 2026-10-22]
stl/modules/ms105g.stl
152.4 x 43.7 x 79.6
