abarriuso/bay2rack/stl/modules/ux.stl

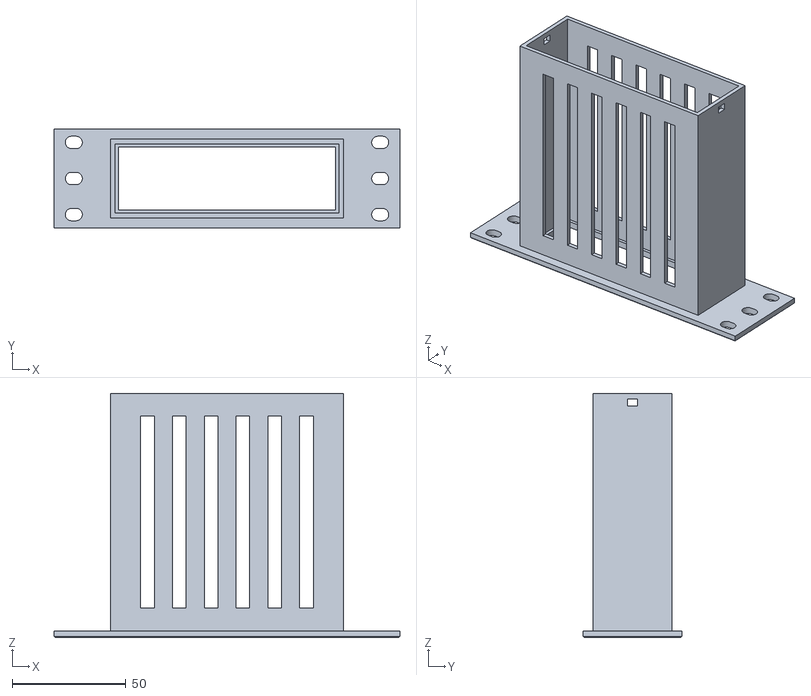
[picture p96: CAD file, 2026-10-22]
stl/modules/ux.stl
152.4 x 43.7 x 107.6
