abarriuso/bay2rack/(list of files, cad)

Other CAD files:
stl/plate-flush/2bay-1U/filler-vent.stl
stl/plate-flush/4bay-3U/filler-blank.stl
stl/plate-flush/3bay-2U/filler-vent.stl
stl/tests/button-mx.stl
