abarriuso/bay2rack/scripts/makerworld/description-es.md

# bay2rack: convierte las bahías de 5,25" de una caja de PC antigua en un mini rack de 6"

Las torres antiguas traían bahías de 5,25" para los lectores de CD. El ATX no ha cambiado, así que esa caja sigue
admitiendo una placa moderna, y con este adaptador sus bahías se convierten en un **mini rack de 6"**: un router con
VLANs, switches, KVM por IP, blades de Raspberry Pi y un patch panel, en el frontal de la caja.

Se atornilla a las bahías como una unidad. Los accesorios de rack se atornillan al adaptador.

**Sobre las fotos:** las fotos reales son de la primera versión del adaptador, de 2 bahías: 1U para el switch más el patch panel como panel aparte. Los archivos son la versión actual, que añade ranuras para las pestañas metálicas entre bahías y paredes laterales más rígidas (mira los renders).

**Trabajo en proceso, se agradece la ayuda.** Es un proyecto en marcha. Si algo no encaja en tu caja, una pieza sale mal o encuentras un defecto, cuéntamelo en los comentarios o abre un issue en GitHub (https://github.com/abarriuso/bay2rack/issues), con fotos y el modelo de tu caja si puedes. Se agradecen pull requests con medidas de otras cajas y accesorios de rack, módulos nuevos y correcciones.

**Configúralo en el navegador, con vista 3D de la caja:** https://bay2rack.pages.dev/
(copia: https://abarriuso.github.io/bay2rack/). Elige las bahías, qué va en cada U del rack y cada puerto de cada patch
panel, y descarga un kit con todos los STL, la lista de materiales y los ajustes de impresión.
Código y documentación: https://github.com/abarriuso/bay2rack

## Qué incluye

- **Adaptadores**: 2, 3 y 4 bahías (1U, 2U y 3U dentro de las bahías más una franja para un relleno), y una versión
  de 3 bahías con bisel de 5,25" exacto y patch panel de 6 puertos.
- **Rellenos** para la franja: 6 keystones, rejilla, ciego.
- **Módulos de rack** (1U): switch Mercusys MS105G, UniFi Flex Mini, UniFi Express, JetKVM + NanoKVM, Raspberry Pi 5,
  tres ventiladores de 40 mm, patch panel de 6 puertos, botonera de encendido / reset con interruptores MX.
  **2U**: cuatro Raspberry Pi de canto, dos ventiladores de 60 mm, uno de 80 mm. **3U**: un ventilador de 92 o de
  120 mm. En el configurador web también: una **bahía para NanoKVM Lite** (de pie fuera de la caja, o dentro de
  ella detrás de un keystone), etiquetas y bandejas para tus aparatos.
- **Biseles sin rack**: ventilador de 80 o de 120 mm, botonera, rejilla, para los demás PCs del homelab.
- **Tapas de keystone** (lisa y pasacables) y **soportes para ranuras PCI** para meter los cables por detrás.
- **Piezas de prueba**: imprímelas primero y compruébalas con tu caja. Si el keystone, la funda o un inserto quedan justos u holgados, cámbialo en el paso «Ajustar tras imprimir las pruebas» del configurador web antes de imprimir el resto.

Todo lo demás (otro número de bahías, otros switches, las medidas de tus dispositivos, tornillos M3/M4/M6/10-32/12-24,
tuercas en vez de insertos...) está en el modelo paramétrico: usa el configurador web, o abre el archivo .scad en OpenSCAD.

## Impresión

- Ya vienen orientadas con la cara frontal sobre la cama: **sin soportes**.
- PETG o ASA dentro de una caja caliente; PLA si la caja está fresca. 3-4 perímetros, 20-30 % de relleno, capas de 0,2 mm.
- 3 bahías: 148 x 128 mm en la cama, unos 70 mm de alto.

## Tornillería (adaptador de 3 bahías, valores por defecto)

- Rack: tornillos M5 x 10 de cabeza de botón + insertos térmicos M5 (agujero de 6,4 mm) en el adaptador; los módulos
  se atornillan a esos insertos, no necesitan los suyos. ¿Sin soldador? Activa «No tengo soldador» en el configurador
  (tuercas cuadradas). M6, 10-32 o 12-24 si lo prefieres.
- Bahía: 6 tornillos M3 x 5 + insertos térmicos M3.
- Keystones: estándar de 14,9 x 16,4 mm o RJ45 metálicos / apantallados (la celda los sujeta por detrás).

## Comprueba antes tu caja

Cada caja es distinta. Los agujeros de las bahías siguen SFF-8551 (a 10 mm de altura y 47,4 mm del frente). Imprime
la **pieza de prueba de bahía** antes que el adaptador. Unas ranuras a lo largo de la guía dejan sitio a las pestañas
metálicas entre bahías, así que no hace falta doblarlas.

El rack de 6" no tiene estándar oficial: los agujeros están a 134,925 mm, con las mismas reglas que los mini racks de
10" (patrón vertical EIA-310). Imprime la **pieza de prueba de rack** para comprobar tus accesorios.

Guía de montaje (qué comprar, insertos, montaje, cables y alimentación): https://github.com/abarriuso/bay2rack/blob/main/docs/BUILD.es.md

Licencia: CC BY-NC-SA 4.0, no para uso comercial sin permiso.
