abarriuso/bay2rack/CHANGELOG.md

# Changelog

Versions follow `MAJOR.MINOR.PATCH`. The adapter itself has its own generation number (adapter v1, v2), the one
on the photos and in the MakerWorld notes.

## Unreleased

- Simpler module list:
  - Removed the 1U shelf (`shelf`): the device trays (`dev1`, `dev2`, `kvm`, `pi`) cover what it held.
  - The NanoKVM Lite bay keeps two versions: `nkvm:side`, standing outside the case in its little mountain, and
    `nkvm:ks`, inside the case with its network port at a keystone (1 or 2). The drawer (`nkvm:front`) and the
    pocket in the plate (`nkvm_raised = false`) are gone, with `nkvm_raised`, `nkvm_cover` and `nkvm_vents`.
- Fans of every common size: 40 mm (up to three in 1U), 60 mm (two in 2U), 80 mm (2U), 92 mm and 120 mm (3U), as
  rack modules (`fan60` ... `fan120`, they take the units they need) and as fills of the spare strip or of a bezel
  (a 120 mm bezel needs three bays). `fan40_count` becomes `fan_count`: each place takes as many fans as fit, up
  to it. Round openings or a hex grille (`fan_guard`) for every size; the bill of materials lists the fan screws.
  New STLs: `stl/modules/fan60` ... `fan120`, `stl/bezels/3bay-fan120`.
- Web, motion in the configurator (only transform and opacity, nothing running while idle, off with "reduce
  motion"): the camera glides to a view instead of jumping and comes in turning the first time, a new result
  settles into place, the steps glide to their new places and come in one after another, pressed controls give,
  a folded step unfolds, a line runs along the 3D view while it works, the kit button nudges when its count changes.
- Web, wording: "front bays" instead of 5.25" bays (the measure stays in the glossary and in what search engines read).
- A simpler page with the colours of its film: the cream plastic of a 90s tower (light theme) and the black of its
  inside (dark theme), flat, with the red of its display as the only accent (links, focus, the numbers of the
  steps); what is on or pressed is the dark key, not a colour. Four blocks: film, builds, configurator, foot.
  Gone: the "Why" section and its table of bays (the film says it), the tags over the titles, the three
  how-it-works steps (one line now) and half of the footer; the glossary sits under the configurator.
- The page opens with a film you play with the scroll (it replaces the hero video): a retro homelab, the rack in
  close-up, its screws and cables coming off, the modules shooting out and hanging in the air while the camera
  goes round them, the side of the tower opening for the bay screws, the adapter, the kit on the table. Each
  stretch has its text, on the side the shot leaves free; a dark and a light version follow the theme; phones get
  every second frame at 960 px with the subject kept in the middle; with "reduce motion" or data saving it is a
  still and the texts. `scripts/blender/scroll.py` renders it, `scroll_encode.py` makes the frames (`docs/scroll/`).
- 3D view: the NanoKVM bay shows its own screws (four through the lid, four from the back of the plate into the
  mountain); the retro tower has its lock, lights, display and keys in a row under the bays, where the towers of
  the 90s had them (they sat beside the bays, where a real case has no room).
- MakerWorld print profiles: `scripts/bambu_profiles.py` builds Bambu Studio projects (A1 mini bed, 0.20 mm, PETG)
  with the pieces on named plates - the 3-bay kit (tests first, adapter, patch panel, fillers, PCI brackets) and
  every rack module on its own plate - and slices every plate with Bambu Studio itself, the test MakerWorld runs.
  The MakerWorld package lists the new fan modules and the 120 mm bezel; its script finds OpenSCAD like the others.
- Web: "How it works" in the menu goes to the three steps and "Configure" straight to the configurator (both went
  to the same place); jumping to the configurator no longer leaves it cut at the bottom (the header was counted
  twice). On phones the choice cards of the steps are rows (picture, name, its line) instead of three narrow columns.
- CI: the model tests run when the ready-made builds change (the workflow watched `main.js`, they live in
  `examples.js`).
- Web: the footer no longer leaves an empty band under it (the hidden texts of the steps reached past it), and its
  credits say which licence is whose (OpenSCAD GPL-3.0; model, STLs and site CC BY-NC-SA 4.0) with a link to the
  source. The module picker says how many free units a 2U / 3U module needs.

- Consistency pass:
  - Each ready-made build names the case of its gallery picture, so loading it shows the same PC (the configurator
    used to pick the smallest case that fits: 5 of 8 showed another one). The router and homelab builds show their
    homelab scene, as their texts say; the router picture now has the PCs next to it, the audio one the black case
    it loads.
  - One name per build everywhere (gallery card, share page, load button, README): Router with VLANs, KVM over IP,
    Proxmox / TrueNAS box, CD-drive front.
  - The name is written Bay2Rack in every text (title, logo, link previews, README); bay2rack stays in file names
    and addresses.
  - Finger-sized "Load" buttons and glossary link on phones (44 px); the configurator's panel title no longer
    repeats the section title ("Step by step").
- Homelab scene: the network, uplink and power cables inside the case run like tidy cable management: straight
  back out of the keystones, behind the drive cage, a flat ribbon along the roof on the window side and down the
  back wall to the rear slot, held by velcro ties on adhesive mounts (under a roof fan it runs below the fan).
  They used to cut across the case and through the CPU cooler and the board.
- 3D view, inside the case like a modern build: a black motherboard with real-looking traces and silkscreen
  (the green Pi and card boards too), DIMMs with heat spreaders, slots and latches, PCIe x16 / x4 / x1 slots
  (armoured x16), M.2 heatsinks, a PSU shroud, sleeved 24-pin and EPS cables through rubber grommets next to
  their sockets, SATA cables over the shroud, black drive cage walls with vent and screw holes.
- 3D view, the back wall cut like the real sheet: openings for the I/O shield and the PSU (both now flush), one
  per expansion slot behind its cover, and a honeycomb vent field beside the slots. The cooler's backplate and its
  screws show through the tray's cut-out. The cable ribbon keeps 15 mm off the back wall, with extra points at
  the bends so the smooth curve never pokes through it.
- 3D view, the PC cases in detail and consistent with bay2rack.scad:
  - Back: the exhaust fan is a real fan (frame, bore, curved blades) behind a wire guard in a round cut-out,
    the I/O shield has its ports (USB, LAN with LEDs, video, audio jacks), the slot covers have vent slots and a
    thumbscrew bar, the PSU shows its face (honeycomb, IEC inlet, switch, screws), thumbscrews on the side panels.
    The fan guards no longer have spokes past their ring (they were a flat texture).
  - Inside: the PSU reaches the back wall, the drives sit in a cage, the SATA cables end on ports of the board,
    the motherboard tray is drawn. The board is always on the +X side, like the I/O and the slots (a window on
    the right showed the board on the wrong side).
  - Roof fans (Antec Three Hundred, HAF 932) hang under the roof; perforated meshes have holes at their real
    pitch. The old client PC has a full back (I/O shield with the LAN port where the cable ends, 92 mm fan,
    slot covers, PSU) and ends where bay2rack.scad ends it; the NAS has fans behind guards.
- Gallery pictures rendered in Blender (Cycles), each build in its own case and setting: a Define XL R2 on a desk
  at night, a HAF 932 in a blue homelab, a silver Stacker 830 on a workbench, an Enthoo Pro close up, a beige
  sleeper in a living room, an Antec Three Hundred backlit, an Obsidian 750D as a white product shot and late sun
  on a green bezel build. `scripts/blender/gallery.py` renders them from GLBs exported by the web viewer,
  `gallery_encode.py` makes the site's sizes.
- 3D view: the case's front I/O (power key, USB) no longer sits on a printed front that reaches it: it moves
  above the front, or onto the roof when there is no room (a panel-only front, a tall rack in a short case).
- Web generator code: `main.js` (1,700 lines) split into modules by what they do: `state` (constants, shared state,
  DOM helpers), `model` (what fits, mirrors config.scad), `engine` (OpenSCAD workers, render cache, 3D view), `edit`
  (changes, undo), `widgets`, `steps` and `editors` (the configurator), `tabs`, `hash` (links), `render`, `kit`,
  `gallery` and `main` (wiring, start). No module runs code when it loads except `main`; lint-clean (no undefined or
  unused names; a dead helper of the ports editor and of the icons removed).
- Web generator: "What you can put in it" and "Example builds" are one section, "What you can build": each card is a
  build with what it is for and what to buy, and loads it. The row drags with the mouse like a swipe (touch already
  swipes), settles on a card and hides its scrollbar.
- Web generator, next level:
  - The last 40 renders are kept: going back to a piece or a view is instant. The kit renders on up to 3 more
    OpenSCAD engines at once (desktop, enough memory).
  - Installable app that works offline after the first visit (manifest, service worker); the 11 MB engine is kept
    until its version changes.
  - Spanish page at /es/ with its texts in the HTML, hreflang, structured data (SoftwareApplication), and a sitemap
    with both. A share page per ready-made build (/m/router/ …) with its own picture for link previews.
  - Undo / redo (buttons and Ctrl+Z / Ctrl+Y), your builds saved in the browser, short links (#z=…) when sharing.
  - The 3D view turns with the keyboard (arrows, + / -, Home) and tells screen readers what it shows; without WebGL
    the page says so and the steps, the lists and the kit still work (they hung on "Rendering…").
  - A link opened in the same tab, or a saved build, starts the engine (it did not).
  - Patch panels and labels are numbered in rack order in the piece list, the bare one included.
  - Browser tests (Playwright) in CI: the pages, the editor with real renders, the piece view, undo, short links, a
    full kit download.
  - Smoother scrolling: the page no longer snaps to each section (only the phone's one-screen configurator does),
    and the 3D view draws a frame only when something changes instead of 60 a second. PCFShadowMap (three.js
    dropped PCFSoftShadowMap).
- **M5 rack screws by default** (were M6): an M5 heat-set insert leaves 2.2 mm of plastic to the bay side instead of
  1.4 mm, the nuts fit too (no soldering iron), and M5 screws still go through the M6 holes of other mini rack
  panels. M6, 10-32 and 12-24 stay in the Screws step. Every pre-built STL is rebuilt; the rack test piece is now
  `tests/rack-M5-heatset.stl`.
- NanoKVM bay in a pocket (`nkvm:side`, not raised): its floor, roof and posts stop short of the rim of the adapter's
  front frame for the depth of that frame, and the plate's screw bosses keep clear of its edges.
- Web generator: the hero film loads after the page and is 960 px on phones (1.1 MB instead of 3.4 MB); it stays a
  still with reduced motion or data saving. Page weight on a phone: 3.2 MB -> 1.3 MB.
- Web generator, simpler: the steps most people leave as they are (device sizes, screws, print fits, multicolour,
  colour, 3D view) are folded to one line that says what they are set to; a "Download the kit" button stays at the
  foot of the steps from the first one; a first visit opens the ready-made builds; plain questions for the step
  titles ("What is the front of your case like?", "How does it sit at the front?", "What goes in the gap that is
  left?"), "Like a CD drive" for the bezel, "Pieces apart" for the exploded view, "Every parameter" for the
  advanced form; a patch panel module folds its ports to one line; "How it works" and the glossary moved next to
  the configurator.
- Web generator layout: the steps and the 3D view share one frame as tall as the window (both end at the same line,
  at any zoom), with the downloads, the bill of materials and the warnings under it.
- Web generator speed (Lighthouse on a phone: 47 -> 97, accessibility, best practices and SEO 100): the 3D view
  and the 11 MB OpenSCAD engine load when the configurator comes near the screen (at once with a link that has
  settings), the "Every parameter" form is built when it is opened, the English texts are in the HTML (no jump when
  the script fills them, and search engines read them), 640 px gallery images, robots.txt, sitemap.xml, llms.txt,
  a canonical address, security and cache headers, source maps, a caption track for the silent hero film, heading
  order and the tab list role.
- Every patch panel and label module of the rack has its own ports, port names and text (`patch:rj45m=NAS+hdmi+cover`,
  `label:MY_LAB`): two of them no longer share the first one's. The web editor edits each in its row of the rack
  contents, and the kit, the letters pieces, the covers and the bill of materials count each one. A bare `patch` /
  `label` still takes the strip's settings, so old links make the same pieces.
- Web generator: in the piece view, a rack module with settings after a colon (a KVM tray, a NanoKVM bay) showed the
  switch instead.
- NanoKVM bay, after a test print: `nkvm_headroom` (5 mm) of room over the board for its heatsink and the cables on its
  pins, so the mountain stands taller and the pocket and drawer lids sit higher; the drawer's opening in the plate is
  1.5 mm taller than the lid; nothing behind the plate (the drawer guides, the `nkvm:ks` rails and pedestal) reaches
  the bottom 3.5 mm any more, where it hit the rim of the adapter's opening; more room round the RJ45 and HDMI plugs
  (the drawer's port hole 2 mm wider all round with a chamfer, both caves of the mountain full height, wider cable ways).
- Web generator: a first question (a fan or buttons, sockets, or a rack for devices); a "No soldering iron" switch
  (M5 with square nuts, hex nuts in the bay); fixings that leave under 1 mm of wall to the bay side are off; the
  modules left out of the rack, the ports and the fans limited to what fits; plain warnings without parameter names;
  keyboard and screen-reader fixes; a mirror on GitHub Pages (https://abarriuso.github.io/bay2rack/).
- Model: the side-wall check covers every rack fixing (an M6 square nut or channel left 0.2 mm); hex nut pockets open
  behind the post; fans and button panels in the BOM only where they fit; metal keystone cells stay between the posts;
  PCI brackets with a keyhole an RJ45 plug passes; ports numbered by their place (covers carry no number).
- Build guide (`docs/BUILD.md`, in Spanish too): what to buy, the print order, the heat-set inserts, the assembly, the
  cables and power. The compatibility list has a five-minute case checklist and a Spanish version.
- Bill of materials: the keystones are back (a renamed list had hidden them); the hardware of every NanoKVM bay as it
  is built (drawer screws, raised-bay countersunk screws, `nkvm:ks` coupler and patch cable, the bay's keystones);
  M3 x 8 for the retro button carrier; stock screw lengths for 40 mm fans; the devices and their cables listed apart.
  Modules and panels screw into the adapter's fixings, so they no longer count a second set of inserts. CI checks BOM
  lines.
- Fit: a note when the rack inserts leave less than 2 mm of plastic to the bay's steel side (M6: 1.4 mm), and
  `test_rack` now has the real posts so it can be slid into a bay with its inserts in; the NanoKVM drawer slides out
  through its plate (clearance round the opening); keyhole cable ways and kept corner fingers on the raised NanoKVM
  bay; thicker retro carrier posts; printed buttons as thick as their panel; the frame opening lets an 80 / 40 mm fan
  through a separate filler; bolder engraved letters for a 0.4 mm nozzle.
- New test piece `test_button` (one MX key, metal push-button hole or retro cap opening); the MX cut-out is a print fit.
- Button panel: metal PC push buttons (12–22 mm) and a retro panel with printed caps on tactile switches, TURBO and
  named LEDs, besides the MX keys. Their icons and names print in the second filament with multicolour letters.
- Fan openings: round hole or hex grille (`fan_guard`).
- Web: every text in Spanish and English (Advanced form choices, warnings, bill of materials), one term for each
  thing; the steps hold up when the page is zoomed in or out; Print fits shows each test piece and real insert
  sizes; multicolour has its own step in Making it; PCI-slot brackets can be switched off.
- The 2U 12-port panel really has 12 ports, and the overhang STLs use the auto hole pattern; all STLs rebuilt.
- NanoKVM bay flat (`nkvm:front`): a drawer in three pieces - the plate with two guides, the drawer with the Ethernet port in its face (two screws), the lid; the drawer slides out of the front with the NanoKVM. The keystones keep clear of the rack post and the drawer sits centred in the rest.
- NanoKVM bay standing (`nkvm:side`): out of the case in a little mountain (`nkvm_raised`, new default) with its ports open at both sides, cables from outside or through slots into the case; three pieces (plate, mountain, lid) by default.
- LED strip fill removed.
- NanoKVM bay `nkvm:ks`: the network port comes to the front through a keystone; the NanoKVM lies flat right behind it, connected with a straight 10 cm patch cable, HDMI and USB into the case.
- `hole_pattern = auto` (new default): EIA-310 inside the bays, one centred hole per U when the units stick out, so overhang builds no longer have rack holes breaking out of the frame. A new CI check renders every example and bays x fit x front assembly.
- Port names over the patch panel (`ks_names`): your own, HDMI / USB / RCA / AUDIO / OPTICAL for those jacks, numbers in order for the rest.
- Multicolour letters (`labels_multicolour`): every panel with letters gets a `..-labels` piece to print in a second filament; the letter colour shows in the preview.
- Label: text, size, alignment, position, engraved or raised.
- Vent fill redesigned: vertical slots, louvres, honeycomb or holes (`vent_style`), with a solid rim (`vent_margin`).
- Editor: the viewer shows Mounted or one piece of the kit at a time; steps grouped (your case, what goes in, making it, the 3D view) with a print fits step and your own colour.
- README images rendered again from the v2 adapter, with the new trays and the NanoKVM bay.
- Fixed: a 1-bay build (no rack units) hung the 3D preview.
- Tolerances: `ks_fit` for every keystone opening (cells, cut-outs and covers follow), `nkvm_insert_d`, `mount_clear` round the NanoKVM; README and web tell you to print the test pieces first and tune them.
- Every number and size has a range (customizer and web), and the model warns about values that do not go together.
- The web generator moves to Cloudflare Pages: https://bay2rack.pages.dev/ (the old GitHub Pages address redirects there).
- Ready-made builds in a collapsible box before the steps; the 3D view keeps its full width on phones.

## 0.2.0 — 2026-10-15

**Adapter v2**
- Grooves for the metal tabs between the bays along the whole sleeve, with a rib inside so the wall keeps its strength.
- Stiffer side walls: inner lips on the top and bottom edges and fillets into the rack posts.
- 80 mm and 40 mm fan openings are plain round holes.

**Rack modules**
- KVM over IP trays for 1–3 boxes of your choice (JetKVM, NanoKVM, custom size).
- Raspberry Pi trays (Pi 5 / 4 / 3 / Zero, one or two boards) and 2U blades for up to four boards on edge.
- UniFi USW-Flex-Mini and UniFi Express trays, a 1U panel for three 40 mm fans, made-to-measure device trays.
- Modules of more than one unit; the rack fills from the top and a module that no longer fits becomes a blank.
- Audio keystones: RCA, 3.5 mm jack, Toslink.
- Printed brackets for two PCI slots to bring the cables in from the back.

**Configurator**
- New site, ready-made builds, a homelab scene with VLAN-coloured cables, sleeper case style.
- Spare-zone editor: split the strip in two and share its height; fills that don't fit are not offered.
- A warning on the viewer when something doesn't fit.

**Project**
- Hero film rendered in Blender from the same models (`scripts/blender/`).
- Model tests in CI (`scripts/test_models.py`): edge cases and every ready-made build.
- Compatibility list (`docs/CASES.md`) and issue templates for case reports and problems.
- MakerWorld upload kit (`scripts/makerworld.py`).

## 0.1.0 — 2026-10-13

First public release, from the adapter v1 that is printed and mounted in the photos.
- One parametric model for 1–6 bays: flush (N−1 U + a spare zone) or overhang (N U), plate or exact 5.25" bezel front.
- Keystone patch panel with metal holder cells or standard cut-outs, covers and cable pass-throughs.
- Selectable rack and bay hardware with automatic screw lengths and a bill of materials.
- Mercusys MS105G switch tray, shelf and button panel with MX switches and LEDs.
- Web generator on GitHub Pages: OpenSCAD in WebAssembly, 3D preview in a real PC case, kit download.
