abarriuso/bay2rack/(commit log)

2026-10-13 Initial release: parametric 5.25" bay to 6" mini rack adapter
    - Single-file OpenSCAD model with Customizer support
    - Flush (N-1 U + spare zone) and overhang (N U) fit modes
    - Plate or exact 5.25" drive bezel front
    - Spare-zone fills: keystone patch panel, vent, cable, LED, label
    - 6" rack following 10" mini rack conventions (EIA-310, M6)
    - Selectable hardware with auto screw length, BOM and preview
    - Presets, pre-built STLs, test pieces and build script
    - License: CC BY-NC-SA 4.0
    [1bay-patch6-adapter.stl, 1bay-patch6-filler.stl, 2bay-bezel-1U-patch6-adapter.stl, 2bay-bezel-1U-patch6-filler.stl, 2bay-flush-1U-patch6-adapter.stl, 2bay-flush-1U-patch6-filler.stl, 2bay-overhang-2U-adapter.stl, 3bay-bezel-2U-patch6-adapter.stl]
2026-10-13 Reorganize by variant, split the model into modules, add tower preview
    - Split bay2rack.scad into src/lib/ modules; the main file only holds parameters
    - scripts/build.py: one variant table generates the Customizer presets,
    stl/<family>/<variant>/ and an stl/README.md index with the hardware per variant
    - 21 variants: plate/bezel x flush/overhang for 1-4 bays, rack panels, test pieces
    - Preview: PC tower case (case_view) to show the adapter mounted
    - scripts/render_docs.py regenerates the README images
    - Fix: keystone test coupon had no cut-out (tried to fit 6 ports)
    - Fix: integral fill mode still drew and exported a separate filler
    - Fix: test_bay no longer includes loose frame slivers;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
    [1U-blank.stl, 1U-patch6.stl, 1U-vent.stl, 1bay-patch6-adapter.stl, 1bay-patch6-filler.stl, 2U-patch12.stl, 2bay-bezel-1U-patch6-adapter.stl, 2bay-bezel-1U-patch6-filler.stl]
2026-10-13 Metal keystone holder cells, cleaner README images
    - ks_style = metal (default): holder cell for metal / shielded keystones,
    replicated from the original adapter (15 x 16.5 opening, latch ramp,
    24.3 mm cavity, rear lips, 9.5 mm deep, 20 mm pitch); standard cut-out kept
    - Keystone count in the BOM; metal and standard test coupons
    - render_docs.py: cropped, anti-aliased, captioned image sheets instead of
    HTML tables with mismatched images
    [1U-blank.stl, 1U-patch6.stl, 1U-vent.stl, 2U-patch12.stl, adapter.stl, bay-bezel.stl, bay-plate.stl, bay2rack.scad]
2026-10-13 Web viewer + generator on GitHub Pages, example devices, deterministic STLs
    - web/: Vite + pnpm site that runs OpenSCAD (WebAssembly, Manifold) in a web
    worker: full Customizer read from bay2rack.scad, presets, pre-built STLs,
    colored 3MF assembly preview, BOM/warnings, shareable links, EN/ES, mobile
    - .github/workflows/pages.yml builds it with a frozen pnpm lockfile and deploys
    - Preview: 5-port switch, NanoKVM-style KVM and metal keystone jacks (demo_devices)
    - build.py: binary STLs with canonically ordered triangles (identical output
    every build, ~4x smaller), stl/index.json catalogue, no longer deletes stl/
    - .gitattributes: STL/3MF/PNG/WASM as binary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
    [1U-blank.stl, 1U-patch6.stl, 1U-vent.stl, 2U-patch12.stl, adapter.stl, bay-bezel.stl, bay-plate.stl, bay2rack.scad]
2026-10-13 Homelab scene, rack modules, keystone covers, button panel, new web UI
    Model
    - Real PC cases for the preview (Define R5, Obsidian 750D, Antec 300, Enthoo Pro,
    Define XL R2, HAF 932, Stacker 830): fixed size and bay count, no longer grows
    - Homelab scene: two client PCs, an access point, network cables from the back of
    the case into the patch panel, patch cords to the switch
    - Rack modules per U (rack_modules): Mercusys MS105G switch mount, shelf for
    NanoKVM / Raspberry Pi, patch panel, button panel, vent, blank, cable, LED, label
    - Per-port patch panel types (ks_ports_list): metal / plastic RJ45, HDMI, USB,
    plain cover, split pass-through cover, none; printable keystone covers
    - Butt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
    [2U-patch12.stl, bay2rack.scad, buttons.stl, keystone-blank.stl, keystone-pass.stl, keystone-standard.stl, ms105g.stl, patch6.stl]
2026-10-14 Real PC cases and materials, NAS + client PCs, PCI-slot cable exits, device trays, fan80 bezel
    - web: procedural PBR materials, real case catalogue, interior parts, NAS and an
    old PC with button + 80 mm fan bezels, cables leave through printed PCI-slot
    brackets, toggles for cables / side panel / devices / hardware
    - device trays for UniFi Flex Mini, UniFi Express, JetKVM + NanoKVM and two
    made-to-measure devices, editable sizes in the web UI
    - fit 'panel' (bezel only, no rack units) for client PCs
    - dev server serves src/ and stl/ live; scene build guarded per object
    [bay2rack.scad]
2026-10-14 KVM / Raspberry Pi trays, 2U Pi blades, 40 mm fans, bay tab grooves, new landing page
    - KVM tray with 1 to 3 boxes of your choice (kvm:jet+nano, kvm:nano+nano...),
    JetKVM / NanoKVM / custom sizes, fit check
    - Raspberry Pi trays: flat for 1-2 boards (Pi 5/4/3/Zero) and a 2U blade tray
    for up to 4 boards on edge; modules can now take more than 1U
    - fan40 module / fill with up to three 40 mm fans; fan openings are plain
    round holes by default (fan_guard)
    - grooves for the metal tabs between the bays so they no longer have to be
    bent, and stiffer side walls (inner lips + fillets into the rack posts)
    - audio keystones (RCA, 3.5 mm jack, Toslink), adjustable split of the spare
    zone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
    [bay2rack.scad]
2026-10-14 New site identity, router network card, horizontal expansion slots, export for Blender
    - site: rack-hardware identity (Archivo + Martian Mono self-hosted, label-maker
    tape labels, EIA-310 rail motif, faceplate cards), bay-to-units table computed
    from the model, gallery with a feature build, how-it-works on a trunk cable,
    footer with the author; checked at 375 / 768 / 1390 px; footer no longer
    stretches at the bottom of the page
    - scene: the router PC has a 4-port network card (WAN + trunk), expansion slots
    are horizontal under the I/O shield like a real ATX tower, Proxmox node and
    TrueNAS naming
    - dev-only GLB export of a build (named pieces and materials) for the Blender
    hero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
    [bay2rack.scad]
2026-10-14 Sleeper cases, coherent ATX interior, Blender hero film pipeline, README
    - sleeper look (90s beige tower: keylock, turbo, 133 MHz display, floppy, vents)
    with a modern server inside laid out like a real ATX board; named parts
    - scripts/blender/hero.py builds the film (unfold, transformer assembly, cables
    by VLAN, Proxmox Pi swap, other builds) and encode.py grades and exports it
    - the site hero plays the film with per-shot captions (poster until rendered)
    - README: what you can build, film stills, new modules, bay tab grooves
2026-10-14 Hero film on the site, zone editor, WAN into the fibre box, real fan model
    - the rendered Blender film (Cycles, 17 s) is the hero: full-width on a band the
    colour of its background, per-shot captions, replay, paused off-screen
    - leftover-strip editor: height of each zone, fills that cannot fit are struck
    out, ones that fit with another share move the share, a share slider and swap
    - the WAN now ends in the fibre box's LAN port, the box gets its fibre feed
    - fan model with a rounded frame, pitched blades, hub and struts; bezel grooves
    no longer run through the fills; the 80 mm fan warning and BOM are accurate
    - empty legend box no longer shows, a pasted share link loads in the same tab,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
    [bay2rack.scad]
2026-10-14 Neighbour PCs without the odd rear I/O plate, editor inputs that fit the panel
    - the Proxmox / TrueNAS boxes only show their network port at the back
    - advanced-mode inputs can shrink: nothing spills out of the side panel at
    laptop widths (checked every example at 1100 px)
    - README GIF of the build changes
2026-10-14 Hero: the film full width, chapters for its shots
    Design A from the canvas: the video runs edge to edge with the headline on the
    dark floor of every shot and the calls to action beside it; under it a chapter
    bar, one segment per shot, that fills as the film plays and jumps on click,
    with replay; the pitch and three facts below. The header turns dark while it
    sits on the film. On phones the chapters become touch segments with the
    current shot's caption, and the buttons move under the text.
    The live 3D hero restored in 3b69eef is retired: the film replaces it.
2026-10-14 Hero: text beside a larger framed video
    Back to the first layout, text on the left and the film on the right, with the
    video larger than before (two thirds of the width) and the shot chapters under
    it. Phones stack the text, then the video and its chapters.
2026-10-14 Hero: drop the facts row, chapter bars fill smoothly
    The three loose figures under the buttons are gone. The chapter bars repaint
    every frame while the hero is on screen (the loop also starts when the video
    was already playing before it was wired), instead of jumping on timeupdate.
2026-10-14 Hero: just the text and the film
    The shot caption, replay button and chapter bar under the video are gone,
    with their styles, strings and code; also two leftover rules of the old 3D
    hero. The film still pauses off screen and for reduced motion.
2026-10-15 Code cleanup, STL catalogue up to date
    - web: drop 16 strings nothing reads (old 3D-hero captions, hero bullet
    points, the old subtitle and source label, old KVM names), an unused colour
    constant, the unused viewer snapshot, a duplicated rule
    - model: drop MOD_COLOR, dummy_devices and two switch variables left over
    - build.py: the variant table follows the model again: UniFi, KVM (three
    pairings), Raspberry Pi (one, two, Zero, 2U blades) and 40 mm fan modules,
    bezels for the other PCs with fit = panel (buttons, vents, 80 mm fan, and
    fan + buttons), both PCI-slot brackets, a 1U 40 mm fan panel; every STL,
    the presets, stl/README.md and stl/index.json rebuilt (57 files)
    Co-Authore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
    [1U-fan40.stl, adapter.stl, bay-bezel.stl, bay-plate.stl, fan40.stl, kvm-jet-jet.stl, kvm-jet-nano.stl, kvm-nano-nano.stl]
2026-10-15 README: photos of the v2 adapter
    Two Cycles shots of the 3-bay adapter: from behind (tab grooves outside, ribs,
    lips and bay-screw inserts inside) and from the front. scripts/blender/product.py
    renders any part exported in mounting orientation.
2026-10-15 Corrected hero film; README without the film link and the builds GIF
    - film re-rendered: the WAN ends in the fibre box's LAN port and the box gets
    its fibre, the new fan model, neighbour PCs without the rear plate
    - README: no "Watch the full film" link and no GIF in The film
    - hero.py --between renders the in-between frames for 60 fps; encode.py
    interleaves them when present (--fps30 skips that)
2026-10-15 Hero film at 60 fps
    The 510 rendered frames interleaved with 509 rendered in-between frames
    (hero.py --between, same exposure): 1019 frames at 60 fps, MP4 4.8 MB,
    WebM 3.3 MB; poster and README GIF from the same pass.
2026-10-15 Web: fix invisible number fields, bigger viewer, editor fixes
    - number inputs shared the .num class with the step badge (11px, tape colour): renamed the badge
    - the bay table highlights the configured bay count, real stack heights, aligned columns
    - the viewer takes the stage height; on phones it sits before the steps and stays in sight
    - the examples step is always shown, so the steps don't jump between tabs
    - 2U modules are only offered where two units are left; tray slots read '+ add' / 'x remove'
    - splitting the strip keeps the height the current fill needs; zone heights follow the slider
2026-10-15 Footer without the rail, clearer; configurator results no longer cut off
    - footer: brand + work-in-progress note with a link to the issues, credits on one line below
    - the steps column stays in sight (sticky, own scroll); the viewer has its own height and the
    downloads, bill of materials and warnings follow below instead of scrolling inside a fixed box
2026-10-15 Model tests in CI, warning on the viewer, compatibility list, changelog, clearer bay table
    - scripts/test_models.py + workflow: 86 edge cases and every configurator build, no errors, no
    unexpected warnings, non-empty parts, rack screws in the BOM match the units; the cases that must
    warn (3 JetKVM, an 80 mm fan in a 1U strip, M6 nut traps) are checked to still warn
    - configurator: '1 thing does not fit' on the viewer, hover for the reason, click for the list
    - docs/CASES.md and issue templates (case report, problem); CHANGELOG with 0.1.0 and 0.2.0
    - bay table: bars to scale (blue = one U, grey = the strip), no highlighted row, plain wording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
2026-10-15 Web: on phones the hero buttons go under the film
2026-10-15 Web on phones: full-screen configurator (3D view on top, steps scroll on their own), header hides on scroll, iPhone notch and home bar, browser bars follow the theme; header buttons the same height; 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
2026-10-15 Web palette: one accent blue per theme (hero included), blue for every selected state, the how-it-works cable in the accent, unused colour tokens removed
2026-10-16 NanoKVM bay module (nkvm:side / nkvm:front): board flat on an open frame with the heatsink in the open, lid on M3 heat-set inserts, Ethernet and HDMI / USB to the sides or only Ethernet at the front,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
    [bay2rack.scad]
2026-10-16 NanoKVM bay (side): sunk 20 mm behind the plate behind a window tunnel, centred so the plugs on both ends stay inside the bay opening, keystones kept clear
    [bay2rack.scad]
2026-10-16 NanoKVM bay (side): standing in a pocket of the plate with the heatsink facing out, the lid as its front frame on M3 heat-set inserts, Ethernet left and HDMI / USB right inside the pocket, cables bac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
    [bay2rack.scad]
2026-10-16 NanoKVM bay (side): optional long lid over the whole pocket, three-piece version (plate printed apart, screwed to the pocket on M3 inserts), the board never leaves the pocket when the plugs do not fit
    [bay2rack.scad]
2026-10-16 Parameters: ranges on every number and size (customizer and web, values kept inside them), checks for values that do not go together (unknown modules, boxes and keystone types, frame narrower than th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
    [bay2rack.scad]
2026-10-16 Tolerances: ks_fit for every keystone opening (cells, cut-outs, covers), nkvm_insert_d, mount_clear round the NanoKVM; print-the-tests-first table in the READMEs, the web and the MakerWorld text
    [bay2rack.scad]
2026-10-16 NanoKVM bay: the small frame lid again, the plate covers the pocket round it so the plugs and the inside of the case are hidden (nkvm_cover); flat version raised on a pedestal so its Ethernet port li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
    [bay2rack.scad]
2026-10-16 NanoKVM bay (standing): vent slots and LAN / HDMI · USB labels on the covered sides of the plate, a zip-tie bar at each end of the pocket for the cables; the help says two pieces (three with the plat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
    [bay2rack.scad]
2026-10-16 NanoKVM bay (three pieces): plate and pocket screwed together from behind into inserts on the back of the plate, nothing on the front but the lid screws; the viewer's Modules tab picks the bay / plat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
2026-10-16 Editor redesign: the viewer shows Mounted or one piece of your kit at a time (named, never changes the steps); steps grouped as your case / what goes in / making it, with a print fits step for every 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
    [bay2rack.scad]
2026-10-16 Port names over the patch panel (yours, the jack type, or numbers in order); multicolour letters as separate pieces with their colour in the preview; vent fill redesigned (slots, louvres, honeycomb, 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
    [bay2rack.scad]
2026-10-16 hole_pattern auto (default): EIA inside the bays, centred when the units stick out - overhang builds no longer break rack holes out of the frame; whole-assembly check of every example and bays x fit 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
    [bay2rack.scad]
2026-10-16 README.es: assembly check in the repo layout
2026-10-16 Button panel redesigned: keyboard switch, metal PC push button (12-22 mm) or retro PC (printed POWER / RESET / TURBO caps on 12 x 12 tact switches in a screwed carrier, POWER / TURBO / HDD LEDs, pins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
    [bay2rack.scad]
2026-10-16 NanoKVM bay nkvm:ks: the network port reaches the front through keystone 1 (keystones centred), the NanoKVM flat right behind it on two rails with a straight 10 cm patch cable, HDMI and USB into the 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
    [bay2rack.scad]
2026-10-16 NanoKVM bay standing: out of the case in a little mountain with its ports open at the sides (plug in from outside, cables out or through slots into the case), three pieces by default (plate, mountain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
    [bay2rack.scad]
2026-10-16 NanoKVM bay flat: a drawer in three pieces (plate with two guides, drawer with the Ethernet port and a two-screw bezel, lid) that slides out of the front with the NanoKVM; keystones clear of the rack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
    [bay2rack.scad]
2026-10-16 README and help: the three NanoKVM bays as they are now (mountain, drawer, keystone)
2026-10-16 Web, from a non-technical user review: plain how-it-works text, print fits with units and the test piece that checks each one (insert rule the right way round), titles on the screw rows and the NanoK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
2026-10-16 From a maker's review: modules and panels screw into the adapter's fixings (no second set of inserts in the BOM), print fits referenced everywhere, insert holes show their real size, PCI brackets swi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
2026-10-16 Coherent texts in English and Spanish (user review, part 1)
    - Advanced form: every dropdown choice in Spanish (piece, fixings, heads,
    fills, modules, cases...) and readable English labels instead of
    variable names; the fill, button-cap and strip-position choices get
    labels in the .scad too.
    - Every warning and note of the model translated, the screw-length one
    included; the old tab-groove warning removed.
    - Bill of materials fully in Spanish, in Spanish word order (inserto
    térmico M3, LED de 3 mm), with decimal commas; the 80 mm fan line no
    longer half English.
    - Empty Spanish helps written; NanoKVM sizes labelled length / height /
    width; 5.25" shown with two decimals in the c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
    [bay2rack.scad]
2026-10-16 Model fixes from the technical review (user review, part 2)
    Bill of materials
    - Keystones were missing from every BOM: the port names list had the
    same name as the keystone list (OpenSCAD keeps the last one). Renamed,
    and test_models.py now checks BOM lines so it cannot come back.
    - NanoKVM bays: the hardware of the whole bay for any of its pieces;
    the drawer's two countersunk screws and inserts (M3 x 12); the raised
    three-piece bay as it is built (countersunk from the back into
    inserts in the mountain posts); no plate-to-pocket line for nkvm:ks,
    which needs a keystone coupler and a 10 cm patch cable instead; the
    bay's own keystones counted.
    - Retro switch carrier: M3 x 8 (an M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
    [1U-patch6.stl, 1U-vent.stl, 2U-patch12.stl, adapter.stl, bay2rack.scad, button-metal-16.stl, button-mx.stl, button-retro.stl]
2026-10-16 Web: the page holds up when zoomed in or out
    - Zoomed in on a laptop (a short, wide window under 900 px of CSS width)
    the configurator switched to the phone layout: the 3D view on top took
    almost the whole height and left the steps a sliver. The one-screen
    layout is now only for upright screens; short wide ones (zoom, a phone
    on its side) keep the steps and the view side by side, with a narrower
    steps column. main.js uses the same query for the results and the
    hiding header.
    - The 3D view's minimum height is lower, so it fits a short window.
    - Zoomed out, the header no longer runs to the window edges: it lines up
    with the hero and the configurator (one page width), and the
    fu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
2026-10-16 Docs: build guide, case checklist, README and CHANGELOG up to date (user review, part 3)
    - docs/BUILD.md (+ Spanish): tools and filament, what to buy (with the
    hex-nut option that needs no soldering iron and the DVD drive's
    screws), the test pieces under every name they have, print order,
    heat-set inserts (the thin wall of the M6 rack inserts), assembly,
    network / KVM / power / button wiring, and what to change when
    something does not fit. The kit's README links it in its language.
    - docs/CASES.md (+ Spanish): a five-minute case checklist (bays, side
    holes, tool-less clips, tabs, plate or bezel and bezel_depth, doors,
    depth); the reported case no longer reads "to confirm".
    - RE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
2026-10-16 Docs: without a soldering iron, a square nut for M6 rack screws (a hex nut only fits M3-M5)
2026-10-16 Web for non-technical users (user review, part 4)
    - Steps: how to count the bays; plate or bezel explained, and the bezel
    depth slider in the Front step; the devices are bought apart; device
    sizes only to change if yours differs; a type picker on every port
    (works on touch, no right click); keystone type with a title and a
    hint; bay screws in the Screws step with the no-soldering-iron option;
    titles on the fan, button and LED rows; an "i" on every step.
    - What you need: grouped into to buy, to print (the kit's pieces), tools
    (insert iron, hex key sizes, screwdriver, cutters) and the devices and
    cables you add.
    - Test pieces only download.
    - Glossary (rack, U, bay, keystone, pat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
    [bay2rack.scad]
2026-10-17 Editor: fixes from the second UX review (crashes, BOM, warnings, mobile)
    - Unknown tray boxes and '+' in links no longer break the editor; refresh() survives a failing part
    - BOM: only the keystones that fit, HDMI/USB cables only with a KVM, NanoKVM Lite, Spanish screw lines, imperial hex keys
    - Warnings without parameter names, one decimal, the 250 mm check as a note with the bed size, M6 insert note in the Screws step
    - Ports numbered by place (covers unnumbered), plastic/metal converts the RJ45 ports, port and fan counts limited to what fits
    - Modules left out of the rack are listed; NanoKVM bay settings shown once, short labels, per-version hint
    - Examples reset what was set inside the b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
2026-10-17 Rebuild the patch panel STLs: covers and pass-throughs carry no number
    [1U-patch6.stl, adapter.stl, filler-keystone6.stl, patch6.stl]
2026-10-17 Model, from the third user review: what really fits, and where the screws go
    - Every rack fixing gets the side-wall check (an M6 square nut or channel left 0.2 mm to the bay side)
    - Hex nut pockets open through the fillet behind the post, so the nut can go in
    - 40 mm fans and button panels count in the BOM only where they fit; fan screws long enough for the plate they go through
    - Metal keystone cells stay between the rack posts when the opening narrows
    - A raised label cut into the frame keeps its letters in multicolour (there is no letters piece for it)
    - PCI brackets: a keyhole an RJ45 plug passes (15.6 mm), and the same keyhole for the power cable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
2026-10-17 Web, from the third user review: a first question, plain words, keyboard and links that hold
    - First step: a fan or buttons / sockets / a rack for devices; it keeps your bays and sets the fit and fills
    - Panel only: no PCI brackets, a vent to start with, "What goes on the front", no rack-screw block without rack screws
    - "No soldering iron" switch (M5 + square nuts, hex nuts in the bay); fixings that leave under 1 mm of wall are off;
    "Use M5" next to the M6 insert note; the guides no longer advise an M6 square nut
    - Links: spaces stay spaces, choices and vectors not on their list fall back to the default, in-page links keep the settings
    - Piece view moves to a piece that exists; a failed r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
2026-10-17 Rebuild the PCI bracket STLs: keyholes an RJ45 plug passes
    [pci-lan.stl, pci-power.stl]
2026-10-21 NanoKVM bay: taller mountain, drawer that fits the adapter, roomier plugs
    After a test print:
    - nkvm_headroom (5 mm): room over the board for the heatsink and pin cables,
    so the mountain is taller and the pocket / drawer lids sit higher.
    - The drawer's opening in the plate clears the lid by 1.5 mm.
    - The drawer guides and the nkvm:ks rails / pedestal start 3.5 mm up: from
    the bottom they hit the rim of the adapter's front opening.
    - More room round the RJ45 and HDMI plugs: the drawer's port hole 2 mm wider
    all round with a chamfer, both mountain caves full height, wider cable ways.
    - The web editor shows the new size next to the NanoKVM dimensions.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
    [bay2rack.scad]
2026-10-21 Each patch panel and label module has its own ports, names and text
    Two patch panels in the rack shared one port list and one set of names
    (ks_ports_list / ks_names), and two label modules one text, so editing
    the second changed nothing of its own. Now:
    - patch:rj45m=NAS+hdmi+cover carries its own ports (= a name, _ a space)
    and label:MY_LAB its own text; a bare patch / label keeps the strip's
    settings, so old links make the same pieces.
    - The keystone layout takes the metal cells per panel (ks_metal_of),
    the BOM counts the jacks and covers of each panel, an unknown port
    type in a module is warned about.
    - Web: each patch / label row of the rack contents edits its own ports,
    names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
2026-10-21 Web generator: simpler steps, one framed workbench, a fast first load
    Simpler:
    - The steps most people leave as they are (device sizes, screws, print
    fits, multicolour, colour, 3D view) fold to one line with their value.
    - A "Download the kit" button stays at the foot of the steps.
    - A first visit opens the ready-made builds.
    - Plain questions as step titles; "Like a CD drive" for the bezel,
    "Pieces apart" for the exploded view, "Every parameter" for the
    advanced form; the patch panel module folds its ports.
    - "How it works" and the glossary sit at the head of the configurator.
    Layout: the steps and the 3D view share one frame one window tall (in CSS
    px, so it follows the browser zoom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
2026-10-21 M5 rack screws by default, NanoKVM pocket clear of the frame rim, lighter hero film
    - rack_screw defaults to M5: its insert leaves 2.2 mm of plastic to the bay
    side (M6: 1.4 mm), nuts fit without a soldering iron, and M5 screws pass
    the M6 holes of other mini rack panels. Every STL rebuilt; the rack test
    piece is tests/rack-M5-heatset.stl. Docs, MakerWorld texts and the web
    texts follow; tests cover M6 explicitly (and its 1.4 mm note).
    - nkvm:side in a pocket: floor, roof and posts stop short of the front
    frame's rim for the frame's depth; the plate bosses keep nk_lo clear.
    - Web: the hero film loads after the page, 960 px on phones (1.1 MB vs
    3.4 MB), a still for reduced motion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
    [1U-blank.stl, 1U-fan40.stl, 1U-patch6.stl, 1U-vent.stl, 2U-patch12.stl, adapter.stl, bay-bezel.stl, bay-plate.stl]
2026-10-22 MakerWorld texts: the mirror, per-panel ports, the NanoKVM Lite bay, the new step name and screw list
2026-10-26 Remove dead code and stale names
    - Model: n_patch() (replaced by patch_sets()), nk_r_zv0(), and the strip's
    ks_cw / ks_lo / ks_hi / ks_px globals (each panel takes its cells from
    its own ports now).
    - Web texts nothing shows any more: build_lead, how_tape, fam:*, filament,
    free, noHexM6, piece_bay.
    - README: the new step and form names; scripts/blender/product.py listed.
2026-10-26 Web generator: render cache and parallel kit, offline app, /es/ and share pages, undo and saved builds, keyboard 3D view, browser tests
    - Engine: the last 40 renders are kept; the kit renders on up to 3 more
    OpenSCAD workers at once (desktop, enough memory).
    - PWA: manifest, icons and a service worker (engine cached by version,
    hashed scripts cache-first, the rest network-first, offline fallback).
    - SEO: /es/ built with the Spanish texts in it, hreflang, JSON-LD
    SoftwareApplication, sitemap with both; /m/<build>/ share pages with
    their own picture. BASE now comes from the script, so one bundle
    serves both pages; the language follows /es/.
    - Undo / redo (buttons, Ctrl+Z / Ctrl+Y), b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
2026-10-26 Smoother scrolling: no page snapping, the 3D view renders on demand; PCFShadowMap
    The full-screen sections snapped the scroll towards them (proximity), the
    configurator too; only the phone's one-screen configurator keeps it. The
    viewer drew 60 frames a second with shadows and MSAA even when still: it
    now draws when the camera moves (and its damping), the model or a setting
    changes, or it comes back on screen.
2026-10-26 Split web/src/main.js into modules
    main.js (1,700 lines) becomes 14 modules along its sections: state, model,
    engine, edit, widgets, editors, steps, tabs, hash, render, kit, gallery and
    main. state.js is a leaf (setColour moved to engine.js) and only main.js runs
    code when it loads (the dev hooks and the gallery wiring moved into boot), so
    the circular imports between the others are safe. Imports checked with eslint
    (no-undef, no-unused-vars): clean. Dead code gone: the ports editor's cycle()
    and the icons' line() helper.
2026-10-26 Gallery: Blender renders, each build in its own case and setting
2026-10-26 3D view: the case's front I/O never sits on the printed front
    Above the front when there is room, else on the roof. Gallery renders redone without the overlaps.
2026-10-26 3D view: PC cases in detail, consistent with bay2rack.scad
    Real fans behind wire guards, I/O shield ports, slot covers, PSU face, drive cage, SATA ports,
    motherboard tray (board always on +X), roof fans under the roof, client PC and NAS backs.
2026-10-26 Homelab scene: cables inside the case along the roof and down the back wall
2026-10-26 3D view: a modern build inside the case; the cable ribbon tied to the roof and the back wall
    Black board with traces, DIMMs with spreaders and slots, armoured PCIe slots, M.2 heatsinks, PSU shroud,
    sleeved 24-pin / EPS through grommets, SATA over the shroud, cage walls with holes, velcro ties.
2026-10-26 3D view: back wall with real openings and a honeycomb vent, CPU backplate, cables off the wall
2026-10-29 Consistency: builds load the case of their picture, one name per build, Bay2Rack, touch targets
2026-11-11 Model: no shelf, two NanoKVM bays, fans from 40 to 120 mm
    - The 1U shelf is gone: the device trays cover what it held.
    - The NanoKVM Lite bay keeps two versions: nkvm:side (standing outside the
    case, in its mountain) and nkvm:ks (inside, its network port at a keystone).
    The drawer (nkvm:front) and the pocket in the plate are removed, with
    nkvm_raised, nkvm_cover and nkvm_vents.
    - Fans of 60, 80, 92 and 120 mm next to the 40 mm ones, as rack modules that
    take the units they need (2U, 2U, 3U, 3U) and as fills of the strip or of a
    bezel. fan40_count becomes fan_count: each place takes as many as fit.
    - STLs rebuilt: the fan modules and a 3-bay 120 mm bezel; shelf.stl removed.
    - Tests: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
    [adapter.stl, bay2rack.scad, fan120.stl, fan60.stl, fan80.stl, fan92.stl, shelf.stl]
2026-11-11 Web: follow the model, fix the footer and the menu, motion in the configurator
    - The configurator offers the fans of every size (only where they fit), the
    two NanoKVM versions, and no shelf; a 2U / 3U module says how many free
    units it needs.
    - Footer: no empty band under it (the hidden texts of the steps reached past
    it), and its credits say which licence is whose.
    - Menu: "How it works" goes to the three steps, "Configure" to the
    configurator; jumping there no longer cuts it at the bottom.
    - Phones: the choice cards are rows instead of three narrow columns.
    - Motion (transform and opacity only, nothing running while idle, off with
    "reduce motion"): the camera glides, a new result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
2026-11-11 Docs, MakerWorld package and print profiles, CI
    - README, build guide and MakerWorld descriptions follow the model (fans,
    NanoKVM versions, no shelf); the modules picture shows two pieces.
    - scripts/bambu_profiles.py: Bambu Studio projects for MakerWorld with the
    pieces on named plates (the 3-bay kit, and every rack module on its own
    plate), arranged and sliced by Bambu Studio's own command line.
    - scripts/makerworld.py lists the new fan STLs and finds OpenSCAD like the
    other scripts.
    - CI: the model tests run when the ready-made builds change (the workflow
    watched main.js, they live in examples.js).
2026-11-11 Scroll film: the Blender scene of the rack coming apart
    scripts/blender/scroll.py renders the film the page will play with the
    scroll: a retro homelab, the rack in close-up, its screws and cables coming
    off, the modules shooting out and hanging in the air while the camera
    orbits, the side panel opening for the bay screws, the adapter, and the kit
    on the table. A dark and a light version; no brand names in the picture.
    hero.py only runs when it is the script (scroll.py borrows its studio).
2026-11-11 3D view: the NanoKVM bay's screws, the retro tower's controls under its bays
    - The NanoKVM bay shows its own screws where the bill of materials says they
    go: four M3 countersunk through the lid and, in three pieces, four from the
    back of the plate into the mountain. Its holes were empty.
    - The retro tower's lock, lights, MHz display and keys sit in a row under the
    drive bays, like the towers of the 90s; beside the bays a real case has no
    room for them.
    - Scroll film: a rack with one switch (black, so it reads in its tray), the
    KVM lite and the round-hole vent panel; each shot shifted off the side of
    its text; the kit lands earlier and fits the frame.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
2026-11-11 Web: the page opens with a film you play with the scroll
    The hero video gives way to a tall section whose stage stays on screen while
    the page scrolls through it: film.js draws the frame of that point (240
    frames rendered by scripts/blender/scroll.py) and lights the text of that
    stretch, on the side the shot leaves free.
    - A dark and a light film: the frames follow the theme.
    - Wide screens get 1600 px frames; phones every second frame at 960 px. The
    frames load coarse first, so the whole film scrubs after the first pass.
    - A screen taller than 4:3 crops the sides: the subject goes to the middle
    and the text to the foot.
    - With "reduce motion", data saving or no frames it is a plain sec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
2026-11-11 Web: a simpler page with the colours of the film
    - Palette: the cream plastic of a 90s tower (light theme) and the black of
    its inside (dark theme), flat, with the red of its display as the only
    accent: links, focus, the numbers of the steps. What is on or pressed (the
    main button, a chosen chip, a tab, a switch) is the dark key, not a colour.
    - Four blocks: film, builds, configurator, foot. The "Why" section and its
    table of bays are gone (the film says it), with the tags over the titles
    and the three how-it-works steps (one line and the build guide link now).
    - The header keeps the name, the builds and the configure key; the footer
    is one row; the glossary sits under the config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
2026-11-11 Web: clean and bold, as wide as the configurator
    - Pure white or pure black, square corners, hairlines; the red of the display
    stays as the only accent and the colour is left to the film.
    - Very large headings set wide and in capitals, the title on the left and its
    line on the right under a rule; they come up as they scroll into view.
    - Every block shares the edges of the configurator (1640 px) instead of a
    narrower column, so a desktop screen has less empty margin.
    - The name runs across the whole foot.
    - scroll.py --between N renders the moments between each two frames of the
    film (a finer scroll without rendering again what is there).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
2026-11-11 Film: ready for the in-between frames
    - film.js takes the frames of each text from film.json (the page no longer
    repeats them) and loads from every 64th frame down, so a film of a
    thousand frames scrubs after the first pass.
    - scroll_encode.py puts the frames of scroll.py --between after each frame
    of --render, numbers the files with four digits and gives phones one frame
    in four.
2026-11-11 Film: four times the frames (957 per theme), smooth on any scroll
2026-11-11 Web: phones first, the edited part lit in 3D, an accessibility pass
    - iPhone / phones: theme before first paint, safe areas, svh with vh fallbacks,
    44 px targets, no layout reads while scrolling, a memory budget for the film's
    frames, headings that fit at 320 px; a phone test.
    - The 3D view outlines the part a step edits (hover, focus, tap) and flares it
    when the change lands (scene_echo gives the parts' boxes).
    - Accessibility: focus follows in-page links, film texts reachable by keyboard,
    plain film at 400 % zoom, a quieter live region, warning counts announced,
    named fields and groups, h3/h4 order, pressed states, 3:1 edges on controls,
    film text contrast, hoverable and descri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
2026-11-11 No brand names in the cases and examples, a configurator that keeps its shape, CI on Ubuntu 24.04
    - The preview's case models get generic names (quiet mid tower, mesh full tower...),
    in both languages; their ids stay, so shared links still work. The example texts
    speak of switches, KVM over IP, boards, a firewall, a NAS, not of products.
    - The configurator is never much taller than wide (a page zoomed far out stretched it
    into a strip), and the 3D view frames by the narrower of its two angles.
    - Web tests: ubuntu-latest is now 26.04, where Playwright 1.56 has no browsers.
    [bay2rack.scad]
2026-11-12 No soldering iron means none at all; the film's key frames at 2560 px
    - m3_fixing: the M3 screws of the NanoKVM bay (lid, three-piece mountain) and of the
    retro button carrier go into heat-set inserts or, with "No soldering iron", straight
    into the plastic (2.5 mm pilot holes); the BOM follows, the step's texts rewritten.
    - scroll.py --sharp renders the key frames again at 2560 x 1440; scroll_encode.py
    adds them as a "sharp" set (and names each set's role: base, fine, sharp).
    [bay2rack.scad]
2026-11-12 The film ends inside the configurator; blueprint, explode, share card, finish screen
    - Film: one loader for three tiers (240 frames first, 957 in full, 2560 px key frames
    when the viewer stops on a wide screen); a coda that closes into the workbench and
    hands its angle to the 3D view
    - 3D view: blueprint mode (edges, sizes, screw lines) and a live exploded view
    - Motion: theme switch as a circle reveal, a language swap, headings that widen
    - Share card per build (1200x630, Web Share), m/<build>/ pages with their own previews
    - Finish screen after the kit download: plates, grams and print time
    - Bugs: gallery drag no longer clicks, links without a trailing #, saved builds and
    hash chang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
    [bay2rack.scad]
2026-11-12 A film that plays smoothly on phones, a first look worth opening on, whole screws when it comes apart
    - Phones: a reel of decoded pictures around the scroll position (ImageBitmap, cut to what the
    screen shows) instead of 120 pictures decoded as they were drawn; an upright set of frames
    (tall, 479 a theme) and the fine picture where the scroll rests
    - The film's end takes the configurator's real box (edges, height, steps column) at any zoom
    - Zooming or resizing keeps the place in the film
    - The first look: a four-bay sleeper in the homelab, patch panel, switch, KVMs and vents, its
    cables plugged in; the view opens on the rack
    - The scene's cables also run from a patch module; two pass-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
    [bay2rack.scad]
2026-11-12 A film that loads what is watched, shorter and skippable; a phone configurator with room
    - The fine frames (1600 px, 21 MB a theme) load around the scroll position only, ahead of the
    way it goes, and wait while the film is off screen: 2.6 MB for a visitor who never scrolls
    it, instead of 23
    - The frames are asked for under the film's version (film.json "v") and kept a month
    - The film is 6 screens instead of 8.3 (5.4 on a phone); from the second text on, a key skips it
    - Phones: the bar over the 3D view is one row again, the 3D view a little lower and the kit's
    bar only its button, so the steps get the room
2026-11-12 The configurator one line after its heading, a first look on the rack, pictures with their words
    - The ready-made builds wait folded over the configurator (they are in the gallery right above);
    open when there are saved builds
    - One "Configure yours" heading: the film's last text is "Now, yours"
    - The homelab view opens close on the rack and its patch cords
    - Gallery pictures have their alternative text; the case select has a name; an option that
    cannot be chosen says why at a readable contrast
2026-11-12 The film in step with its sharper pictures: the frame it shows is the scroll's, and the sharper one fades in
    The sharp pictures (2560 px) are every 4th frame, and the film drew the nearest one where it rested: stopped on
    frame 301, it jumped back to 300 as it sharpened. It now settles on that key frame first (a frame or two,
    gliding, never across the edge of a text), and the sharper picture of the frame on screen fades in over the
    softer one in 260 ms instead of snapping to it. A fine picture is drawn only when it is as near the scroll's
    frame as the base one, and every picture is decoded off the page's thread before it counts as loaded (a
    sharp one decoded at its first draw took 23 ms, past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
2026-11-12 The same glide at 60, 120 or 144 Hz; sharp film pictures halfway between the key frames
    The film followed the scroll a fifth of the way per refresh, and the 3D view's drag damped by 12 % per refresh:
    on a 120 Hz screen both ran twice as fast. They now go by the time that passed (the same feel, twice the
    pictures). scroll.py --sharp also renders the halfway moment between each two key frames (h_####.png), and
    scroll_encode.py interleaves them when both themes have all of them: a sharp picture every other frame.
2026-11-12 A sharp film picture every other frame; the router build seen close in the gallery
    The 2560 px pictures where the scroll rests are now every 2nd frame (the halfway ones rendered again), so the
    film settles at most one frame away from where it stopped. The router's gallery picture was a wide shot of
    the shelf with the rack a third of its height; it is now on the rack, the PCs next to it at its side, from
    the scene as the configurator draws it today.
2026-11-12 A change of theme fades the film into its other light, no stray frame on the way; every key of the header says what it does
    On a phone the new theme's reel started at the first frame and drew the first picture it decoded, from
    anywhere in the film, before the right one came. The new film now asks first for the files where the film
    is, and what is on screen stays until it has a picture of that frame (the fine one on a wide screen), then
    fades into it. The language and source keys have their tips, as the theme key had.
2026-11-12 The film ends in the configurator: its kit builds itself in the 3D view, with sounds
    The configurator now comes right after the film (the gallery after it), lifted so
    that where the stage lets go its 3D view lies exactly where the coda's window is.
    There the workbench fades in over the stage. The first model - the film's own
    build, now the configurator's first look - is laid out on the table as the last
    frame shows it (scripts/blender/scroll.py --table -> docs/scroll/table.json),
    seen from the film's camera at the frame's place on the page. Then it builds itself:
    the adapter, its screws, the side panel, the modules from the bottom with theirs,
    the cables, while the camera rises to the config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
2026-11-12 Textos más claros y espaciados pulidos en el configurador
    - "peana" en vez de "montañita", "conectores" en vez de "enchufes", "×" en las medidas
    - Pistas reescritas: tipo de keystone, nombres de puerto, tapas PCI traseras (con su pista bajo el interruptor)
    - Pasos plegados: la flecha ya no salta de línea; títulos más cortos
    - Paso 1 en columna en paneles estrechos; sin palabras huérfanas en párrafos
    - El desplegable de montajes alinea su flecha en el móvil
2026-11-12 Vuelve el paso de antes de la película al configurador; la galería va antes del editor
    Revierte 353f4a9 (fusión con el editor, montaje animado y sonidos). Orden de la página:
    película, «Qué puedes montar» y al final el configurador.
2026-11-12 El configurador empieza con el PC de la película, sus piezas en beige
    Vuelve el montaje de inicio nuevo (cuatro bahías en el homelab: switch, NanoKVM de lado y
    rejilla) y un filamento beige, a juego con la caja de los 90, que es el de serie.
2026-11-12 La película termina montando el PC en el editor, con el scroll
    Tras la coda, el propio visor 3D toma el último fotograma de la película:
    las mismas piezas en la mesa (una placa limpia renderizada en Blender y
    apoyada en el suelo 3D), vistas desde la misma cámara. Al seguir bajando,
    el PC se monta desde la mesa con la vista explotada: el adaptador entra,
    se cierra el lateral, los módulos vuelan delante de las bahías y entran
    de arriba abajo con sus tornillos. La cámara pasa por un plano general y
    llega al encuadre del editor; donde el escenario se suelta, el lienzo
    vuelve a su visor sin un píxel de salto y solo aparecen los pasos y los
    controles. Hacia arriba se desmonta. Se reencuadr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
2026-11-12 Cuadre al píxel del scroll en la fusión, y la película a pantalla completa en el móvil
    - La fusión se activa justo donde el escenario se suelta (antes medio píxel
    antes) y sin redondeos: el visor cae exactamente sobre el cuadro del
    montaje en cualquier tamaño y escala.
    - El cuadro del montaje mide lo que el visor (#view), no su marco: en el
    móvil era 1 px más alto.
    - Móvil: la película ocupa toda la pantalla y la cabecera pasa por encima;
    ya no queda una franja vacía arriba al esconderse, y el final de la
    película es el sitio del editor (sin el deslizamiento de 57 px).
    - Mientras la película lleva el scroll no hay snap: la página no avanza sola
    en mitad del montaje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
2026-11-13 Pulido de la fusión: subida corta, sin corte al 3D, salida fácil en el móvil
    - El montaje es solo la primera vez: ya en el editor y con la página quieta,
    su tramo de scroll desaparece sin que se mueva nada en pantalla. Subir
    desde el editor lleva directo al final de la película.
    - Sin corte al pasar al 3D: en la mesa no aparecen los aparatos (switch,
    KVM, puertos), que la película no tiene; surgen durante el vuelo de su
    módulo. El fundido es más largo, con cámara y piezas quietas hasta que
    termina, y las sombras del 3D empiezan en cero.
    - Móvil: en el editor la cabecera vuelve al subir los pasos (las pestañas
    del visor se apartan), y al pasar del principio o del final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
2026-11-13 Móvil: salir del editor, montaje reversible con sonido, recarga en su sitio
    - Arreglo: abrir o recargar la página pasado el 40 % de la película lanzaba un error
    y dejaba la fusión sin montar (la película arrancaba antes de tener todo listo).
    - Recargar (o volver atrás) deja la página donde estaba: el editor sigue en su sitio.
    - Móvil: arrastrar en vertical sobre la vista 3D mueve la página (girar: en
    horizontal; dos dedos, zoom). Fuera el imán que devolvía al editor al subir;
    en su lugar, al llegar bajando, la página se coloca sola si se pasó un poco.
    - Una vez montado, el tramo se acorta (80/70 svh) en vez de desaparecer: al subir
    desde el editor el PC se desmonta a la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
2026-11-13 El montaje se reproduce solo una vez la película pasa al 3D
    Bajas con el scroll hasta que la imagen de la película se convierte en la vista
    3D; desde ahí la página sigue sola hasta el editor al ritmo del montaje (unos
    4,5 s el tramo entero), con las mismas poses y sonidos. Un toque, la rueda o una
    tecla hacia arriba lo paran; un scroll hacia abajo lo acompaña. Igual la segunda
    vez, en el tramo corto.
2026-11-13 Móvil: el editor se queda quieto; botones para subir y para pantalla completa
    - En el móvil, al llegar al editor la página deja de desplazarse: los pasos se
    desplazan dentro y un dedo sobre la vista 3D gira la build. La cabecera se va.
    - Botón «Volver arriba» en la esquina de la vista: sube a la película,
    desmontando el PC por el camino (con sus sonidos).
    - Botón de pantalla completa: la vista 3D ocupa toda la pantalla y se
    reencuadra; donde el navegador lo permite (no en iPhone), también se van sus
    barras. Escape o el mismo botón vuelven.
    - Test: la longitud del tramo se lee antes de llegar al editor (carrera).
2026-11-13 Sonido en el despiece y un aire suave al hacer scroll por toda la página
    - Despiece (botón o deslizador): cada pieza suena al salir de su sitio
    (desencaja, desatornilla, el lateral se suelta) y al volver (encaja,
    atornilla). Cada pieza suena una sola vez aunque rebote el muelle, con
    cuatro sonidos por fotograma como mucho.
    - Scroll de toda la página y de los pasos: un soplo de aire que sigue la
    velocidad, más bajo y más grave que el del final del vídeo, que se queda
    como estaba. Los saltos de un enlace no suenan.
2026-11-13 web: a smooth first scroll - the 3D view starts early, in pauses, without holding the page
    The film's build is made ahead (scripts/first-render.mjs, docs/scroll/first.*) and served beside the model when it
    was made from this very model (a sum of all of src/: copy-assets.mjs, and a test), so the PC is built on the table
    before the engine has even loaded. The 3MF is read in a worker (mesh-worker.js: the same geometry, 680 ms off the
    page), the shaders compile alongside the page (KHR_parallel_shader_compile, for the composer's target), the studio's
    light uses a lighter blur (its shader took half a second to build on Direct3D), the scene around the build is made a
    few pieces at a time and its fi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
    [first.3mf]
2026-11-13 web: the film's sound key is a speaker that turns the sounds on and off; keys and renders sound
    The film's key is there all along (by the one that skips it): a speaker, crossed out while the sounds cannot be heard,
    that turns them on or off - kept in step with the editor's. Every key of the page answers with a soft click (lower for
    what turns something off); the visitor's render ticks while it takes a moment and chimes when it is on screen (two
    low notes if it fails). The module's snap has a little body to it, the screw's last turn a little ring of metal, the
    build's settle is a soft chord. The audio wakes on any click too, and comes back after an iOS interruption; a first
    click on the key n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
2026-11-13 Film first, then the 3D, then the engine; no long tasks while scrolling
    - Load order: the 3D view and the build made ahead start once the film's
    pictures are in (or 30% into the film); the 11 MB OpenSCAD engine only
    once the build is on screen or the visitor is in the configurator.
    - The build made ahead is fetched and read in the worker as soon as the
    film is in, alongside the view's start.
    - Long jobs run in slices of a few ms after each frame (state.js sliced/
    afterFrame): the scene (the case is a generator, the vent field cut in
    strips), the shader compiles, the split onto the table, the first draw.
    - The studio light's and the first frame's shaders compile alongside the
    page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
2026-11-13 Phone bars take the colour of what is under them
    The status and address bar follow the page: the film's picture (its top
    edge, frame by frame, from docs/scroll/edges.json made by
    scripts/blender/scroll_edges.py), the 3D view's studio, else the page's
    own background. Asked after a frame, a few times a second while it scrolls.
2026-11-13 Phone editor: taken square and held after a fling past it; more room for the steps
    A swipe that carries the page past the configurator (up to most of a
    screen) is put back onto it once at rest - never short of where the
    stage lets go, so the film cannot come back over it - and the page is
    held there (within a few px, only once merged). Steps scrolled on: the
    3D view lowers to a glimpse without its keys, back at their top or at a
    touch on it.
2026-11-13 Film texts and keys pass contrast over any picture
    The scroll hint takes the stronger quiet ink (4.5:1 over the light film),
    and the skip and sound keys sit whole on a near-solid plate of the
    page's ground instead of a see-through glow (7:1 and up, the light PC
    behind them in the dark film included). axe: no violations, both
    themes, desktop and phone.
2026-11-13 Film: the build plays on to the editor; "Configure yours" rides it; smaller phone keys
    - Stopped mid-build, the build glides on (slowing to a cruise) and always completes; a finger or the
    wheel adds speed, up gives the page back.
    - A fast fling into the last stretch is taken at its own speed and braked to a stop at the editor,
    never rushed through it.
    - "Configure yours" runs down the film and plays the build to the editor (the skip key still jumps).
    - Phone: the keys over the 3D view and undo/redo are smaller to see, their touch targets kept.
2026-11-13 Film drive: the build stays on screen while it drives; let go at the finger's speed
    - The touch lock is on the root alone: a body hiding its overflow became its own scroll box and the
    film's sticky picture stayed behind (a blank screen while the build drove itself, seen in WebKit).
    - A finger let go in the build carries on at its speed; whatever takes the page on starts from the
    page's own speed.
    - "Configure yours" starts the 3D view at once; not ready by the film's end, it waits on the film's
    last (still) picture rather than halfway into the build.
2026-11-13 Film: the configurator lies under the stage again however the page loads
    The transition into the configurator broke on a real network: the film measured where the configurator
    comes up while warmPaint had it lifted out of the page (fixed, three frames) - +3286 px instead of -659 -
    and nothing measured again (its observer sees its size, which comes back the same). At the merge the
    3D view went off to nowhere and an old film picture showed.
    - warmPaint measures the film again as it puts the configurator back.
    - geometry() reads the 3D view's place together with the viewer's, before it moves the configurator:
    read after, the build was drawn as far off as the configurator moved (-3945 px, off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
2026-11-14 Film: the hold at the table stops the wheel and the finger, and says so readably
    - While the page holds for the 3D view, a wheel or a finger downwards is stopped instead of moving the
    page and being put back: the page is at rest, so the 3D view's heavy steps (each waiting for a rest)
    come at once rather than at their latest. (Listened to only while it holds.)
    - The hold starts the 3D view if it was not started yet.
    - "Preparing the 3D" on a plate of the page's ground: readable over the film's grey table in the dark
    theme too.
2026-11-14 Web: dead code out, one cut of a mesh into its parts
    The explode and the film's build cut a mesh into its parts with the same
    loop and kept the same list of hardware materials: both now in explode.js
    (cutByKey, HARDWARE). Gone: buildCase (never called), a sound string never
    shown, and a mesh tag written and never read.
2026-11-14 Web: every text fits its box, in every width
    - The top rack unit says "top" under its number: beside it, it ran into
    the list (and the unit's column is narrower, the lists wider).
    - A folded step's title never shrinks below its longest word.
    - The piece list and the advanced form's lists show their choice over
    the list, cut with an ellipsis (Safari cut the list's text mid-letter);
    the advanced form's lists, texts and number sets get the whole width.
    - The number beside a slider has the room for its digits (no spin
    buttons there); on a phone the slider goes under its name.
    - Segmented buttons are never narrower than their word.
    - An unused .band.alt rule and a duplicated fold rule are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
